latifannurdiansyah/Laser-tag-project/docs/final-report.docx

LAPORAN PROYEK AKHIR

Bidang

IMPLEMENTASI RANGKAIAN ELEKTRONIK DAN SISTEM KOMUNIKASI MULTI-PEMAIN UNTUK PERMAINAN LASER TAG MENGGUNAKAN ESP-NOW DAN LORA

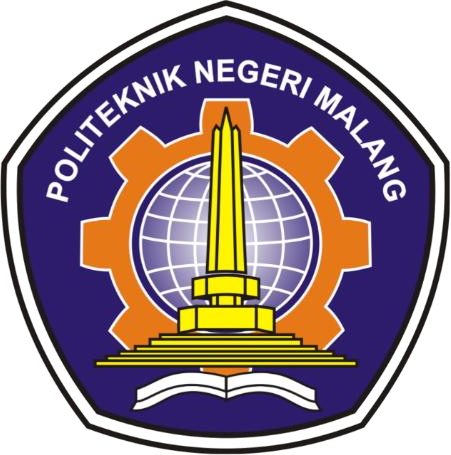
[picture p1: figure]
Logo Polinema (Politeknik Negeri Malang) Format PNG - laluahmad.com

OLEH:

LATIFAN NURDIANSYAH

NIM: 244101077012

PROGRAM STUDI SARJANA TERAPAN

TEKNIK ELEKTRONIKA

JURUSAN TEKNIK ELEKTRO

POLITEKNIK NEGERI MALANG

2026

LAPORAN PROYEK AKHIR

IMPLEMENTASI RANGKAIAN ELEKTRONIK DAN SISTEM KOMUNIKASI MULTI-PEMAIN UNTUK PERMAINAN LASER TAG MENGGUNAKAN ESP-NOW DAN LORA

Oleh:

Latifan Nurdiansyah NIM: 244101077012

PROGRAM STUDI SARJANA TERAPAN

TEKNIK ELEKTRONIKA

JURUSAN TEKNIK ELEKTRO

POLITEKNIK NEGERI MALANG

2026

# HALAMAN PENGESAHAN

IMPLEMENTASI RANGKAIAN ELEKTRONIK DAN SISTEM KOMUNIKASI MULTI-PEMAIN UNTUK PERMAINAN LASER TAG MENGGUNAKAN ESP-NOW DAN LoRa

Oleh:

Latifan Nurdiansyah

244101077012

Proyek Akhir ini telah dipertahankan di depan dewan penguji pada tanggal April 2026 dan disahkan oleh :

Pembimbing I
Nama Pembimbing I | : | Indrazno Siradjuddin, S.T., M.T., Ph.D.
NIP. | : | 197406242000121001 | ……………….
Pembimbing II
Nama Pembimbing II | : | Gillang Al Azhar, S.S.T., M.Tr.T.
NIP. | : | 199506222020121003 | ……………….
Penguji I
Nama Penguji I | : | Denda Dewatama, S.T., M.T.
NIP. | : | 197812272005011001 | ……………….
Penguji II
Nama Penguji II | : | Odhitya Desta Triswidrananta, S.Pd., M.Pd.
NIP. | : | 198912152023211020 | ……………….

Malang, 27 April 2026

Mengetahui, | Menyetujui,
Ketua Jurusan Teknik Elektro | Koordinator Program Studi Sarjana Terapan Teknik Elektronika
Prof. Ir. Mohammad Noor Hidayat, S.T., M.Sc., Ph.D. | Hari Kurnia Safitri, S.T., M.T.
NIP. 197409252001121003 | NIP. 197307132002122002

# PERNYATAAN KEASLIAN PROYEK AKHIR

Saya yang bertanda tangan di bawah ini:

Nama : | Latifan Nurdiansyah
NIM : | 244101077012
Jurusan/Program Studi : | Teknik Elektro/D4 Teknik Elektronika
Judul : | Implementasi rangkaian elektronik dan sistem komuikasi multi-pemain untuk permainan laser tag menggunakan ESP-NOW dan LORA

Menyatakan dengan sebenarnya bahwa:

1. Karya tulis ini benar – benar merupakan hasil karya saya sendiri, bukan merupakan alihan penelitian, tulisan atau pikiran orang lain yang saya akui sebagai hasil proyek akhir, tulisan atau pikiran saya sendiri.
2. Apabila di kemudian hari terbukti atau dapat dibuktikan bahwa karya tulis ini hasil jiplakan (plagiasi), dan saya tidak dapat memenuhi pernyataan saya ini maka saya bersedia menerima sanksi atas perbuatan saya tersebut.

Malang. 27 April 2026

Latifan Nurdiansyah

# ABSTRAK

Latifan Nurdiansyah, 2026. Implementasi Rangkaian Elektronik dan Sistem Komunikasi Multi-Pemain untuk Permainan Laser Tag Menggunakan ESP-NOW dan LoRa.

Proyek Akhir Program Studi Sarjana Terapan Teknik Elektronika, Jurusan Teknik Elektro, Politeknik Negeri Malang, 2026.

Sistem laser tag komersial berbasis Multiple Integrated Laser Engagement System (MILES) yang tersedia saat ini umumnya bersifat tertutup, minim informasi posisi real-time, serta rentan terhadap manipulasi fisik pada sensor inframerah. Kondisi ini membatasi penerapan sistem yang adaptif dan terukur untuk skenario rekreasi maupun kompetisi. Penelitian ini bertujuan untuk mengimplementasikan rangkaian elektronik pada unit senjata, helm, dan rompi dengan mengintegrasikan protokol ESP-NOW dan LoRa pada mikrokontroler ESP32-S3 guna menciptakan komunikasi dua arah dan pencatatan skor real-time melalui antarmuka web. Metodologi yang digunakan menerapkan arsitektur komunikasi dua lapis: ESP-NOW untuk interaksi cepat antar perangkat pada jarak dekat, dan LoRaWAN melalui The Things Network (TTN) untuk pengiriman data jarak jauh ke server berbasis Vercel. Selain itu, mekanisme Anti-Cheating inovatif diterapkan menggunakan photodiode dan gerbang logika NOR 8-input (IC 74HC4078) yang terintegrasi dalam dome sensor TSOP4838. Meskipun dibatasi pada dua unit pemain dengan modulasi inframerah 38 kHz (protokol NEC), pengujian menunjukkan performa yang sangat baik. Sistem mampu menerima sinyal inframerah hingga 200 meter dengan cakupan sudut 180°. Transmisi ESP-NOW mencatat tingkat keberhasilan 100% pada jarak 4 meter meskipun terdapat penghalang, sementara transmisi LoRaWAN berhasil sepenuhnya dengan latensi 3–5 detik. Secara keseluruhan, sistem mencapai hit rate 80% pada jarak 20 meter dalam skenario dua pemain, membuktikan efektivitasnya sebagai solusi laser tag yang transparan dan terukur.

Kata Kunci: Laser Tag, MILES, ESP-NOW, LoRa, Anti-Cheating, ESP32-S3, IoT.

# ABSTRACT

Latifan Nurdiansyah, 2026. Implementation of Electronic Circuits and Multi-Player Communication Systems for Laser Tag Games Using ESP-NOW and LoRa.

Proyek Akhir Program Studi Sarjana Terapan Teknik Elektronika, Jurusan Teknik Elektro, Politeknik Negeri Malang, 2026

Current commercial laser tag systems based on the Multiple Integrated Laser Engagement System (MILES) are generally closed-source, lack real-time positioning information, and are susceptible to physical tampering with Inframerah sensors. Such constraints hinder the implementation of adaptive and scalable systems for both recreational and competitive scenarios. This final project aims to implement electronic circuits in weapon units, helmets, and vests by integrating ESP-NOW and LoRa protocols onto the ESP32-S3 microcontroller to establish two-way communication and real-time score tracking via a web interface. The methodology employs a dual-layer communication architecture: ESP-NOW for rapid near-field device interaction and LoRaWAN via The Things Network (TTN) for long-range data transmission to a Vercel-base server. Additionally, an innovative Anti-Cheating mechanism is implemented using photodiodes and an 8- input NOR logic gate (IC 74HC4078) integrated within a TSOP4838 sensor dome. While limited to two player units utilizing 38 kHz Inframerah modulation (NEC protocol), test results demonstrate robust performance. The system successfully receives Inframerah signals up to 200 meters with a 180° coverage angle. ESP-NOW communication achieved a 100% success rate at 4 meters with obstacles, while LoRaWAN transmission was 100% successful with a latency of 3–5 seconds. Overall, the system reached an 80% hit rate at a 20-meter range in a two-player scenario, proving its effectiveness as a transparent and scalable laser tag solution.

Keywords: Laser Tag, MILES, ESP-NOW, LoRa, Anti-Cheating, ESP32-S3, IoT.

# KATA PENGANTAR

Puji syukur kehadirat Allah SWT yang telah melimpahkan rahmat serta hidayah-Nya, serta memberikan petunjuk serta kesehatan sehingga penulis dapat menyelesaikan Laporan Akhir yang berjudul “Implementasi Rangkaian Elektronik dan Sistem Komunikasi Multi-Pemain untuk Permainan Laser Tag Menggunakan ESP-NOW dan LoRa”. Pada kesempatan ini penulis mengucapkan terimakasih kepada pihak-pihak yang telah membantu dan membimbing dalam penyusunan Laporan Akhir, yaitu kepada :

1. Bapak Ir. Supriatna Adhisuwignjo, S.T., M.T. selaku Direktur Politeknik Negeri Malang beserta jajarannya.
2. Bapak Prof. Ir. Mohammad Noor Hidayat, S.T., M.Sc., Ph.D. selaku Ketua Jurusan Teknik Elektro beserta jajarannya.
3. Ibu Hari Kurnia Safitri, ST., MT. selaku Ketua Program Studi Sarjana Terapan Teknik Elektronika beserta jajarannya.
4. Bapak Indrazno Siradjuddin, S.T., M.T., Ph.D. selaku Dosen Pembimbing 1, yang telah membimbing dan mendampingi sepenuh hati dari awal hingga akhir penelitian proyek akhir ini.
5. Bapak Gillang Al Azhar, S.S.T., M.Tr.T. selaku Dosen Pembimbing 2, yang telah membimbing dari awal hingga akhir penelitian proyek akhir ini.
6. Seluruh Dosen dan Staff Politeknik Negeri Malang, khususnya pada Program Studi Sarjana Terapan Teknik Elektronika.
7. Orang tua dan Keluarga Besar Ma’ Saropah yang telah memberi dukungan do’a dan materi dan juga memberikan apapun yang aku butuhkan.
8. Teman Teman Lab Robotics Polinema yang dengan senang hati bertukar ilmu dan pikiran
9. Ahmad Firdan Al Hadi, Akbar Dimas Herdiansyah, Jati Wahyu Kusuma, Maharani Inggrid J. dan Syahrul Zanuar, mereka saya anggap seperti keluarga seperjuangan yang selalu memberikan motivasi untuk terus melangkah sampai dengan menyelesaikan laporan proyek akhir akhir saya.
10. Mahasiswa dengan NIM 2142520038 Jurusan Akutansi yang selalu memeberikan dukungan penulis dalam mengerjakan laporan ini dalam suka maupun duka, memberikan segenap rasa sakit, senang, semangat, motivasi, cinta dan kasih dalam membimbing dan membantu laporan proyek akhir saya sampai dengan selesai.
11. Teman-teman mahasiswa dan pihak yang telah membantu dalam penyusunan Laporan Akhir ini.

Penulis menyadari masih banyak kekurangan dan pembuatan proyek akhir ini. Oleh karena itu, penulis mengharapkan saran dan kritik yang bersifat membangun dan semoga proyek akhir ini dapat bermanfaat.

Malang, 27 April 2026

Penulis

# DAFTAR ISI

# DAFTAR GAMBAR

# DAFTAR TABEL

# BAB I PENDAHULUAN

## 1.1 Latar Belakang

Perkembangan teknologi digital telah membawa perubahan signifikan dalam dunia hiburan interaktif dan simulasi pelatihan militer modern. Salah satu manifestasinya adalah sistem Laser Tag berbasis Multiple Integrated Laser Engagement System (MILES), yaitu simulasi tempur yang menggunakan pancaran cahaya Inframerah sebagai pengganti peluru nyata. Pada sistem MILES, setiap senjata dilengkapi Small Arm Transmitter (SAT) yang memancarkan sinyal Inframerah berprotokol NEC berfrekuensi 38 kHz saat pelatuk ditarik, kemudian dideteksi oleh sensor penerima TSOP4838 pada rompi atau helm lawan (Siradjuddin et al., 2024). Meski efektif sebagai platform pelatihan maupun hiburan kompetitif, sistem MILES konvensional membutuhkan perangkat keras yang mahal, infrastruktur kompleks, dan konsumsi daya tinggi, sehingga sulit diterapkan secara luas pada komunitas dengan anggaran terbatas. Perkembangan teknologi Internet Of Things (IoT) kini membuka peluang baru untuk merancang sistem Laser Tag yang lebih terjangkau, modular, dan terhubung secara digital melalui kombinasi protokol ESP-NOW untuk komunikasi jarak dekat antar pemain, dan LoRaWAN untuk pengiriman data ke server pusat jarak jauh secara real-time (Hailan et al., 2024; Konate et al., 2025).

Beberapa penelitian sebelumnya telah mengembangkan sistem berbasis sinar inframerah (IR) untuk simulasi pertempuran, seperti Multiple Integrated Laser Engagement System (MILES), yang mampu mengidentifikasi pemain melalui kode digital dan memberikan umpan balik saat terkena tembakan (Siradjuddin et al., 2024). Meski efektif, sistem semacam ini biasanya membutuhkan perangkat keras mahal, konsumsi daya tinggi, dan infrastruktur yang kompleks—sehingga kurang layak untuk diterapkan dalam skenario rekreasi atau komunitas dengan anggaran terbatas.Perkembangan teknologi Internet Of Things (IoT) membuka peluang baru untuk merancang sistem Laser Tag yang lebih terjangkau, modular, dan terhubung. Dua protokol komunikasi nirkabel yang menarik untuk diintegrasikan adalah ESP-NOW dan LoRa. ESP-NOW, yang berjalan pada mikrokontroler ESP32, memungkinkan komunikasi peer-to-peer berkecepatan tinggi dengan latensi sangat rendah tanpa memerlukan jaringan Wi-Fi (Hailan et al., 2024). Protokol ini ideal untuk mengirimkan data tembakan antar pemain dalam jarak dekat (hingga ±30 meter), seperti dari helm ke rompi atau antar rompi pemain yang saling berinteraksi. Namun, jangkauannya terbatas, sehingga tidak memadai untuk arena permainan skala luas.

Di sisi lain, teknologi LoRa (Long Range) menawarkan kemampuan transmisi data hingga beberapa kilometer dengan konsumsi daya sangat rendah (Konate et al., 2025; Yahya et al., 2024). Dengan LoRa, data permainan—seperti skor, posisi berdasarkan modul GPS, atau status nyawa—dapat dikirim ke Gateway pusat dan ditampilkan melalui antarmuka web, memungkinkan pemantauan real-time oleh wasit, pelatih, atau penonton. Kombinasi kedua protokol ini menciptakan arsitektur komunikasi dua lapis: ESP-NOW untuk interaksi cepat antar pemain, dan LoRa untuk integrasi ke sistem eksternal jarak jauhBerdasarkan latar belakang maka, pada proyek akhir ini akan dikembangkan sistem Permainan Laser Tag Menggunakan ESP-NOW dan LoRa. Sistem yang dirancang terdiri dari helm dan rompi yang dilengkapi sensor Inframerah, modul GPS, serta modul komunikasi berbasis ESP32. Data dari hasil deteksi maupun posisi pemain akan dikirim melalui ESP-NOW dan LoRa ke server, lalu ditampilkan dalam bentuk web interface secara real-time.

## 1.2 Rumusan Masalah

Berdasarkan latar belakang di atas, dapat dirumuskan beberapa masalah sebagai berikut:

a. Bagaimana mengimplementasikan rangkaian elektronik pada sistem tembak (senjata) serta rangkaian penerima (helm dan rompi), dan membangun sistem komunikasi dua arah antara server dan banyak unit pemain?
b. Bagaimana mengintegrasikan protokol ESP-NOW dan LoRa pada mikrokontroler untuk mendukung komunikasi real-time dalam permainan Laser Tag?
c. Bagaimana mengimplementasikan sistem komunikasi dua arah untuk mendukung pencatatan skor secara real-time?

## 1.3 Batasan Masalah

Untuk memfokuskan proyek akhir, diberikan pembatasan masalah sebagai berikut:

a. Komunikasi nirkabel hanya menggunakan ESP-NOW (jarak dekat antar helm dan rompi) dan LoRa (jarak jauh ke server), dengan sistem terbatas pada maksimal 2 klien dan 1 server, serta hanya mengirim data status tanpa audio, video, atau enkripsi tingkat lanjut
b. Sistem hanya menggunakan sensor inframerah dengan modulasi 38 kHz sesuai protokol NEC, termasuk rangkaian IR receiver Anti-Cheating yang dirancang untuk beroperasi di siang hari, dan khusus diterapkan dalam permainan laser tag.
c. Sumber daya dibatasi pada baterai lithium-ion untuk senjata, rompi, dan helm, tanpa membahas alternatif sumber daya, pengisian daya, lokasi minim sinyal seluler, maupun aspek keamanan siber atau enkripsi data.
d. Anti-Cheating tidak difungsikan dalm kondisi merayap, terhalang pohon/bangunan

## 1.4 Tujuan

Berdasarkan rumusan masalah yang telah ditetapkan terdapat beberapa tujuan dari proyek akhir ini. Berikut merupakan tujuan dari proyek akhir ini:

a. Mengimplementasikan rangkaian elektronik pada sistem tembak (senjata) serta rangkaian penerima (helm dan rompi) dan sistem komunikasi dua arah antara server dan banyak unit pemain
b. Mengintegrasikan protokol ESP-NOW dan LoRa pada mikrokontroler untuk mendukung komunikasi real-time dalam permainan Laser Tag.
c. Mengembangkan sistem komunikasi dua arah untuk mendukung pencatatan skor secara real-time.

## 1.5 Sistematika Penulisan

Pembahasan dalam proyek akhir ini disusun secara terstruktur dalam lima bab utama, yang masing-masing memiliki fokus tersendiri sesuai dengan alur proyek akhir dan pengembangan sistem. Sistematika penulisan pada laporan proyek akhir ini :

Bab I Pendahuluan

Bab ini berisi latar belakang pemilihan topik proyek akhir, rumusan masalah beserta batasan masalah yang diteliti. Selain itu, juga dijelaskan tujuan proyek akhir serta manfaat yang ingin dicapai. Bab ini juga memberikan gambaran umum mengenai struktur penulisan laporan proyek akhir.

Bab II Tinjauan Pustaka

Bab ini membahas materi teoretis yang relevan dengan proyek akhir, termasuk konsep-konsep dasar, teknik, peralatan, atau teknologi yang digunakan dalam proses proyek akhir. Selain itu, juga disertakan referensi pustaka dan hasil proyek akhir sebelumnya yang menjadi dasar pengembangan sistem.

Bab III Metodologi

Bab ini menjelaskan secara rinci pendekatan atau metode yang digunakan dalam melaksanakan proyek akhir. Meliputi desain sistem, tahapan pengembangan, alur kerja, serta langkah-langkah yang dilakukan untuk mencapai tujuan proyek akhir.

Bab IV Hasil Dan Pembahasan

Pada bab ini disajikan hasil implementasi sistem, data pengujian perblok dan keseluruhan, serta analisis yang dilakukan berdasarkan metode proyek akhir yang telah ditetapkan. Pembahasan bertujuan untuk mengevaluasi kinerja sistem dan membandingkannya dengan tujuan serta hipotesis awal.

Bab V Penutup

Bab terakhir ini memuat kesimpulan utama dari seluruh rangkaian proyek akhir, berdasarkan hasil dan pembahasan yang telah diuraikan. Selain itu, juga disertakan saran-saran untuk pengembangan sistem pada proyek akhir lanjutan.

## 1.6 Luaran Laporan Proyek Akhir

Proyek akhir ini memiliki 4 luaran yaitu

a. Naskah Laporan proyek akhir
b. Alat Sistem berupa senjata, helm dan rompi
c. Manual Book
d. Artikel yang disubmit di jurnal yang ber-ISSN.

# BAB II TINJAUAN PUSTAKA

## 2.1 Kajian Pustaka

Berikut adalah beberapa hasil penelitian terdahulu yang relevan dengan topik proyek akhir ini dan dapat digunakan sebagai landasan dan tinjauan pustaka untuk mendukung acuan proyek akhir ini sebagai berikut.

Dalam dunia pelatihan militer modern, simulasi tempur yang realistis dan aman menjadi kebutuhan utama untuk meningkatkan kesiapan tempur tanpa harus mengorbankan nyawa atau menggunakan amunisi aktif. Salah satu teknologi yang telah lama dikembangkan dan digunakan secara luas untuk tujuan ini adalah Multiple Integrated Laser Engagement System (MILES). Sistem ini memungkinkan simulasi pertukaran tembakan antar personel atau kendaraan tempur dengan menggunakan pancaran cahaya Inframerah (IR) sebagai pengganti peluru. Pada sistem MILES, setiap senjata dilengkapi dengan perangkat yang disebut Small Arm Transmitter (SAT), yang memancarkan sinyal Inframerah saat pelatih menembakkan senjata. Sinyal ini kemudian dideteksi oleh sensor IR pada lawan, yang mencatat "kena tembak" berdasarkan data identitas pemain (Player ID/PID) yang turut dikodekan dalam sinyal tersebut. Oleh karena itu, performa SAT sangat menentukan keberhasilan simulasi, termasuk jangkauan deteksi, akurasi respon waktu, dan reliabilitas transmisi data.(Siradjuddin et al., 2024).

Salah satu komponen krusial dalam SAT adalah Inframerah (IR) emitter Driver circuit, yang mengendalikan arus listrik ke LED Inframerah berdaya tinggi, memastikan pancaran cahaya IR dengan intensitas optimal dan waktu respons yang cepat. Desain rangkaian ini menjadi fokus utama dalam proyek akhir (Siradjuddin et al., 2024), yang memperkenalkan rancangan baru sirkuit penggerak emitter Inframerah khusus untuk aplikasi SAT dalam sistem MILES. Tujuan dari desain ini adalah untuk memaksimalkan daya optik dan memastikan frekuensi pensaklaran 38 kHz yang sesuai dengan standar protokol komunikasi IR NEC, yang menjadi kunci dalam efektivitas komunikasi Inframerah.(Siradjuddin et al., 2024)

Menurut jurnal Wireless Inframerah Communications: A Survey, komunikasi Inframerah memanfaatkan propagasi cahaya pada pita near-Inframerah dengan pemancar berupa LED atau laser diode dan penerima berupa silicon p-i-n photodiode karena efisiensinya yang baik dan biaya rendah. Sistem ini menggunakan teknik Intensity Modulation with Direct Detection (IM/DD), di mana arus fotodetektor sebanding dengan intensitas optik yang diterima. Namun, penerimaan sinyal dapat terganggu oleh sumber cahaya sekitar seperti sinar matahari atau lampu, sehingga diperlukan filter optik dan pemilihan modulasi yang tepat untuk menjaga kualitas sinyal. Sementara itu, menurut jurnal Wireless Inframerah Communications, komunikasi Inframerah menawarkan keunggulan dibanding radio, seperti bandwidth yang sangat besar, biaya rendah, serta keamanan tinggi karena sinyal tidak menembus dinding. Selain itu, penggunaan IM/DD dengan detektor berukuran besar mencegah terjadinya multipath fading, sehingga desain sistem lebih sederhana. Meski begitu, keterbatasan komunikasi Inframerah adalah jangkauannya yang terbatas, kebutuhan daya pancar relatif tinggi, serta sensitivitas terhadap noise cahaya sekitar.(Kahn & Barry, 1997; Zade et al., 2012)

Menurut jurnal Penerapan Protokol Komunikasi ESP-NOW pada Portable Traffic Light, implementasi komunikasi berbasis ESP-NOW dengan skema master–slave mampu bekerja stabil dengan tingkat error rata-rata hanya 3% dan jangkauan optimal hingga 25 meter meskipun terdapat halangan berupa casing modul. Sementara itu, pada jurnal ESPNOW Protocol-Based IIoT System for Remotely Monitoring and Controlling Industrial Systems, ESP-NOW dimanfaatkan untuk menghubungkan beberapa node sensor dalam sistem Industrial Internet Of Things (IIoT), yang terbukti mendukung pemantauan industri secara real-time dengan latensi rendah, konsumsi daya hemat, serta keamanan data yang terjamin melalui enkripsi. Di sisi lain, proyek akhir berjudul Indoor Performance Evaluation of ESP-NOW mengevaluasi performa ESP-NOW dalam kondisi indoor dan menemukan bahwa meskipun faktor lingkungan seperti pantulan dan penghalang dapat memengaruhi kinerja, protokol ini tetap menunjukkan efisiensi daya lebih dari 30% dibanding Wi-Fi serta jangkauan yang lebih baik hingga 15%. Berdasarkan temuan-temuan tersebut, ESP-NOW sangat relevan untuk digunakan pada sistem permainan Laser Tag, di mana komunikasi antar perangkat harus berlangsung cepat, stabil, dan hemat daya dalam area permainan.(Fajar Arofah et al., 2023; Hailan et al., 2024; Urazayev et al., 2023)

Menurut proyek akhir Design and Implementation of a Backscatter Communication System Based on LoRa Technology, LoRa backscatter mampu meningkatkan efisiensi energi dan memperluas jangkauan komunikasi dengan memanfaatkan sinyal pantulan dari perangkat pasif, sehingga sangat potensial untuk aplikasi IoT berskala besar. Sementara itu, dalam jurnal Analisa Performansi Komunikasi LoRa (Long Range) pada Sistem Monitoring Buoy di Laut, komunikasi LoRa 915 MHz terbukti dapat menjaga kualitas dengan nilai RSSI rata-rata lebih baik dari -120 dB dan SNR lebih besar dari -20 dB meskipun terdapat interferensi, sehingga layak digunakan untuk sistem monitoring di lingkungan laut. Selanjutnya, hasil proyek akhir Analisis Jarak Jangkauan LoRa (Long Range) di Lingkungan Urban, menunjukkan bahwa jangkauan LoRa di area perkotaan dapat mencapai hingga 2 km dengan nilai RSSI relatif stabil, meskipun packet loss meningkat pada jarak yang lebih jauh. Dari ketiga kajian tersebut dapat disimpulkan bahwa LoRa tidak hanya handal untuk komunikasi jarak jauh dengan konsumsi energi rendah, tetapi juga fleksibel untuk diterapkan dalam berbagai skenario, baik di laut, lingkungan urban, maupun melalui dukungan teknologi backscatter.(Konate et al., 2025; Nihayatus Sa’adah et al., 2024; Yanziah et al., 2020)

Global Positioning System (GPS) merupakan sistem navigasi berbasis satelit yang terdiri dari 24 satelit operasional yang mengorbit Bumi dan menyediakan informasi posisi secara kontinu melalui tiga segmen utama, yaitu segmen pengguna, ruang angkasa, dan kontrol, dimana menurut jurnal "Implementation of GPS for Location Tracking", data yang diterima berupa format NMEA-0183 yang berisi koordinat latitude dan longitude yang perlu diekstrak untuk memperoleh data posisi. Menurut jurnal "Missing Pilgrims Tracking System Using GPS, GSM and Arduino Microcontroller", GPS merupakan sistem navigasi universal yang dapat bekerja dalam segala kondisi cuaca dan dapat dikombinasikan dengan teknologi GSM untuk menghasilkan sistem pelacakan berbasis peta digital, sementara jurnal "A GPS Receiver for High-Altitude Satellite Navigation" mengatakan bahwa GPS telah digunakan untuk navigasi satelit presisi di orbit rendah Bumi (LEO), meskipun penerapannya di orbit geosinkron (GEO) masih terbatas akibat lemahnya sinyal. Lebih lanjut, GPS merupakan bagian dari GNSS (Global Navigation Satellite System) bersama dengan GLONASS, BeiDou, dan Galileo, dengan akurasi 3–10 meter di lingkungan outdoor, namun menurun menjadi 30–100 meter di indoor sehingga mendorong pengembangan Indoor Positioning System (IPS) berbasis RTK dengan akurasi hingga 2 cm atau teknologi UWB dengan akurasi 20 cm, serta aspek waktu yang penting dimana distribusi UTC melalui sinyal GPS memiliki akurasi ≤30 nanodetik.(Ariffin et al., 2011; Itera, 2021; Parveen & Aldhlan, 2016; Winternitz et al., 2009)

Menurut proyek akhir Web Server Based Smart Agriculture System for Real-Time Monitoring and Control, pemanfaatan web server dalam integrasi IoT memungkinkan penyajian data sensor secara real-time melalui dashboard interaktif yang mendukung sistem pertanian cerdas. Hal ini sejalan dengan studi A Web Server-Based IoT System for Monitoring and Control of Agricultural Environment, yang menekankan pentingnya akses global dan pengelolaan data terdistribusi secara aman melalui jaringan berbasis web. Lebih lanjut, proyek akhir Real-Time Monitoring of Cable Sag and Overhead Line Parameters Based on a Distributed Sensor Network and Implementation in a Web Server and IoT, menunjukkan bagaimana web server dipadukan dengan database MySQL dan IoT server untuk memantau kondisi kabel transmisi listrik secara aman, baik melalui intranet maupun internet. Sementara itu, jurnal Web-Based Integration of IoT and Artificial Intelligence for Monitoring Aquariums, menegaskan bahwa dashboard web mampu membangun visualisasi interaktif yang membantu pengawasan kondisi lingkungan, seperti suhu, pH, dan kecerahan air pada sistem akuarium pintar. Dari keempat kajian tersebut, dapat disimpulkan bahwa web server berperan penting dalam integrasi IoT, tidak hanya untuk pemantauan data sensor secara real-time, tetapi juga dalam mendukung keamanan akses, keterhubungan global, serta pengembangan dashboard interaktif yang relevan untuk berbagai bidang, mulai dari pertanian, energi, hingga sistem hiburan seperti permainan Laser Tag.(Deepika & Renuka Prasad, 2023; Guerbaoui et al., 2025; Nicola et al., 2024; Nugraha & Rosita, 2024).

## 2.2 Teori Penunjang

### 2.2.1 Baterai Lithium Ion

Baterai Lithium-Ion (Li-ion) merupakan salah satu jenis sel baterai sekunder (rechargeable) yang paling banyak digunakan dalam sistem elektronika portabel dan perangkat berbasis mikrokontroler. Keunggulannya terletak pada rapat energi yang tinggi, konsumsi daya rendah, dan ukuran yang kompak (Lesmana et al., 2023). Dalam aplikasi sistem embedded seperti yang dirancang pada proyek akhir ini, baterai Lithium-Ion sering dikonfigurasi dalam bentuk pack seri untuk menghasilkan tegangan yang sesuai dengan kebutuhan sistem. Misalnya, konfigurasi 2S (2 seri) menghasilkan tegangan nominal sekitar 7,4 V, yang dapat digunakan untuk menyuplai daya ke mikrokontroler, motor, modul komunikasi, dan sensor melalui regulator tegangan (step-down converter). Dengan rumus pemakaian sebagai berikut:

Kapasitas Baterai (mAh) = Arus (mA) × Waktu (jam)

Dalam proyek permainan laser tag ini baterai Lithium Ion digunakan sebagai catu daya pada senjata, helm dan juga rompi. Pemilihan baterai ini didasarkan pada kemampuannya menyediakan energi secara efisien dengan bobot yang ringan, sehingga memungkinkan perangkat beroperasi secara mandiri di lapangan tanpa ketergantungan pada sumber daya eksternal. Hal ini sangat penting dalam mendukung mobilitas tinggi dan fleksibilitas gerak selama permainan berlangsung.

Penggunaan baterai Lithium-Ion memerlukan perlakuan khusus pada proses pengisian daya agar performa dan umur pakai baterai tetap terjaga. Proses pengisian baterai Li-ion umumnya menggunakan metode Constant Current–Constant Voltage (CC-CV), yaitu pengisian dengan arus konstan pada tahap awal dan dilanjutkan dengan tegangan konstan hingga baterai mencapai kondisi penuh. Pada penelitian ini digunakan charger Black Cell tipe XH1000/XH2000 yang mendukung baterai Li-ion 2S 7,4 V dengan fitur intelligent smart charging dan balance charging. Fitur tersebut memungkinkan setiap sel baterai diisi secara seimbang sehingga dapat meningkatkan keamanan dan memperpanjang usia pemakaian baterai.

Selain metode pengisian yang tepat, baterai Li-ion juga harus dilengkapi dengan sistem proteksi seperti Battery Management System (BMS) atau modul protection untuk mencegah terjadinya overcharge, overdischarge, arus berlebih, serta hubungan singkat. Tegangan baterai tidak disarankan turun terlalu rendah karena dapat menyebabkan penurunan kapasitas dan kerusakan sel. Penggunaan arus pengisian yang sesuai dengan kapasitas baterai juga perlu diperhatikan agar suhu baterai tetap stabil selama proses charging berlangsung. Pada baterai tipe 14500, arus pengisian sebesar 1 A dinilai lebih aman dan sesuai dibandingkan arus yang terlalu besar.

Berdasarkan karakteristik tersebut, baterai Lithium-Ion sangat sesuai digunakan pada sistem permainan laser tag karena mampu menyediakan suplai daya yang stabil, ringan, dan mudah diisi ulang. Namun demikian, perlakuan terhadap baterai harus dilakukan dengan benar, terutama pada proses charging dan penggunaan sehari-hari, agar sistem dapat bekerja secara optimal serta menjaga keamanan pengguna dan perangkat elektronika yang digunakan.

### 2.2.2 Regulator Tegangan

Regulator tegangan adalah perangkat yang digunakan untuk menjaga kestabilan tegangan pada suatu sistem kelistrikan, meskipun terjadi fluktuasi pada tegangan masukan. Fungsi utama regulator tegangan adalah untuk memastikan tegangan output tetap pada nilai yang diinginkan, melindungi perangkat elektronik atau sistem yang sensitif terhadap perubahan tegangan yang ekstrem. Regulator tegangan dapat dibedakan menjadi dua jenis utama, yaitu regulator linear dan regulator switching. Regulator linear menurunkan tegangan dengan cara mengalirkan arus melalui komponen pengatur, namun sering menghasilkan banyak panas dan kurang efisien. Sementara regulator switching menggunakan metode pemutusan dan penyambungan untuk mengatur tegangan dengan lebih efisien, menghasilkan sedikit energi terbuang.

Prinsip kerja regulator tegangan didasarkan pada kemampuan untuk mengontrol aliran listrik sesuai dengan perbedaan antara tegangan masukan dan tegangan output yang diinginkan. Regulator linear mengurangi tegangan melalui komponen elektronik seperti transistor, Rangkaian dasar regulator tegangan yang digunakan dalam sistem ini ditunjukkan pada Gambar 1 regulator ini mampu menghasilkan tegangan keluaran stabil pada 5 V dengan toleransi antara 4,75 V hingga 5,25 V, meskipun terdapat variasi pada tegangan masukan (7–25 V) maupun perubahan arus beban (5 mA hingga 1,5 A). Regulator ini memiliki tingkat penolakan ripple yang tinggi (62–78 dB), resistansi output sangat rendah (sekitar 0,017 Ω), serta noise output kecil (sekitar 40 µV), sehingga mampu memberikan suplai daya yang bersih untuk rangkaian sensitif. Selain itu, dropout voltage sekitar 2 V menunjukkan bahwa tegangan masukan minimal harus lebih besar dari 7 V untuk menghasilkan 5 V stabil pada keluaran. Dengan adanya proteksi arus pendek hingga 750 mA serta kemampuan arus puncak hingga 2,2 A, LM7805 menjadi regulator tegangan yang handal untuk berbagai aplikasi elektronika..

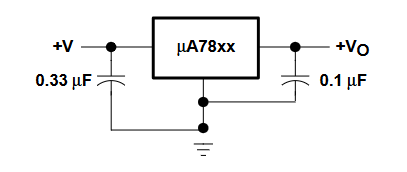
[picture p2: figure]

Gambar 1 Regulator LM7805

Sumber: Datasheet LM7805(Texas, 1976)

### 2.2.3 Rangkaian Push Pull

Rangkaian Push-Pull merupakan konfigurasi elektronika daya yang menggunakan dua transistor aktif (biasanya satu NPN dan satu PNP, atau satu NMOS dan PMOS) untuk mengendalikan arus beban ke atas dan ke bawah secara bergantian. Konfigurasi ini memungkinkan sirkuit menghasilkan output dengan impedansi rendah, kemampuan sinkronisasi tinggi, serta respon frekuensi yang baik. Rangkaian Push-Pull banyak digunakan dalam penguat daya (power amplifier), penggerak motor, dan aplikasi digital seperti Driver MOSFET atau buffer logika.

Dalam konteks sistem simulasi tembakan berbasis sensor, rangkaian Push-Pull dapat diterapkan sebagai unit penguat (amplifier) untuk pulsa inframerah atau sebagai Driver untuk aktuator seperti buzzer, LED, atau motor miniatur pada alat pelatihan tempur. Rangkaian Push-Pull bekerja dengan prinsip bahwa salah satu transistor berfungsi "mendorong" arus (push) ke beban, sedangkan transistor lainnya berfungsi "menarik" arus (pull) dari beban, bergantung pada polaritas sinyal input. Dengan demikian, rangkaian mampu menghasilkan gelombang keluaran yang simetris dan hampir tidak terdistorsi.

Konfigurasi Dasar:

- Transistor atas (push): Biasanya tipe PNP atau PMOS, aktif saat sinyal input bernilai negatif atau rendah, menyalurkan arus dari VCC ke beban.
- Transistor bawah (pull): Tipe NPN atau NMOS, aktif saat sinyal input bernilai positif atau tinggi, menyalurkan arus dari beban ke ground.
- Beban (load): Terhubung di titik tengah (midpoint) antara kedua transistor.

Ketika sinyal input bernilai tinggi (positif), transistor NPN (bawah) aktif sehingga beban terhubung ke ground. Sebaliknya, ketika sinyal input bernilai rendah (negatif), transistor PNP (atas) aktif sehingga beban mendapatkan arus dari VCC. Hasilnya adalah beban selalu dalam kondisi tereksitasi oleh salah satu transistor, tanpa kondisi high-impedance (floating). Berikut merupakan gambar Rangkaian Dasar Push-Pull dapat dilihat pada Gambar berikut.

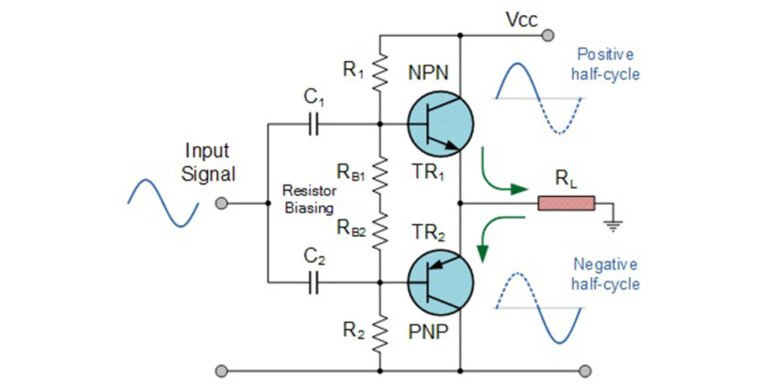
[picture p3: figure]
Push-pull output high and low level voltage diagram

Gambar 2 Rangkaian Dasar Push-Pull

Sumber: (Instrument, 2021)

Analisis matematis rangkaian Push-Pull mengacu pada karakteristik transistor bipolar (BJT) maupun MOSFET. Berikut adalah persamaan-persamaan dasar yang digunakan dalam perancangan:

a. Arus Kolektor Transistor (BJT)

Arus kolektor (IC) transistor BJT dinyatakan sebagai fungsi dari arus basis (IB) dan penguatan arus (hFE atau β):

IC = β × IB

Keterangan:

IC = Arus kolektor (A)

β (hFE) = Penguatan arus DC transistor (dari datasheet)

IB = Arus basis (A)

b. Tegangan Saturasi dan Cutoff

Transistor bekerja dalam dua mode utama pada rangkaian Push-Pull:

- Saturasi (ON): VCE ≈ VCE(sat), umumnya 0,2–0,4 V untuk BJT.
- Cutoff (OFF): IC ≈ 0, transistor tidak mengalirkan arus.

VOUT = VCC - VCE(sat)

Keterangan:

VOUT = Tegangan output pada kondisi saturasi (V)

VCC = Tegangan catu daya (V)

VCE(sat) = Tegangan saturasi kolektor-emitter (V), dari datasheet

c) Arus Beban (Load Current)

Arus yang mengalir melalui beban dihitung berdasarkan tegangan output dan nilai resistansi beban:

ILOAD = VOUT / RLOAD

Keterangan:

ILOAD = Arus yang mengalir ke beban (A)

VOUT = Tegangan output rangkaian (V)

RLOAD = Resistansi beban (Ohm, Ω)

d) Daya Disipasi Transistor

Daya yang didisipasikan oleh masing-masing transistor saat kondisi aktif adalah:

PD = VCE × IC

Nilai PD harus lebih kecil dari PD(max) yang tertera pada datasheet transistor untuk mencegah kerusakan termal. Apabila diperlukan heatsink, maka resistansi termal total dihitung sebagai:

θJA = (TJ(max) - TA) / PD

Keterangan:

PD = Daya disipasi transistor (Watt)

VCE = Tegangan kolektor-emitter saat aktif (V)

IC = Arus kolektor (A)

θJA = Resistansi termal junction-ke-ambient (°C/W)

TJ(max) = Suhu junction maksimum (°C), dari datasheet

TA = Suhu ambient (°C)

e) Efisiensi Rangkaian Push-Pull Kelas B

Efisiensi teoritis maksimum untuk Push-Pull Kelas B adalah:

ηmax = (π/4) × (VOUT(peak)/VCC) × 100%

Pada kondisi sinyal penuh (VOUT(peak) ≈ VCC), efisiensi teoritis maksimum Push-Pull Kelas B mencapai π/4 × 100% ≈ 78,5%, jauh lebih tinggi dibandingkan penguat Kelas A (≤25%).

### 2.2.4 Transmitter Inframerah

Transmiter Inframerah adalah perangkat elektronik yang menggunakan sinyal Inframerah untuk mengirimkan data atau perintah kepada perangkat penerima. Sinyal Inframerah dihasilkan oleh Light Emitting Diode (LED) Inframerah yang mengubah data digital menjadi pulsa cahaya. Pulsa ini diterima oleh sensor penerima seperti Phototransistor, yang kemudian mendekodekannya menjadi data digital kembali. Panjang gelombang Inframerah yang umum digunakan berkisar antara 700 nm hingga 1 mm, tergantung pada aplikasinya.

Transmitter Inframerah menawarkan kecepatan transfer data yang tinggi, keamanan yang baik karena sinyalnya tidak menembus dinding, serta biaya produksi yang relatif rendah. Namun, teknologinya memiliki keterbatasan, seperti kebutuhan akan jalur pandang langsung antara Transmitter dan receiver serta kerentanan terhadap interferensi dari cahaya matahari (Yunardi, 2017).

Inframerah LED (IR LED) adalah jenis dioda emisi cahaya (LED) yang memancarkan radiasi elektromagnetik pada panjang gelombang Inframerah (~700 nm hingga 1 mm), yang tidak terlihat oleh mata manusia namun dapat dideteksi oleh photodiode atau fototransistor IR. Cahaya Inframerah yang dipancarkan oleh LED ini sering digunakan dalam sistem remote control, proximity sensing, pendeteksi gerakan, dan komunikasi nirkabel jarak dekat. Berikut merupakan gambar Inframerah LED dapat dilihat pada Gambar 9.

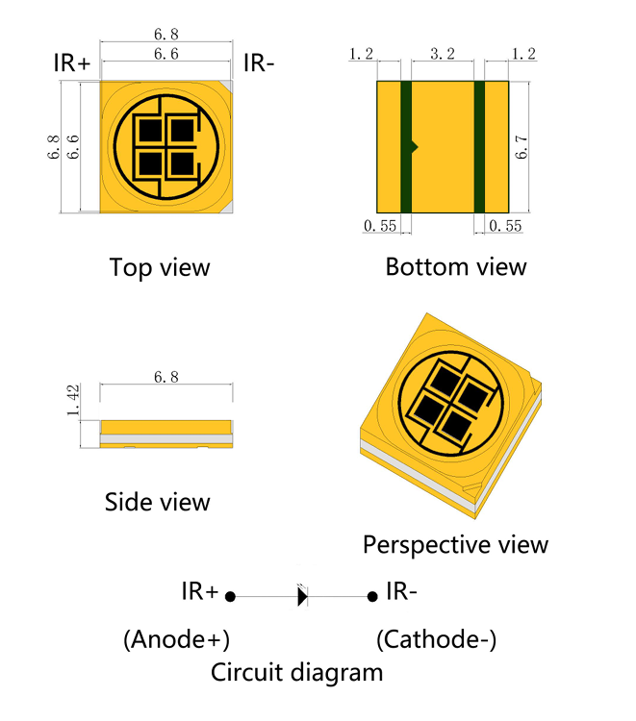
[picture p4: figure]

Gambar 3 Inframerah LED

Sumber: M. Ali et al. (2021)

Prinsip kerja IR LED pada gambar 2.15 mirip dengan LED biasa, yaitu mengubah arus listrik menjadi foton cahaya. Namun, material semikonduktor yang digunakan dirancang agar memancarkan cahaya di rentang Inframerah. Pada sistem permainan laser tag, IR LED digunakan sebagai bagian dari Small Arms Transmitter (SAT) untuk memancarkan pulsa Inframerah setiap kali pelatuk senjata ditarik. Pulsa tersebut membawa informasi identifikasi senjata dan waktu penembakan yang akan diterima oleh sensor IR pada target.

IR LED dalam SAT harus dirancang untuk bekerja dalam kondisi lapangan yang keras, termasuk paparan debu, guncangan fisik, dan variasi suhu. Oleh karena itu, banyak modul IR LED dilengkapi dengan lensa Fresnel untuk meningkatkan jarak pancar dan akurasi deteksi. Selain itu, pulsa yang dikirimkan bersifat encoded agar dapat dibedakan antara tembakan dari satu senjata dengan senjata lain, memastikan evaluasi hasil tembakan akurat dan real-time.

### 2.2.5 Modulasi dan Demodulasi Inframerah

Modulasi dan demodulasi Inframerah merupakan dua proses yang saling terkait dalam komunikasi berbasis cahaya Inframerah. Modulasi adalah proses menumpangkan sinyal informasi (misalnya data digital) pada gelombang pembawa Inframerah, sedangkan demodulasi adalah proses memisahkan kembali sinyal informasi dari gelombang pembawa yang telah dimodulasi.

1. Modulasi Inframerah

Modulasi Inframerah adalah proses memodifikasi sinyal Inframerah untuk membawa informasi spesifik seperti perintah kontrol maupun data digital. Teknologi ini sangat penting pada aplikasi seperti sistem komunikasi nirkabel yang menggunakan diode pemancar Inframerah (IR) dan penerima IR, misalnya pada perangkat kontrol jarak jauh, sensor kedekatan, serta sistem pengenalan dan keamanan serupa lainnya.

Dalam modulasi Inframerah, impuls cahaya yang dipancarkan oleh IR-LED dimodulasi sesuai dengan pola biner yang mewakili data. Proses ini dilakukan dengan mengatur arus penggerak pada IR-LED, sehingga intensitas cahaya Inframerah berubah sesuai dengan data yang ingin ditransmisikan.

Metode modulasi yang paling umum digunakan adalah Carrier Frequency Modulation (CFM), yaitu modulasi pada frekuensi pembawa. Pada sistem ini, sinyal data digunakan untuk mendukung atau mengubah fase dan amplitudo gelombang pembawa Inframerah pada frekuensi tertentu (biasanya 36-38kHz). Teknik ini memungkinkan penerima Inframerah dapat membedakan sinyal yang sengaja dikirim dan noise dari cahaya lingkungan sekitar.

2. Demodulasi Inframerah

Demodulasi Inframerah adalah proses pemulihan sinyal informasi dari gelombang Inframerah yang telah dimodulasi di sisi pemancar. Proses ini dilakukan oleh penerima Inframerah (IR receiver) untuk mengubah impuls optik menjadi data biner atau perintah digital, yang selanjutnya dapat diproses oleh sistem kontrol atau mikrokontroler.

Pada sistem komunikasi Inframerah seperti kontrol jarak jauh dan sensor nirkabel, sinyal data umumnya tidak ditransmisikan sebagai cahaya kontinu, melainkan dimodulasi pada frekuensi pembawa (36-38kHz). Proses demodulasi di penerima digunakan untuk memisahkan frekuensi pembawa dan mengekstrak data asli yang dibawa oleh sinyal Inframerah.

### 2.2.6 Gelombang Inframerah

Gelombang Inframerah merupakan bagian dari spektrum elektromagnetik yang terletak di antara cahaya tampak dan gelombang mikro, dengan panjang gelombang berkisar antara 700nm hingga 1mm. Meskipun tidak dapat dilihat oleh mata manusia, radiasi Inframerah dapat dirasakan sebagai panas dan telah dimanfaatkan dalam berbagai aplikasi teknologi, seperti pemantauan suhu, deteksi gerakan, serta sistem komunikasi nirkabel. Berikut merupakan gambar dari Panjang Gelombang dapat dilihat pada Gambar 5.

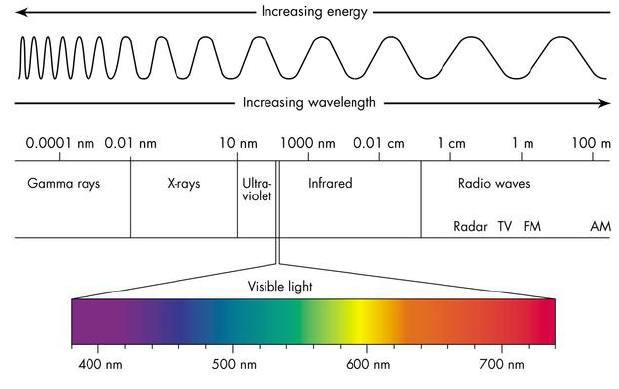
[picture p5: figure]

Gambar 4 Panjang Gelombang

Sumber: National Radio Astronomy Observatory (2012)

Dalam system permainan laser tag, gelombang Inframerah digunakan untuk mentransmisikan data tembakan dari senjata ke sensor penerima pada target. Pulsa Inframerah ini membawa informasi penting seperti ID senjata, waktu penembakan, dan lokasi tembakan. Sensor penerima kemudian menganalisis data tersebut untuk menentukan apakah tembakan tersebut mengenai area vital atau tidak. Proses ini memastikan bahwa sistem dapat memberikan umpan balik instan kepada para pemain terkait status “terkena tembakan” secara akurat.

Pulsa Inframerah yang digunakan pada senjata umumnya berada pada rentang Near Inframerah (NIR), yaitu antara 700–1.400nm. Rentang ini dipilih karena banyak material optik memiliki transmisi tinggi di wilayah tersebut, sehingga pulsa dapat diterima dengan baik oleh sensor Inframerah. Selain itu, sinar Inframerah dalam rentang ini relatif aman untuk penggunaan luar ruang (outdoor) dan tidak terganggu oleh cahaya tampak, menjadikannya pilihan ideal dalam sistem pelatihan tempur modern.

### 2.2.7 Nippon Electric Company Protocol

Nippon Electric Company (NEC) adalah salah satu standar komunikasi Inframerah yang sering digunakan pada perangkat kontrol jarak jauh, televisi, pendingin ruangan, pemutar DVD, serta berbagai alat elektronik lainnya, terutama yang dibuat di Jepang. Protokol ini dikembangkan oleh perusahaan Jepang bernama NEC dan telah menjadi salah satu protokol komunikasi Inframerah yang paling banyak digunakan karena sifatnya yang mudah dipahami, efisien, serta mudah diimplementasikan dalam berbagai aplikasi teknologi terhubung (IoT).

Pada protokol NEC, komunikasi terjadi melalui pengiriman sinyal cahaya Inframerah dari remote control ke penerima di perangkat yang dituju. Sinyal tersebut berupa pola waktu yang mewakili data berbentuk biner. Protokol NEC memiliki beberapa ciri khas seperti frekuensi 38 kHz, panjang data sebanyak 32 bit atau 4 byte, alamat perangkat sepanjang 8 bit, serta mampu mengulang sinyal setiap 110 ms.

### 2.2.8 Jarak Transmisi Bahan Optik

Jarak transmisi bahan optik merujuk pada kemampuan suatu material untuk meneruskan gelombang elektromagnetik seperti cahaya tampak atau inframerah tanpa banyak menyerap atau memantulkannya (Smith, W. J., 2020). Setiap bahan memiliki karakteristik transmisi berbeda tergantung pada panjang gelombang cahaya yang digunakan. Misalnya, kaca borosilikat memiliki transmisi tinggi pada cahaya tampak, sementara polikarbonat atau akrilik lebih cocok untuk transmisi inframerah dekat (NIR).

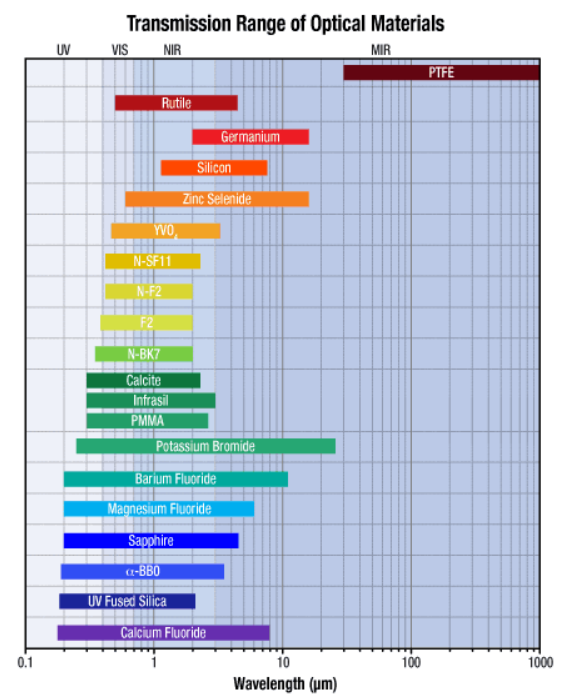
[picture p6: figure]

Gambar 5 Transmisi Bahan Optik

Sumber: Applied Optics (2008)

Panjang gelombang cahaya sangat mempengaruhi seberapa besar cahaya dapat ditransmisikan melalui bahan. Beberapa bahan seperti silikon (Si) dan selenium seng (ZnSe) memiliki transmisi tinggi di rentang inframerah dekat (NIR), sehingga sangat cocok untuk aplikasi seperti LED IR dan sensor IR. Di sisi lain, bahan seperti fluorit kalsium (CaF₂) dan fluorit barium (BaF₂) memiliki transmisi tinggi di rentang UV hingga NIR, menjadikannya pilihan populer dalam sistem optik tingkat tinggi.

Ketebalan dan kejernihan bahan juga memainkan peran penting dalam transmisi cahaya. Bahan yang lebih tipis dan bebas cacat atau gelembung udara akan memiliki transmisi yang lebih baik. Sudut datang cahaya juga memengaruhi efisiensi transmisi, di mana cahaya yang datang tegak lurus memberikan hasil transmisi maksimum. Oleh karena itu, dalam sistem simulasi tembakan berbasis laser, pemilihan bahan optik harus mempertimbangkan faktor-faktor ini agar sistem tetap akurat dan efisien.

### 2.2.9 Lensa Fresnel

Lensa Fresnel adalah jenis lensa optik yang dirancang untuk memiliki sifat konvergen seperti lensa cembung biasa, tetapi dengan struktur bertingkat yang memungkinkan pengurangan ketebalan dan berat secara signifikan (Hecht, E., 2017). Lensa ini ditemukan oleh Augustin-Jean Fresnel dan awalnya digunakan dalam mercusuar untuk memfokuskan cahaya sejauh mungkin. Struktur uniknya terdiri dari lingkaran konsentris yang berfungsi sebagai permukaan refraksi individual, sehingga cahaya dapat difokuskan tanpa memerlukan bahan yang tebal.

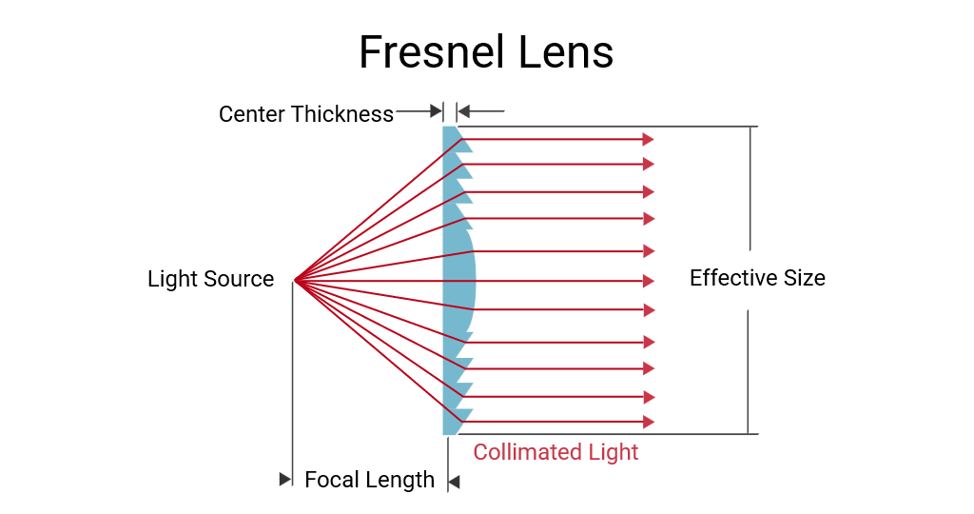
[picture p7: figure]

Gambar 6 Lensa Fresnel

Sumber: Meetoptics (2002)

Secara prinsip, lensa Fresnel bekerja dengan cara membelokkan (refraksi) sinar cahaya yang melewatinya menuju satu titik fokus tertentu. Dibandingkan dengan lensa cembung konvensional, lensa ini lebih efisien dalam hal transmisi cahaya karena mengurangi pembelokan internal dan distorsi. Meskipun demikian, lensa Fresnel cenderung memiliki sedikit distorsi optik di tepi, namun tetap sangat berguna dalam aplikasi yang tidak memerlukan resolusi tinggi seperti proyektor, lampu sorot, atau sensor jarak jauh.

Lensa Fresnel banyak digunakan dalam aplikasi optik yang membutuhkan fokus cahaya kuat namun dengan ukuran yang ringkas. Contoh penggunaannya meliputi lampu mobil, proyektor LCD, dan sistem pendeteksi inframerah. Dalam sistem MILES dan permainan laser tag, lensa Fresnel digunakan dalam SAT untuk memfokuskan pulsa inframerah agar mencapai jarak yang lebih jauh dengan intensitas tetap stabil, meningkatkan akurasi deteksi saat target terkena tembakan.

Untuk menentukan focal length (jarak fokus) lensa Fresnel, kita menggunakan prinsip dasar optik geometri. Lensa Fresnel dirancang untuk memfokuskan atau menyebarkan cahaya dengan cara yang mirip dengan lensa konvensional, tetapi dengan profil yang lebih tipis dan ringan. Berikut adalah rumus dasar yang digunakan untuk menghitung focal length lensa Fresnel:

| f=R/(n-1) | (1.9)

Dimana:

f = Focal Length

R = Radius Kelengkungan Permukaan Lensa

n = Indeks Bias Material Lensa

### 2.2.10 Push Button

Push Button switch, atau saklar tombol tekan, merupakan perangkat dasar namun penting dalam sistem kontrol elektronik. Push Button berfungsi sebagai penghubung atau pemutus aliran arus listrik, dengan sistem kerja "unlock", yang berarti saklar hanya akan mengalirkan arus saat tombol ditekan, dan kembali ke posisi semula (off) saat tombol dilepas. Sistem operasi "on-off" ini mengatur kondisi 1 (on) dan 0 (off), yang menjadi dasar pengoperasian banyak perangkat listrik yang memerlukan pengendalian aliran listrik dengan dua kondisi utama. Hal ini sangat relevan dalam dunia industri dan teknologi, di mana kehadiran Push Button switch sangat krusial untuk mengatur pengoperasian mesin dan peralatan lainnya.

Dalam aplikasi industri dan otomasi, Push Button switch sering digunakan sebagai alat untuk memulai dan menghentikan proses kerja mesin. Meskipun mesin atau sistem kontrol yang lebih canggih mungkin digunakan, sistem Push Button tetap menjadi elemen kunci dalam kontrol manual dan otomatis. Keandalan, kesederhanaan, dan daya tahannya menjadikan Push Button sebagai komponen yang sangat digunakan dalam berbagai aplikasi industri, dari pengoperasian mesin hingga perangkat rumah tangga otomatis. (Munandar et al., 2023)

Dengan peranannya yang begitu fundamental dalam pengoperasian sistem-sistem elektronik dan otomatisasi, Push Button switch menjadi komponen yang tak terhindarkan dalam dunia teknik dan rekayasa sistem kontrol. Sifatnya yang sederhana namun efektif membuatnya sangat sesuai untuk aplikasi yang membutuhkan interaksi langsung antara operator dan perangkat.

### 2.2.11 Global Positioning System (GPS)

Global Positioning System (GPS) adalah teknologi navigasi berbasis satelit yang memungkinkan penentuan lokasi dan waktu secara akurat di seluruh permukaan bumi. GPS bekerja dengan menerima sinyal dari minimal empat satelit dan menghitung posisi melalui proses trilaterasi berdasarkan perbedaan waktu sinyal diterima. Teknologi ini awalnya dikembangkan untuk keperluan militer, namun kini telah digunakan secara luas di berbagai sektor seperti transportasi, pertanian, navigasi darat dan laut, hingga sistem otonom dan Internet Of Things (IoT). Perangkat GPS modern menggunakan teknik pemrosesan sinyal canggih seperti RTK (Real-Time Kinematic) dan DGPS (Differential GPS) untuk meningkatkan akurasi hingga tingkat sentimeter. Meskipun menghadapi tantangan seperti gangguan sinyal dan kondisi atmosfer, integrasi GPS dengan sistem GNSS lain seperti Galileo, GLONASS, dan BeiDou, serta dukungan teknologi seperti 5G, semakin meningkatkan keandalan dan presisi GPS untuk berbagai aplikasi masa kini dan masa depan (Sunil Fulzele & Athawale, 2024).

Prinsip kerja GPS didasarkan pada metode trilaterasi, yaitu teknik penentuan posisi dengan menghitung jarak antara penerima GPS dan setidaknya tiga satelit GPS. Setiap satelit mengorbit bumi dan secara periodik memancarkan sinyal yang berisi informasi mengenai waktu dan posisi satelit tersebut. Perangkat penerima GPS mengukur waktu tempuh sinyal dari masing-masing satelit untuk menghitung jarak secara presisi. Dengan memanfaatkan data dari minimal empat satelit, sistem GPS mampu menentukan posisi tiga dimensi suatu objek, yakni lintang, bujur, dan ketinggian, dengan tingkat akurasi yang tinggi(Prettz et al., 2017). Berikut merupakan gambar dari GPS dapat dilihat pada Gambar 12.

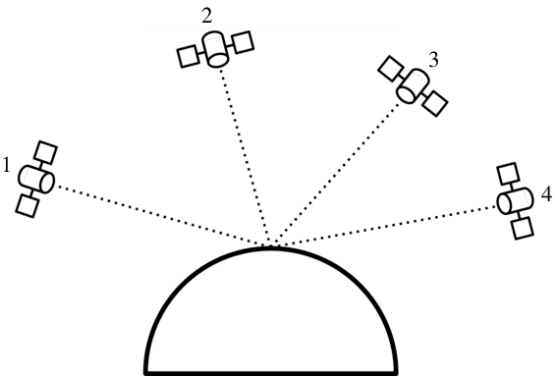
[picture p8: figure]
Satellite constellations | Download Scientific Diagram

Gambar 7 Global Positioning System (GPS)

Sumber : (Prettz et al., 2017)

### 2.2.12 Mikrokontroler

Mikrokontroler adalah Integrated Circuit (IC) yang dirancang untuk mengendalikan fungsi elektronik tertentu dalam suatu sistem. Mikrokontroler memiliki elemen-elemen utama seperti prosesor (CPU), memori (RAM dan ROM/Flash), serta modul Input/Output (I/O) yang terintegrasi dalam satu chip. Salah satu fungsi utama mikrokontroler adalah mengelola komunikasi data antar perangkat yang berbeda. Mikrokontroler umumnya dilengkapi dengan modul komunikasi seperti UART, SPI, I2C, atau protokol nirkabel, yang memungkinkan transfer data dengan perangkat eksternal seperti sensor, aktuator, atau mikrokontroler lain. Mikrokontroler menawarkan efisiensi biaya, keandalan tinggi, dan fleksibilitas untuk aplikasi-aplikasi khusus. Namun, keterbatasannya meliputi kemampuan komputasi yang relatif rendah dan kapasitas memori yang terbatas dibandingkan mikroprosesor.

Pada penelitian ini digunakan dua board mikrokontroler yang masing-masing berdiri sendiri dengan fungsi berbeda, yaitu ESP32 S3 Supermini sebagai node pengirim data melalui protokol ESP-NOW, dan Heltec Wireless Tracker V1.2 sebagai penerima data ESP-NOW sekaligus pengirim data melalui LoRa.

  a. ESP32 S3 Supermini

ESP32 S3 Supermini merupakan board pengembangan IoT yang kompak dan bertenaga, berbasis chip Espressif ESP32-S3 dengan prosesor dual-core Xtensa LX7 yang beroperasi hingga 240 MHz. Board ini mendukung komunikasi nirkabel Wi-Fi 802.11 b/g/n dan Bluetooth 5 (BLE), serta memiliki desain yang sangat ringkas berukuran 22,52 × 18 mm, sehingga mudah ditanamkan ke dalam proyek berdimensi kecil.(Board.dev, 2025)

Dalam sistem ini, ESP32 S3 Supermini difungsikan sebagai node pengirim yang mengumpulkan data dari sensor dan mengirimkannya ke Heltec Wireless Tracker menggunakan protokol ESP-NOW. Fitur yang dimanfaatkan secara spesifik meliputi konektivitas Wi-Fi untuk ESP-NOW, antarmuka I2C/UART untuk komunikasi sensor, serta pin GPIO untuk akuisisi data. Board ini dilengkapi pin komunikasi seperti RX/TX untuk UART, SDA/SCL untuk I2C, serta MISO, MOSI, SCK, dan SS untuk SPI, sehingga memudahkan integrasi dengan berbagai perangkat sensor. Berikut merupakan spesifikasi ESP32 S3 Supermini yang digunakan dapat dilihat pada Gambar 13.

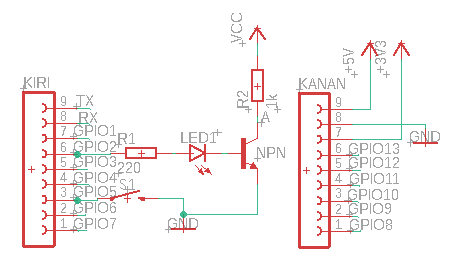
[picture p9: figure]
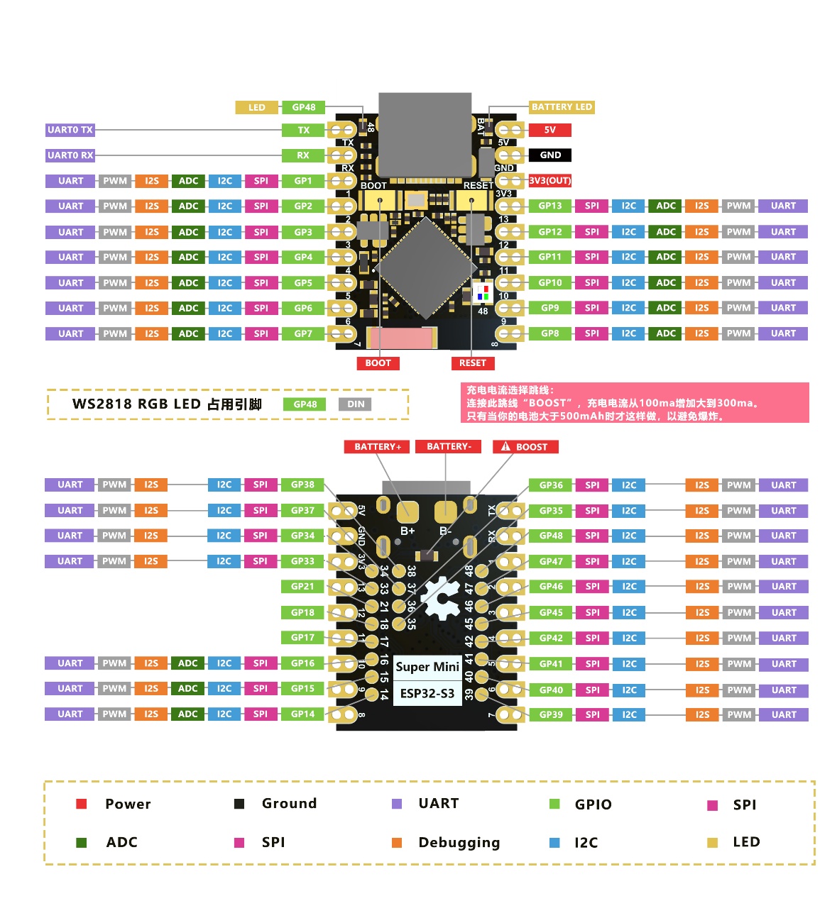
[picture p10: figure]

Gambar 8 ESP32

(Sumber: (Pratama & Kiswantono, 2023)

Berikut merupakan tabel spesifikasi dari ESP32 dapat dilihat pada Tabel 1.

Tabel 1 Spesifikasi ESP32S3 Supermini

Fitur | Spesifikasi
Chip | ESP32 S3 Supermini
Core | Dual-core Xtensa LX7 CPU
Clock Speed | hingga 240 MHz (600 DMIPS)
Wi-Fi | 802.11 b/g/n (2.4 GHz)
Bluetooth | Bluetooth 5 (BLE)
Flash | 4 MB
SRAM | 512 KB internal SRAM + 8 MB PSRAM eksternal (umumnya)
GPIO | ~20+ pin GPIO
ADC | 2x 12-bit SAR ADC (8 channel)
Touch Sensor | hingga 14 channel capacitive touch sensing
PWM | 11 channel
Interface | UART, I²C, SPI, I²S, RMT, TWAI, USB OTG
Power Supply | 5V via USB, regulated to 3.3V

  b. Heltec Wireless Tracker V1.2

Heltec Wireless Tracker V1.1 (dan V1.2) merupakan kit pengembangan berbasis ESP32-S3FN8 yang mengintegrasikan chip LoRa SX1262 dan chip GNSS UC6580 untuk menyediakan solusi pelacakan IoT secara nirkabel. Board ini mendukung komunikasi Wi-Fi, Bluetooth, LoRa, dan GNSS, serta kompatibel dengan platform Arduino, LoRaWAN, maupun Meshtastic. (Automation, 2021; Project Zephyr, 2025)

Dalam sistem ini, Heltec Wireless Tracker V1.2 difungsikan sebagai node penerima data dari ESP32 S3 Supermini melalui protokol ESP-NOW, kemudian meneruskan data tersebut ke gateway atau node berikutnya menggunakan komunikasi LoRa berbasis chip SX1262. Fitur yang dimanfaatkan secara spesifik meliputi ESP-NOW via Wi-Fi 2,4 GHz untuk penerimaan data, modul LoRa SX1262 untuk pengiriman jarak jauh, serta layar LCD 0,96 inci untuk pemantauan status sistem.

Board ini dilengkapi antarmuka USB Type-C dengan proteksi tegangan, ESD, dan hubung singkat yang lengkap, serta antarmuka baterai SH1.25-2 dengan sistem manajemen baterai litium terintegrasi(Project Zephyr, 2025)

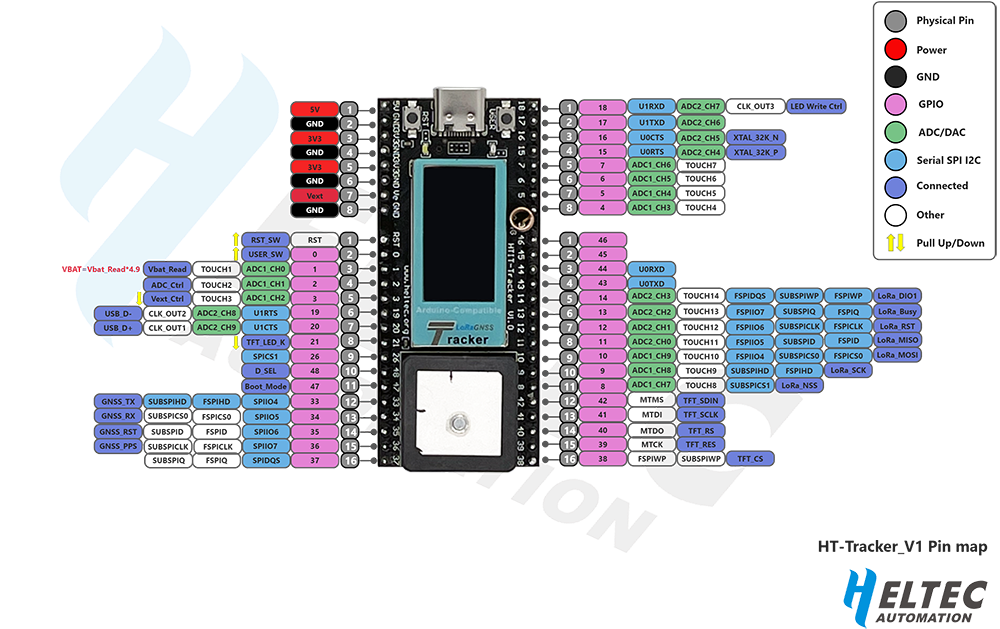
[picture p11: figure]

Gambar 9 Heltec Wireless Tracker V1.2

Sumber: (Automation, 2021)

Tabel 2 Spesifikasi Heltec Wireless Tracker V1.2

Fitur | Spesifikasi
Chip Utama | ESP32-S3FN8
Core | Dual-core Xtensa® 32-bit LX7
Clock Speed | Hingga 240 MHz
Wi-Fi | 802.11 b/g/n (2.4 GHz) / ESP-NOW
Bluetooth | Bluetooth 5 (BLE)
LoRa | Semtech SX1262
GNSS | UC6580 (GPS, GLONASS, BDS, Galileo, NAVIC, QZSS)
Flash | 8 MB
Display | LCD 0,96 inci 160×80 (ST7735)
Interface | UART, I²C, SPI, USB-C
Power Supply | USB-C / Baterai Li-Po (SH1.25-2)

### 2.2.13 Protokol ESP-NOW

ESP-NOW merupakan protokol komunikasi nirkabel berbasis link layer yang dikembangkan oleh Espressif Systems untuk memungkinkan pertukaran data secara langsung antar perangkat yang menggunakan chip ESP seperti ESP32 dan ESP8266. Protokol ini dirancang untuk mendukung komunikasi cepat dengan latensi rendah serta konsumsi daya yang efisien, sehingga sangat cocok digunakan dalam aplikasi Internet Of Things (IoT) dan sistem embedded. ESP-NOW tidak memerlukan koneksi infrastruktur Wi-Fi seperti router atau jaringan internet, melainkan bekerja secara peer-to-peer (P2P) menggunakan frekuensi 2.4 GHz. Dalam pengoperasiannya, ESP-NOW memanfaatkan teknologi Wi-Fi Direct melalui action frames untuk mentransmisikan data tanpa perlu koneksi TCP/IP, sehingga proses pengiriman data dapat dilakukan secara cepat dan sederhana. Komunikasi dapat dilakukan dalam mode unicast maupun broadcast dengan batasan payload maksimal sebesar 250 byte per paket. Selain itu, ESP-NOW juga mendukung enkripsi AES 128-bit untuk menjaga keamanan data selama proses pengiriman. Kelebihan utamanya termasuk kemampuan komunikasi langsung tanpa infrastruktur tambahan, hemat daya, latensi rendah, serta mudah diimplementasikan dalam berbagai proyek IoT seperti smart home automation, sensor jaringan nirkabel, kontrol robot, dan sistem alarm. Meskipun memiliki keterbatasan dalam jumlah node maksimum dan ukuran payload, ESP-NOW tetap menjadi solusi komunikasi nirkabel yang efektif dan efisien bagi pengembangan sistem berbasis mikrokontroler ESP.(Adolfo & Setia Budi, 2023)

ESP-NOW menggunakan frame data Wi-Fi jenis Action Frames, yang memungkinkan pengiriman data dalam bentuk payload berukuran maksimal 250 byte. Komunikasi ini dapat berlangsung antara :

- Perangkat ESP sebagai satu lawan satu (Peer-To-Peer)
- Satu pengirim ke banyak penerima (One-To-Many)
- Beberapa pengirim ke satu penerima (Many-To-One)

### 2.2.14 Receiver Inframerah Anti Cheating

Penelitian ini bertujuan untuk mendokumentasikan eksperimen implementasi fitur Anti-Cheating pada sistem MILES (Multiple Integrated Laser Engagement System), yang dirancang guna mencegah kecurangan berupa penutupan sengaja terhadap sensor inframerah pada rompi peserta latihan. Dalam konfigurasi standar, rompi dilengkapi penerima TSOP4838 untuk mendeteksi sinyal inframerah termodulasi 38 kHz yang dipancarkan oleh SAT (Simulated Ammunition Transmitter) lawan. Namun, praktik umum menunjukkan bahwa peserta sering menutupi sensor tersebut dengan bahan buram (misalnya lakban), sehingga membuat mereka kebal terhadap deteksi tembakan.

Sebagai solusi, dirancang unit sensor tambahan yang terintegrasi dalam satu dome bersama TSOP4838, terdiri atas LED inframerah sebagai sumber cahaya aktif dan photodiode sebagai detektor refleksi lokal. Prinsip kerjanya didasarkan pada hilangnya sinyal pantulan inframerah ketika dome ditutupi kondisi ini menyebabkan output photodiode turun ke logika rendah. Delapan unit sensor (empat di bagian depan dan empat di belakang rompi) dihubungkan ke gerbang logika NOR 8-input IC 74HC4078, sehingga keberadaan setidaknya satu dome yang ditutupi menghasilkan logika tinggi pada keluaran gerbang tersebut. Sinyal ini kemudian dibaca oleh mikrokontroler ESP32 melalui salah satu pin GPIO-nya sebagai indikator kecurangan.

Eksperimen utama difokuskan pada verifikasi bahwa pancaran LED inframerah yang bersifat kontinu dan tidak termodulasi tidak mengganggu kemampuan TSOP4838 dalam mendeteksi dan mendekode sinyal modulasi 38 kHz dari SAT lawan. Desain rangkaian memastikan isolasi spektral dan temporal antara kedua fungsi optoelektronik tersebut, sehingga integritas sistem MILES tetap terjaga sambil menambahkan lapisan keamanan tambahan terhadap manipulasi fisik sensor. Dokumentasi ini mencakup prinsip kerja, arsitektur rangkaian, prosedur pengujian, serta analisis hasil eksperimen secara sistematis untuk keperluan akademik dan implementasi praktis dalam sistem pelatihan militer berbasis MILES.

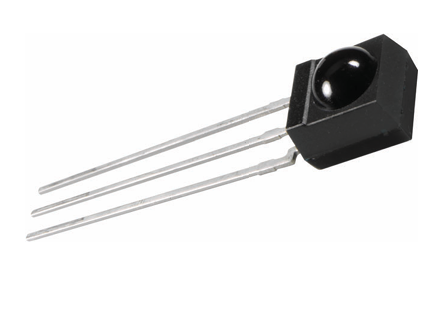
[picture p12: figure]
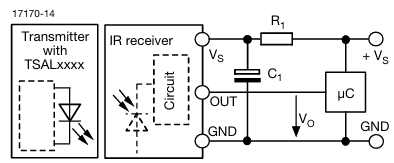
[picture p13: figure]

Gambar 10 TSOP43..

Sumber: (Vishay Semiconductors, 2025)

Berikut merupakan tabel spesifikasi TSOP43.. dapat dilihat pada Tabel 2.

Tabel 3 Spesifikasi TSOP43..

Product Attribute | Attribute Value
Manufacturer | Vishay
Product Category | Inframerah Receivers
RoHS | Details
Mounting Style | Through Hole
Carrier Frequency | 38 kHz
Transmission Distance | 45 m
Beam Angle | 90 deg
Output Current | 5 mA
Operating Supply Voltage | 2.5 V to 5.5 V
Operating Supply Current | 700 uA
Minimum Operating Temperature | -25 °C
Maximum Operating Temperature | +85 °C
Package/Case | Side Looker
Packaging | Tube
Brand | Vishay Semiconductors
Product Type | IR Receivers
Factory Pack Quantity | 2160
Subcategory | Inframerah Data Communications
Unit Weight | 2.338 g

Sensor TSOP4838 memiliki sudut penerimaan efektif ±45° dari sumbu utama (axis). Dengan kata lain, jika remote control diarahkan langsung ke sensor (0°), maka sinyal diterima dengan kuat dan optimal. Jika remote digerakkan hingga membentuk sudut 45° ke kiri atau ke kanan , sensor masih bisa menerima sinyal , meskipun kekuatannya mulai berkurang. Di luar sudut tersebut (>45°), kemungkinan besar sensor tidak akan mendeteksi sinyal .(Toyib et al., 2019).

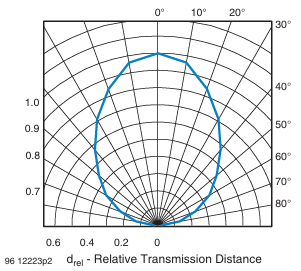
[picture p14: figure]

Gambar 11 Sudut penerimaan sensor TSOP4838

Gambar 34 menunjukkan grafik yang berkaitan dengan sudut penerimaan (directivity) sensor. Sumbu radial (sumbu horizontal) menyatakan relative transmission distance (d_rel), yaitu jarak transmisi relatif . Nilai d_rel = 1.0 pada sumbu ini menunjukkan jarak transmisi maksimum saat sinyal datang langsung ke arah tengah sensor (0°). Semakin kecil nilai d_rel , semakin rendah sensitivitas sensor terhadap sinyal IR dari sudut tertentu. Sumbu sudut (sumbu lingkaran) menyatakan sudut datang sinyal IR terhadap sumbu utama sensor (arah 0°). Sudut dinyatakan dalam derajat (0° hingga ±90°) di sekitar sumbu utama sensor. Garis kurva hitam pada polar plot menunjukkan hubungan antara sudut datang sinyal dan sensitivitas sensor. Pada 0°, garis mencapai nilai maksimum (d_rel = 1.0), yang menunjukkan bahwa sensitivitas sensor paling tinggi ketika sinyal datang langsung ke arah tengah. Semakin menjauh dari 0°, nilai d_rel menurun, menunjukkan bahwa sensitivitas sensor berkurang. Saat sinyal datang tepat di depan sensor (0°), sensitivitasnya mencapai nilai maksimum (d_rel = 1.0). Ini berarti sensor dapat menerima sinyal dengan jarak transmisi maksimal. Dari datasheet, diketahui bahwa sudut penerimaan efektif adalah ±45°. Pada ±45°, nilai d_rel turun menjadi sekitar 0.4–0.5, yang menunjukkan bahwa sensitivitas masih cukup baik tetapi sudah menurun dibandingkan dengan posisi 0°. Di luar sudut ±45°, sensitivitas menurun drastis, sehingga sensor cenderung tidak dapat menerima sinyal dengan akurat, garis kurva menunjukkan bahwa d_rel mendekati nol. Ini berarti sensitivitas sensor sangat rendah atau hampir tidak ada.

TSOP4838 memiliki kemampuan untuk merespons panjang gelombang cahaya tertentu, yang disebut Relative Spectral Sensitivity (RSS). Dalam konteks TSOP4838, ini mengacu pada seberapa sensitif sensor terhadap berbagai panjang gelombang cahaya inframerah (IR), relatif terhadap panjang gelombang optimalnya LED inframerah memancarkan Cahaya dengan Panjang gelombang 930-950 nm. Agar komunikasi berjalan dengan efisien. LED pemancar harus bekerja pada panjang gelombang yang sesuai dengan puncak RSS dari TSOP4838.

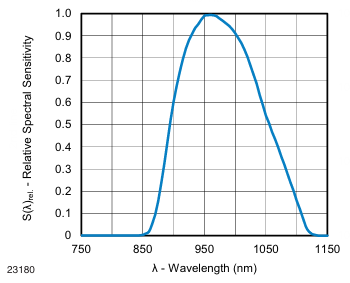
[picture p15: figure]

Gambar 12 Grafik Panjang Gelombang

Grafik ini menunjukkan bagaimana respons sensitivitas sensor TSOP4838 berubah terhadap berbagai Panjang gelombang yang diterima. Jika Panjang gelombang mencapai 950nm maka sensitivitas akan mencapai nilai puncak yang berarti pada titik maksimal kemampuan sensitivitas sensor TSOP4838. Jika Panjang gelombang yang diterima tidak sesuai dengan puncak sensitivitas sensor, maka akan mengurangi sensitivitas sensor penerima bahkan dapat menyebabkan error atau sinyal tidak terbaca

### 2.2.15 LoRaWAN

LoRaWAN (Long Range Wide Area Network) merupakan protokol jaringan komunikasi nirkabel berdaya rendah yang dirancang untuk mendukung aplikasi Internet Of Things (IoT) skala luas. Protokol ini dibangun di atas teknologi modulasi LoRa (Long Range), yang merupakan implementasi fisik dari Chirp Spread Spectrum (CSS) yang memungkinkan transmisi data jarak jauh dengan konsumsi daya yang sangat rendah (Adelantado et al., 2017).

Arsitektur LoRaWAN mengadopsi topologi star-of-stars, di mana end-devices (perangkat akhir) berkomunikasi secara langsung dengan satu atau lebih Gateways. Gateway kemudian meneruskan data ke network server melalui jaringan backhaul (misalnya internet), yang selanjutnya mengarahkan data ke application server yang sesuai. Komunikasi dalam LoRaWAN bersifat asinkron dan menggunakan mekanisme ALOHA untuk akses media, sehingga mengurangi kompleksitas sinkronisasi antar perangkat (Alliance, 2023)

LoRaWAN mendefinisikan tiga kelas perangkat berdasarkan pola komunikasi:

- Kelas A: Komunikasi dua arah dengan jendela penerimaan (receive windows) setelah transmisi dari perangkat. Paling hemat energi.
- Kelas B: Menambahkan beacon-based scheduling untuk penerimaan periodik, menyeimbangkan antara latensi dan efisiensi energi.
- Kelas C: Perangkat selalu dalam keadaan siap menerima, kecuali saat mengirim data—cocok untuk aplikasi berdaya tinggi.

Keamanan dalam LoRaWAN dijamin melalui dua lapis enkripsi: Network Session Key (NwkSKey) dan Application Session Key (AppSKey), serta mekanisme autentikasi berbasis Join Accept selama proses over-the-air activation (OTAA).

Di Indonesia, penggunaan spektrum frekuensi radio untuk perangkat telekomunikasi diatur oleh Kementerian Komunikasi dan Informatika (Kominfo) melalui Peraturan Menteri Kominfo Nomor 21 Tahun 2019 tentang Penggunaan Spektrum Frekuensi Radio untuk Perangkat Telekomunikasi Short Range Device (SRD). Meskipun LoRaWAN secara global menggunakan beberapa pita frekuensi (misalnya EU868, US915, AS923), di Indonesia pita frekuensi yang umum digunakan dan diizinkan untuk SRD termasuk 920–923 MHz, yang secara teknis mengacu pada rencana regional AS923 (Asia 923 MHz).

Pita 920–923 MHz di Indonesia memiliki karakteristik sebagai berikut (Kominfo, 2019):

- Lebar pita: 3 MHz (920–923 MHz)
- Daya pancar maksimum: +14 dBm (25 mW) ERP (Effective Radiated Power)
- Duty cycle: Tidak secara eksplisit dibatasi seperti di Eropa, namun penggunaan harus mematuhi prinsip non-interference dan non-exclusive.
- Modulasi: Diizinkan untuk teknologi spread spectrum, termasuk LoRa.

Perlu dicatat bahwa meskipun pita ini mengacu pada profil AS923, implementasi LoRaWAN di Indonesia sering kali menyesuaikan sub-band yang diizinkan. Misalnya, hanya channel 0–7 (923.2–923.8 MHz) yang umum digunakan karena ketersediaan spektrum dan kebijakan lokal. Beberapa network server (seperti The Things Network/TTN) menyediakan profil khusus “AS923-1” atau “AS923-ID” untuk menyesuaikan dengan regulasi nasional.

Penggunaan frekuensi di luar ketentuan Kominfo dapat dikenai sanksi administratif atau pencabutan izin, sehingga penting bagi pengembang IoT untuk memastikan perangkat LoRaWAN mereka mematuhi batasan daya, frekuensi, dan protokol yang ditetapkan.

### 2.2.16 RadioLib

RadioLib merupakan sebuah open-source library yang dikembangkan untuk memfasilitasi komunikasi nirkabel pada berbagai modul radio, terutama yang digunakan dalam platform mikrokontroler seperti Arduino dan ESP32. Library ini dirancang untuk menyederhanakan proses pengembangan sistem komunikasi jarak jauh dengan menyediakan antarmuka pemrograman yang konsisten dan komprehensif untuk berbagai jenis modul radio, termasuk LoRa, FSK, OOK, dan lainnya (Gromes, 2025). Dengan dukungan terhadap berbagai chip transceiver seperti SX127x, SX126x, RF69, dan CC1101, RadioLib memungkinkan pengembang untuk mengimplementasikan protokol komunikasi nirkabel secara efisien tanpa harus menulis kode tingkat rendah secara manual.

Salah satu keunggulan utama RadioLib adalah abstraksi perangkat keras yang memungkinkan portabilitas kode antar platform. Hal ini sangat penting dalam pengembangan sistem Internet Of Things (IoT), di mana fleksibilitas dan skalabilitas menjadi pertimbangan utama. Menurut dokumentasi resminya, RadioLib menyediakan fungsi-fungsi tingkat tinggi untuk konfigurasi modul, pengiriman dan penerimaan data, serta pengelolaan status perangkat, sehingga mempercepat siklus pengembangan dan pengujian (Gromes, 2025)

Dalam konteks pendidikan dan penelitian, penggunaan library seperti RadioLib memungkinkan mahasiswa dan peneliti untuk fokus pada aspek desain sistem dan protokol komunikasi, bukan pada kompleksitas implementasi perangkat keras. Sebagai contoh, dalam eksperimen berbasis LoRa, RadioLib memungkinkan pengaturan parameter seperti spreading factor, bandwidth, dan coding rate melalui fungsi-fungsi sederhana, sehingga memudahkan ekspLoRasi karakteristik jaringan LoRaWAN (Gromes, 2025).

Perbandingan dengan library lain seperti LoRa.h (yang hanya mendukung modul berbasis SX127x) menunjukkan bahwa RadioLib menawarkan cakupan perangkat yang lebih luas dan konsistensi antarmuka lintas chip. Hal ini menjadikannya pilihan yang lebih fleksibel untuk proyek-proyek yang memerlukan interoperabilitas atau migrasi antar platform perangkat keras (Gromes, 2025).

### 2.2.17 Gateway

Gateway merupakan komponen kritis dalam arsitektur jaringan modern, berfungsi sebagai titik perantara yang menghubungkan dua atau lebih jaringan yang berbeda, baik dalam hal protokol, arsitektur, maupun teknologi fisik. Secara umum, Gateway bertindak sebagai perangkat jaringan yang mampu menerjemahkan komunikasi antar sistem heterogen, sehingga memungkinkan interoperabilitas antara perangkat yang menggunakan standar berbeda (Tanenbaum & Wetherall, 2021).

Dalam konteks jaringan berbasis Internet Of Things (IoT), Gateway sering kali menjadi penghubung antara perangkat edge (seperti sensor atau aktuator) dengan infrastruktur cloud atau jaringan inti. Perangkat ini tidak hanya meneruskan data, tetapi juga dapat melakukan pra-pemrosesan, agregasi, enkripsi, dan manajemen protokol. Misalnya, dalam arsitektur LoRaWAN salah satu teknologi LPWAN (Low Power Wide Area Network) Gateway berfungsi menerima sinyal radio dari node end-device menggunakan modulasi LoRa, lalu meneruskannya ke server jaringan melalui koneksi backhaul berbasis IP seperti Ethernet, Wi-Fi, atau seluler. (Adelantado et al., 2017)

Fungsi utama Gateway mencakup konversi protokol (protocol conversion), routing, dan keamanan jaringan. Berbeda dengan router atau switch yang beroperasi pada lapisan jaringan atau lapisan data link dalam model OSI, Gateway umumnya beroperasi pada lapisan aplikasi (lapisan 7), sehingga mampu memahami dan memproses konten pesan secara semantik (Forouzan, 2013). Hal ini menjadikan Gateway lebih kompleks dibanding perangkat jaringan lainnya, namun juga lebih fleksibel dalam mengintegrasikan sistem yang beraga.

Dalam implementasi dasar (basic Gateway), fungsionalitas biasanya dibatasi pada penerusan data tanpa pemrosesan lanjutan. Contohnya adalah Gateway LoRaWAN sederhana yang hanya menerima frame LoRa dan meneruskannya ke The Things Network (TTN) atau server LoRaWAN lain melalui protokol UDP. Meskipun demikian, bahkan Gateway dasar tetap memerlukan konfigurasi jaringan yang tepat, sinkronisasi waktu, serta manajemen keamanan minimal untuk mencegah serangan seperti spoofing atau denial-of-service (Augustin et al., 2016).

### 2.2.18 The Things Network (TTN) Integration

Sistem komunikasi berbasis LoRaWAN (Long Range Wide Area Network) telah menjadi pilihan utama dalam pengembangan solusi Internet Of Things (IoT) berdaya rendah dan jangkauan jauh. Dalam implementasi ini, perangkat end-node berbasis Heltec Tracker V1.2 yang menggunakan modul radio SX1262 dikonfigurasi untuk berkomunikasi dengan infrastruktur jaringan LoRaWAN melalui The Things Network (TTN), sebuah platform jaringan LoRaWAN berbasis cloud yang bersifat terbuka dan komunitas-driven (The Things Industries, 2025).

Komunikasi antara perangkat dan jaringan diimplementasikan menggunakan pustaka RadioLib, yaitu pustaka universal untuk komunikasi nirkabel pada perangkat embedded seperti Arduino. RadioLib menyediakan dukungan penuh terhadap protokol LoRaWAN, termasuk mekanisme aktivasi Over-The-Air Activation (OTAA), manajemen sesi, enkripsi end-to-end, serta penanganan uplink dan downlink sesuai spesifikasi LoRaWAN 1.0.3 (Gromes, 2025a). OTAA dipilih karena menawarkan keamanan yang lebih tinggi dibandingkan metode ABP (Activation by Personalization), dengan proses autentikasi dinamis yang melibatkan pertukaran kunci jaringan (NwkKey) dan kunci aplikasi (AppKey) selama fase join.

Konfigurasi perangkat mencakup definisi pin SPI dan kontrol khusus untuk modul SX1262, seperti chip select (CS), reset (RST), busy (BUSY), dan digital input/output (DIO1). Parameter wilayah frekuensi disetel ke AS923, yang merupakan alokasi spektrum LoRaWAN yang berlaku di wilayah Asia Tenggara, termasuk Indonesia.Hal ini penting untuk memastikan kepatuhan terhadap regulasi spektrum nasional dan kompatibilitas dengan Gateway yang tersedia di wilayah tersebut. Pada sisi keamanan, perangkat dikonfigurasi dengan tiga parameter kriptografi utama:

- DevEUI (Device Extended Unique Identifier): identitas unik 64-bit perangkat,
- AppKey: kunci 128-bit untuk enkripsi lapisan aplikasi,
- NwkKey: kunci 128-bit untuk enkripsi lapisan jaringan.

Pada The Things Stack versi 3 (TTN v3), nilai NwkKey secara fungsional identik dengan AppKey, sehingga kedua parameter tersebut menggunakan nilai yang sama yang dihasilkan dari antarmuka TTN Console (The Things Industries, 2025). Setelah proses join berhasil—ditandai dengan kode status RADIOLIB_LORAWAN_NEW_SESSION (nilai -1118) perangkat memasuki sesi aktif dan siap mengirim data.

Dalam siklus operasi, perangkat mengirim payload berukuran 3 byte setiap 10 detik. Payload terdiri dari:

- 1 byte untuk nilai sensor simulasi pertama (value1),
- 2 byte (MSB dan LSB) untuk nilai sensor simulasi kedua (value2).

Data dikirim melalui metode sendReceive(), yang secara otomatis membuka jendela penerimaan (RX1 dan RX2) untuk memungkinkan penerimaan downlink dari server jaringan. Setiap transmisi diverifikasi melalui kode status RadioLib; misalnya, RADIOLIB_ERR_NO_JOIN_ACCEPT (-1116) menunjukkan kegagalan menerima respons JoinAccept dari jaringan, yang umumnya disebabkan oleh ketidaksesuaian kunci atau jangkauan sinyal yang tidak memadai (Gromes et al., 2025)

Verifikasi keberhasilan transmisi dilakukan melalui antarmuka TTN Console. Data yang diterima ditampilkan dalam format JSON dengan frame payload berupa string Base64. Sebagai contoh, payload "BgcV" didekode menjadi urutan heksadesimal 06 07 15, yang merepresentasikan nilai numerik 6 dan 1813—sesuai dengan logika pengkodean di sisi perangkat. Hal ini menunjukkan bahwa enkapsulasi data, enkripsi, transmisi, dan dekripsi di sisi server berjalan sesuai spesifikasi LoRaWAN.

Pustaka RadioLib juga menyediakan mekanisme diagnosis kesalahan yang komprehensif melalui serangkaian kode status terstandarisasi. Misalnya, RADIOLIB_ERR_CHIP_NOT_FOUND (-2) mengindikasikan kesalahan pada koneksi perangkat keras, sedangkan RADIOLIB_ERR_MIC_MISMATCH (-1112) menandakan ketidaksesuaian Message Integrity Code (MIC), yang dapat disebabkan oleh ketidaksesuaian kunci atau frame counter yang tidak sinkron(Gromes et al., 2025). Fungsi bantu seperti stateDecode() digunakan untuk memetakan kode numerik menjadi pesan deskriptif, mempermudah proses debugging selama pengembangan.

Secara keseluruhan, implementasi ini menunjukkan integrasi yang robust antara perangkat end-node berbasis SX1262, pustaka RadioLib, dan infrastruktur The Things Network. Arsitektur ini tidak hanya memenuhi prinsip keamanan dan efisiensi daya LoRaWAN, tetapi juga memberikan fondasi yang dapat dikembangkan lebih lanjut untuk aplikasi IoT riil, seperti pemantauan lingkungan, pelacakan aset, atau sistem pertanian presisi.

### 2.2.19 Photodioda

Photodioda merupakan salah satu komponen semikonduktor yang berfungsi sebagai sensor cahaya dengan prinsip kerja mengubah energi cahaya menjadi arus listrik. Komponen ini bekerja berdasarkan efek fotolistrik pada sambungan p-n junction, di mana cahaya yang mengenai permukaan semikonduktor akan menghasilkan pasangan elektron dan hole sehingga menimbulkan arus listrik pada rangkaian. Besarnya arus yang dihasilkan sebanding dengan intensitas cahaya yang diterima oleh photodioda. Oleh karena itu, photodioda banyak digunakan pada sistem deteksi cahaya, komunikasi optik, sensor inframerah, serta sistem otomatisasi berbasis mikrokontroler.

Pada kondisi umum, photodioda dioperasikan dalam mode reverse bias untuk meningkatkan sensitivitas dan mempercepat respon terhadap cahaya. Ketika tidak ada cahaya yang diterima, arus balik (dark current) yang mengalir sangat kecil. Namun saat cahaya mengenai permukaan photodioda, energi foton akan membangkitkan pembawa muatan sehingga arus balik meningkat sesuai intensitas cahaya. Hubungan antara arus photodioda dan intensitas cahaya dapat dinyatakan dengan persamaan:

I_(ph) =R×P

dengan:

- I_(ph) = arus photodioda (A)
- R = responsivitas photodioda (A/W)
- P = daya cahaya yang diterima (W)

### 2.2.20 Modul Kartu SD

Modul kartu SD memungkinkan mikrokontroler untuk menyimpan dan membaca data dalam format file sistem (biasanya FAT16/FAT32). Modul ini berkomunikasi melalui protokol SPI (Serial Peripheral Interface), yang ringan dan didukung luas oleh platform mikrokontroler modern.(Satheesh et al., 2016)

Karakteristik Teknis (berdasarkan spesifikasi SD Card & Modul Adapter)

- Tegangan Operasi: 3.3 V (kartu SD asli); modul adapter biasanya memiliki regulator onboard untuk input 5V
- Protokol Komunikasi: SPI mode (default untuk mikrokontroler)
- Kecepatan Transfer: Tergantung kelas kartu (Class 4, 6, 10, UHS-I)
- Kapasitas: Mendukung hingga 32 GB (SDHC) secara native; SDXC (>32 GB) memerlukan Driver tambahan

Modul ini terdiri dari:

- Slot fisik untuk kartu microSD
- Regulator tegangan (misal: AMS1117-3.3)
- Level shifter (opsional, untuk kompatibilitas 5V logic)

Pertimbangan Desain

- Gunakan pull-up resistor pada CS (Chip Select) untuk stabilitas
- Pastikan clock SPI ≤ 20 MHz (direkomendasikan ≤ 10 MHz untuk keandalan)
- Format kartu menggunakan FAT32 agar kompatibel dengan pustaka seperti SD.h (Arduino) atau sdmmc (ESP-IDF)

# BAB III METODOLOGI

## 3.1 Kerangka Konsep Proyek Akhir

Proyek akhir ini dilakukan melalui beberapa tahap. Tahap pertama adalah studi literatur, dimana peneliti mengumpulkan dan menganalisis teori-teori yang berkaitan dengan topik proyek akhir dari buku, jurnal, artikel, dan proyek akhir sebelumnya. Selanjutnya, konsep alat dirancang dan spesifikasinya ditentukan. Tahap ketiga adalah perancangan rangkaian elektronik. Kemudian, desain mekanik sebagai casing alat dibuat. Setelah itu, rangkaian elektronik dirakit ke dalam mekanik dan dilakukan pengujian fungsionalitas. Tahap keenam, program untuk keseluruhan sistem dikembangkan dan diuji coba. Selanjutnya, pengambilan data dilakukan dan dilakukan analisa untuk menghasilkan kesimpulan dari alat yang telah dibuat. Terakhir, laporan akhir disusun berdasarkan hasil dari proyek akhir ini.

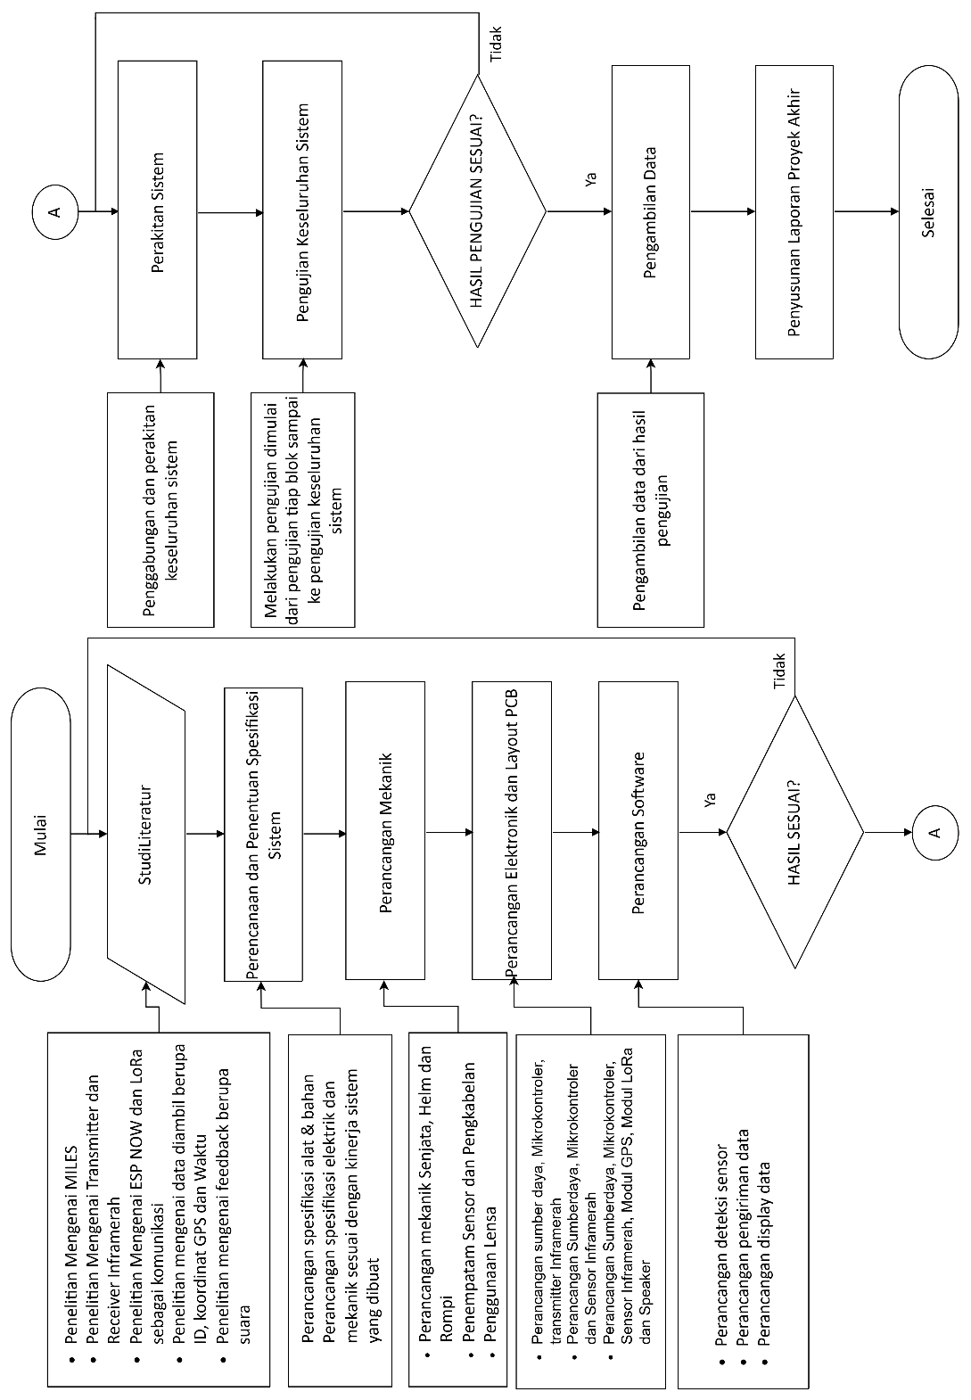
[picture p16: figure]

Gambar 13 Kerangka Konsep penyusunan proyek akhir

Berikut merupakan flowchart dari kerangka konsep perancangan alat dapat dilihat pada Gambar 12.

Adapun Deskripsi Alur Perancangan Alat sebagai berikut

a. Mulai, mempersiapkan segala kebutuhan proyek akhir
b. Studi Literatur, Studi proyek akhir mengenai MILES sebagai sistem permainan berbasis sinyal Inframerah, studi proyek akhir mengenai Transmitter dan receiver Inframerah, Studi Proyek akhir mengenai komunikasi nirkabel menggunakan ESP-NOW dan LoRa, studi proyek akhir mengenai jenis data yang dikirim, seperti ID, koordinat GPS, dan waktu serta studi proyek akhir mengenai feedback suara yang diberikan kepada pengguna.
c. Perencanaan dan Penentuan Spesifikasi Sistem, merumuskan spesifikasi alat secara rinci meliputi aspek elektrik dan mekanik, disesuaikan dengan kinerja sistem yang diinginkan.
d. Perancangan Mekanik, mendesain fisik senjata, helm, dan rompi. Termasuk menentukan penempatan sensor, jalur pengkabelan, dan penggunaan lensa untuk optimasi penerimaan sinyal.
e. Perancangan Elektronik dan Layout PCB, membuat desain skema rangkaian dan tata letak PCB yang mencakup sumber daya, mikrokontroler, dan Transmitter Inframerah pada bagian senjata, Sumber daya, mikrokontroler, dan sensor Inframerah pada bagian helm, sumber daya, mikrokontroler, sensor Inframerah, modul GPS dan modul LoRa pada bagian rompi
f. Perancangan Software, mengembangkan logika sistem meliputi perancangan implementasi logika sistem pada mikrokontroler untuk deteksi sensor dan mengendalikan output, pengiriman data serta menampilkan data pada web interface.
g. Pengujian Awal Komponen, Setelah perancangan selesai, dilakukan pengujian awal pada setiap komponen utama secara terpisah. Hal ini bertujuan untuk memastikan setiap subsistem, seperti sensor, aktuator, dan Driver, berfungsi dengan baik sebelum diintegrasikan.
h. Perakitan Sistem, jika pengujian awal berhasil, semua komponen yang telah dirancang dan diuji dirakit menjadi sebuah prototipe fisik..
i. Pengujian Sistem Keseluruhan, apakah alat berjalan baik tanpa kendala? jika ada kendala dilakukan perbaikan, kalibrasi dan pengecekan hingga bekerja normal. Setelah pengujian alat, akan mendapatkan hasil yaitu alat berjalan baik atau tidak..
j. Pengambilan Data, dari hasil pengujian yang dilakukan diambil data mengenai performa system secara keseluruhan.
k. Penyusunan laporan akhir, melakukan pengujian dan mencatat hasil serta analisa alat yang sudah selesai dalam bentuk laporan.
l. Selesai.

Secara konsep, kerangka yang ditampilkan pada Gambar 12 menggambarkan tahapan pengembangan sistem secara terstruktur dari awal hingga akhir. Jika semua tahapan berhasil, maka Implementasi Rangkaian Elektronik Dan Sistem Komunikasi Multi-Pemain Untuk Permainan Laser Tag Menggunakan ESP-NOW dan LoRa dinyatakan siap digunakan. Konsep ini bersifat iteratif, artinya setiap hasil pengujian yang tidak sesuai akan dikembalikan ke tahap sebelumnya untuk diperbaiki.

## 3.2 Spesifikasi Sistem

Penentuan spesifikasi sistem dilakukan sebagai dasar dalam proses pengimplementasian permainan laser tag. Spesifikasi ini disusun berdasarkan kebutuhan fungsional sistem, komponen yang digunakan, serta tujuan utama dari proyek akhir, yaitu mendeteksi tembakan Inframerah dan mencatat skor secara real-time melalui sensor IR yang kemudian datanya dikirim ke server menggunakan komunikasi ESP-NOW dan LoRa untuk ditampilkan pada Web Interface atau GUI monitoring.

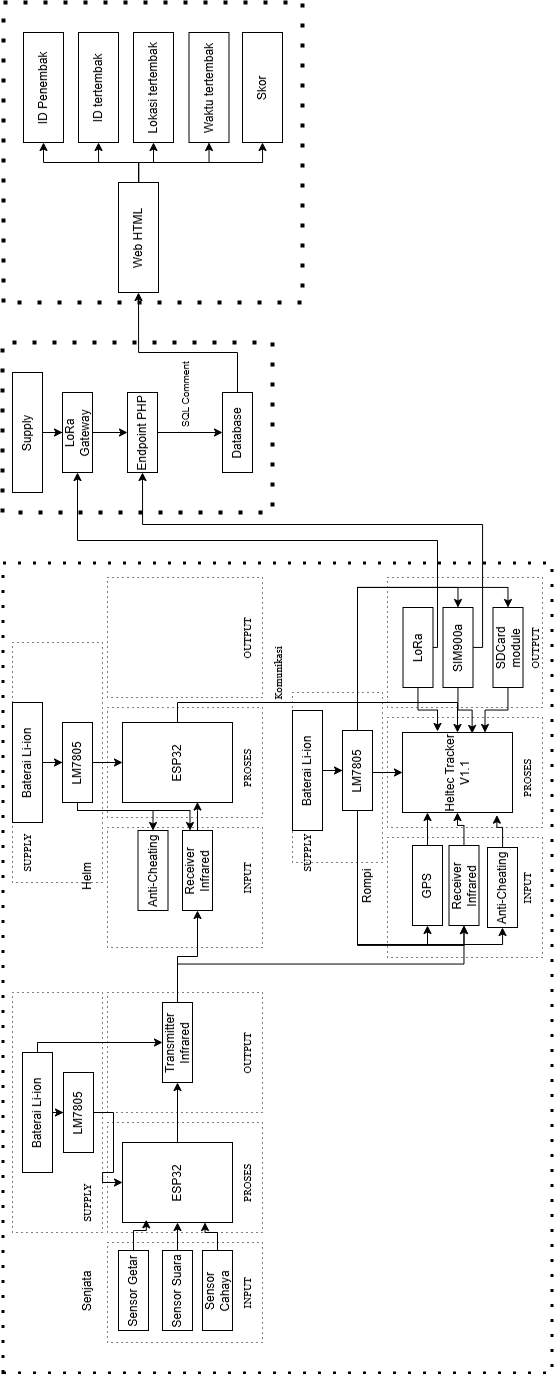
[picture p17: figure]

Gambar 14 Perancangan Sistem

Prinsip kerja sistem laser tag berdasarkan gambar diatas Sistem laser tag IoT diawali ketika seluruh unit perangkat keras yaitu SAT, Helm, dan Rompi dinyalakan dan siap beroperasi. Ketika pemain menekan Push Button utama pada unit SAT, mikrokontroler ESP32-S3 SuperMini akan memeriksa apakah ketiga sensor aktivasi yaitu sensor suara, sensor getar, dan sensor api terpenuhi secara bersamaan sebagai syarat wajib sebelum tembakan dilepaskan. Apabila seluruh sensor aktif, SAT memancarkan sinyal Inframerah berprotokol NEC yang membawa data ID penembak melalui LED yang difokuskan lensa Fresnel ke arah lawan. Sinyal tersebut dapat diterima oleh Helm maupun Rompi. Jika Helm yang terkena, ESP32-S3 SuperMini pada Helm melakukan validasi protokol NEC sekaligus pemeriksaan Anti-Cheating melalui photodiode, dan apabila valid, data HIT diteruskan ke Rompi menggunakan komunikasi nirkabel ESP-NOW. Jika Rompi yang menerima sinyal secara langsung, data langsung diolah oleh mikrokontroler Heltec Wireless Tracker V1.2 yang menggabungkan informasi ID penembak, lokasi sensor, waktu tembakan, dan koordinat GPS dari modul GPS internal.

Setelah Heltec selesai memproses data, sistem secara paralel langsung menyimpan seluruh data ke kartu SD sebagai backup lokal permanen, kemudian mencoba mengirimkan data melalui jalur komunikasi berdasarkan prioritas. Jalur utama adalah GSM menggunakan modul SIM900A yang mengirimkan data ke platform ThingSpeak, kemudian ThingSpeak meneruskannya ke The Things Network (TTN). Apabila jaringan GSM tidak tersedia, sistem beralih ke jalur cadangan menggunakan LoRaWAN yang mengirimkan data langsung ke TTN. Setelah data berhasil diterima TTN dari jalur manapun, TTN meneruskan payload melalui webhook ke platform Vercel yang berperan sebagai backend sekaligus frontend hosting. Vercel memproses data tersebut dan menyimpannya ke database PostgreSQL melalui layanan NeonDB, lalu mendorong pembaruan secara real-time ke antarmuka dashboard menggunakan teknologi Server-Sent Events (SSE) sehingga status pemain, skor, riwayat tembakan, dan posisi pemain dapat dipantau langsung tanpa perlu refresh halaman hingga pertandingan dinyatakan selesai

## 3.3 Perancangan Mekanik

### 3.3.1 Perancangan pada SAT

Spesifikasi SAT

Parameter | Spesifikasi
Model | AR-15 / M4 Style Platform
Panjang Total | 54 cm (Konfigurasi Compact / CQB)
Lebar Body | 9 cm
Tinggi | 16.5 cm (Tanpa aksesoris optik atas)

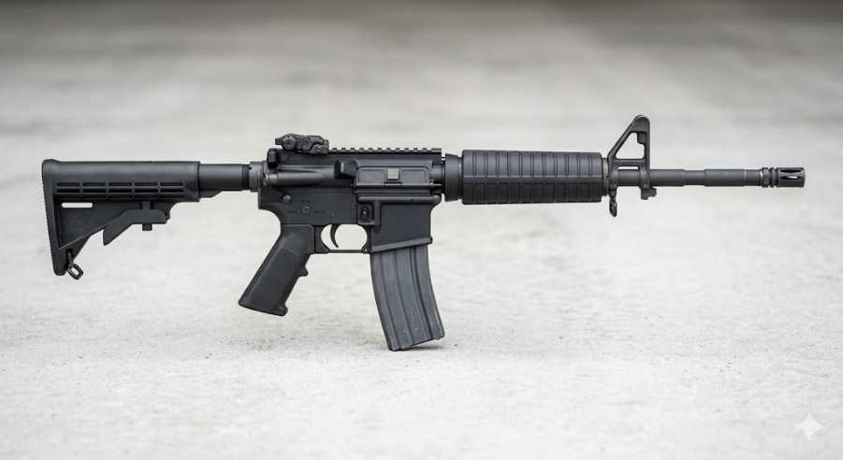
[picture p18: figure]
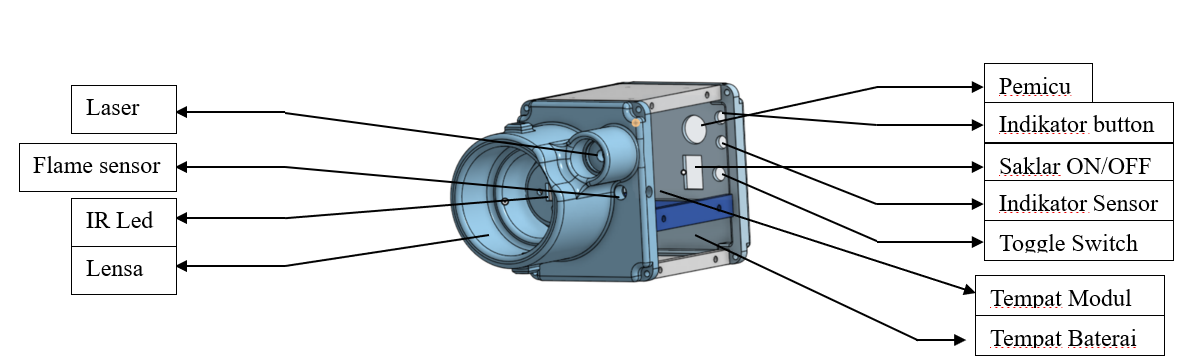
[picture p19: figure]

Gambar 15 Perancangan SAT

### 3.3.2 Perancangan pada helm

3.3.3 Spesifikasi helm

Parameter | Spesifikasi
Panjang | 105 mm
Lebar | 85,5 mm
Tinggi | 31,45 mm
Berat | 150 gr

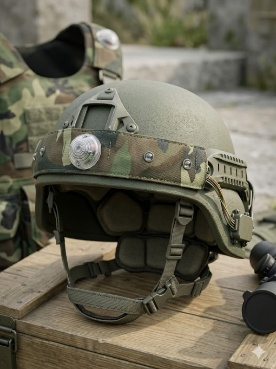
[picture p20: figure]
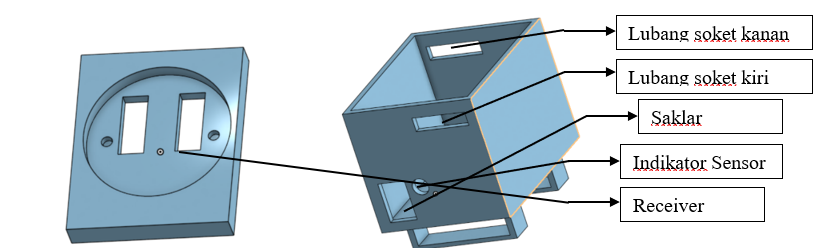
[picture p21: figure]

Gambar 16 Perancangan Helm

### 3.3.4 Perancangan pada rompi

Spesifikasi Rompi

Parameter | Spesifikasi
Panjang | 140 mm
Lebar | 120 mm
Tinggi | 30mm
Berat | 300gr

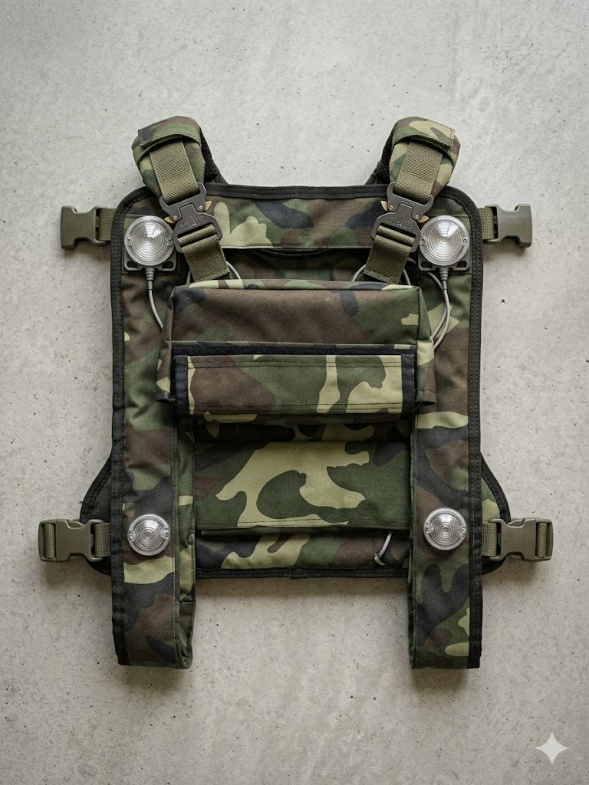
[picture p22: figure]

Box

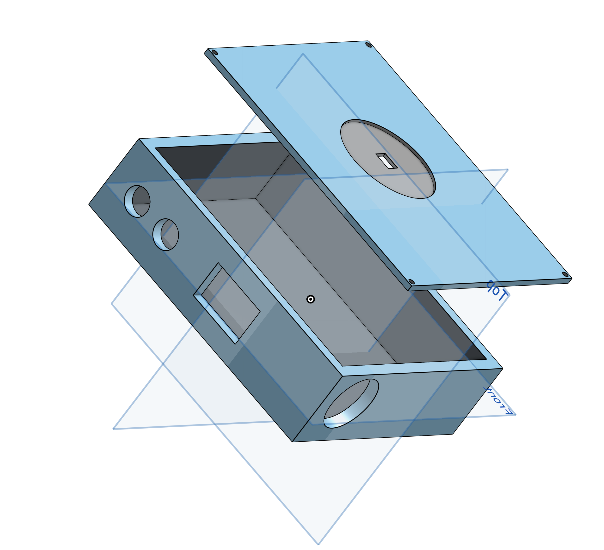
[picture p23: figure]

Gambar 17 Perancangan Box pada Rompi

Desain alat mencakup pengembangan desain fisik dari alat ini, mulai dari konsep struktur hingga detail implementasi. Sistem ini didesain agar semua komponen dalam masuk dan sesuai dengan seluruh kebutuhan sistem yang dibuat untuk rompi dan helm. Dimensi dibuat secompact mungkin agar memaksimalkan dimensi dan ruangan yang dibutuhkan dan tidak mengganggu pergerakan pada saat permainan.

Design Rompi

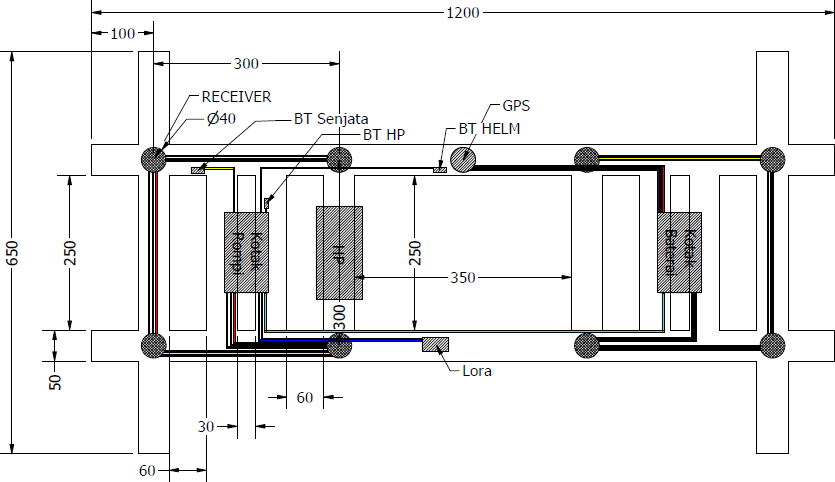
[picture p24: figure]

Gambar 18 Design Rompi

Pada merupakan desain mekanik pada sistem rompi dimana menggunakan bahan kain yang dijahit dengan model dan ukuran kurang lebih seperti pada gambar. Terdapat 8 buah jumlah lubang yang terdapat pada rompi tersebut digunakan sebagai tempat atau wadah dari sensor penerima inframerah TSOP4838. Pada lubang tersebut sensor ditutup menggunakan lensa cembung yang berfungsi untuk memfokuskan Cahaya atau sinyal yang diterima. Keberadaan lensa tersebut cukup penting mengingat kemampuan sensor menerima hanya berkisar kurang lebih 45⁰.

## 3.4 Perancangan Elektronik

### 3.4.1 Perancangan Rangkaian Power Source Regulator Circuit

Perancangan rangkaian regulator sumber daya yang menggunakan baterai lithium-ion Black Cell tipe 14500 dalam konfigurasi dua sel seri (2S). Susunan seri ini menghasilkan tegangan nominal 7,4 V (2 × 3,7V per sel), dengan rentang operasional antara 6 V hingga 8,2 V. Baterai berkapasitas 5.000 mAh ini mampu menyediakan arus hingga 15 A, memadai untuk kebutuhan sistem. Tegangan keluaran baterai diatur menjadi 5 V stabil menggunakan IC regulator 7805, yang dikombinasikan dengan transistor MJD2122G sebagai penguat arus untuk meningkatkan kemampuan arus keluaran regulator. Rangkaian ini juga dilengkapi dioda D10–D11 dan kapasitor C1–C4 untuk menyaring noise serta memperkuat stabilitas respons transient terhadap perubahan beban.

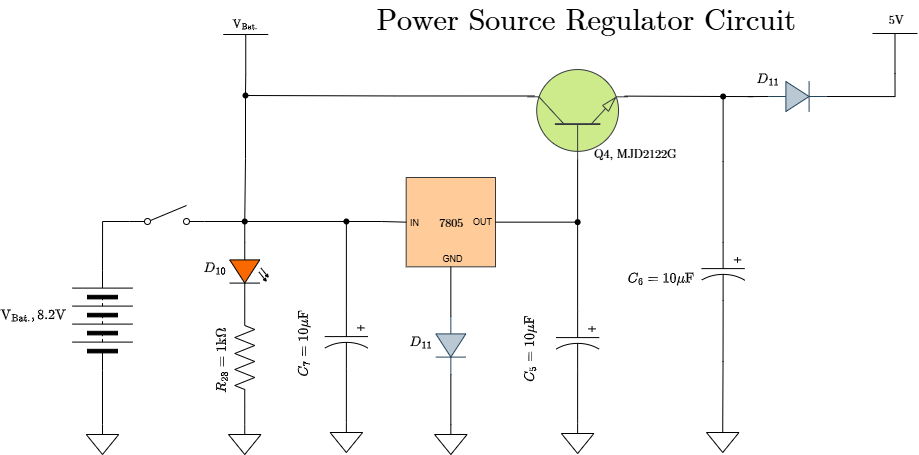
[picture p25: figure]

Gambar 19 Power Source Regulator

Sistem power regulator ini menyuplai tegangan 5V untuk seluruh komponen elektronik SAT dan HARNESS, termasuk ESP32 S3 Supermini, berbagai sensor, IC, LED Inframerah, serta transistor/MOSFET.

Berdasarkan perhitungan asumsi arus pada SAT(Senjata) Sebagai berikut::

Tabel 4 Asumsi pemakain arus pada SAT

Komponen | Referensi/Datasheet | Mode Diam | Mode Active
ESP32S3 Supermini | ESP-NOW RX listen | 80mA | 170mA (TX Burst)
4 xTSOP4838 IR receiver | IS = 0.35mA/unit (datasheet) | 1.4mA | 1.4mA
4x Photodiode | Reverse biased, pasif | 0.04mA | 0.04mA
LM393 Comparator | ICC = 0.4mA (datasheet) | 0.4mA | 0.4mA
Total | | 87mA. ~24 jam | 177mA ~7–8 jam

Berdasarkan perhitungan asumsi arus pada HARNESS(Helm) Sebagai berikut::

Tabel 5 Asumsi arus pada Helm

Komponen | Referensi/Datasheet | Mode Diam | Mode Active
ESP32S3 Supermini | ESP-NOW RX listen | 80mA | 170mA (TX Burst)
4 xTSOP4838 IR receiver | IS = 0.35mA/unit (datasheet) | 1.4mA | 1.4mA
4x Photodiode | Reverse biased, pasif | 0.04mA | 0.04mA
LM393 Comparator | ICC = 0.4mA (datasheet) | 0.4mA | 0.4mA
Total | | 87mA 18 jam | 177mA 9 jam

Berdasarkan perhitungan asusmsi arus pada rompi sebagai berikut:

Tabel 6 Asumsui arus pada rompi

Komponen | Referensi/Datasheet | Mode Diam | Mode Active
Heltec Wireless Tracker V1.2 (MCU Utama) | ESP32-S3 Datasheet §4.6 Espressif Systems, Rev 1.4 | 7 µA (Deep sleep, RTC off) | 240 mA (WiFi TX burst peak)
ESP-NOW (Protokol WiFi) | ESP32-S3 Datasheet §4.6 WiFi 802.11b/g/n | 80 mA (Modem-sleep, RX listen) | 170 mA (TX burst)
LoRa SX1262 (onboard) | SX1262 Datasheet §4.1 Semtech, Rev 2.1 | 0.9 µA (Sleep mode) | 118 mA (TX +22 dBm, maks)
GPS UC6580 (onboard) | UC6580 Datasheet §5.2 Unicore Communications | 10 µA (Backup / standby) | 25 mA (Acquisition mode)
OLED SSD1306 (onboard 0.96") | SSD1306 Datasheet §8.5 Solomon Systech, 128×64 | 10 µA (Display off / sleep) | 15 mA (Normal display on)
IR Receiver TSOP4838 ×4 | TSOP483x Datasheet §4 Vishay Semiconductors | 20 mA (Idle, selalu aktif: 4×5 mA) | 20 mA (Sinyal IR masuk: 4×5 mA)
Photodiode ×4 (Anti-cheat) | BPW34 Generic Datasheet Transistor comparator circuit | 0.5 mA (Bias rendah, 4 unit) | 2 mA (4× comparator aktif)
SD Card Module (SPI, 3.3V) | SD Specification Part 1 §6.6 SD Association, v7.10 | 0.5 mA (Idle / standby) | 150 mA (Write aktif)
Total | | ~108 mA @ 3.3V (~75 mA dari baterai 7.4V). Runtime: idle ≈ 5.6 jam | ~550 mA @ 3.3V (~375 mA dari baterai 7.4V). Runtime: aktif ≈ 2.1 jam

Berdasarkan pengukuran tegangan keluaran V_(out) ≈5,2V , nilai tersebut masih dalam toleransi regulator 7805, yaitu:

V_(out) =5V×(1±0,05)=4,75V hingga 5,25V | (2.0)

Jika transistor Q4 tidak aktif (beban ringan), keluaran berasal langsung dari pin output 7805, sehingga:

V_(out) ≈V_7805

Dalam konfigurasi emitter follower (jika aktif):

V_(out) =V_7805 -VBE≈5V-0,7V=4,3V | (2.1)

Namun karena V_(out) =5,2V , maka Q4 kemungkinan tidak beroperasi sebagai emitter follower pada kondisi pengukuran. Arus keluaran dihitung berdasarkan hukum Ohm:

I_(out) =(V_(out))/(R_(beban)) | (2.2)

Arus basis yang diperlukan untuk mengaktifkan Q4 (jika digunakan sebagai penguat arus):

I_B =(I_(out))/(h_(FE))= | (2.3)

Dengan h_(FE) sebagai penguatan arus DC transistor. Daya disipasi pada Q4:

P_Q =(V_(in) -V_(out) )⋅I_(out) | (2.4)

Selama arus beban kecil dan Q4 tidak jenuh, keluaran tetap mengikuti tegangan regulator 7805 tanpa penurunan V_(BE) .

### 3.4.2 Perancangan Rangkaian Pemancar Inframerah

#### a. Rangkaian Driver SAT

Pada Gambar 30 merupakan rangkaian Driver untuk sistem SAT, dimana rangkaian tersebut bertujuan untuk memaksimalkan keluaran daya namun tetap menjaga kompabilitas dengan sistem embedded berdaya rendah seperti ESP32. Selain itu rangkaian pada Gambar 28 bertujuan untuk mempercepat switching, mempercepat waktu naik dan turun sehingga membantu pembentukan gelombwang pulsa agar sempurna. Terdapat beberapa rangkaian penyusun pada Driver Inframerah, diantaranya:

Kebuthuan sisntem untuk mengaliri arus IR LED current3.5 – 4A (pulsed), Protokol modulasiNEC 38kHz, Duty cycle carrier33% (8.77µs ON / 17.5µs OFF), Durasi 1 frame NEC67.5ms, Jangkauan IR targetTSOP4838 receiver. Sumber daya yang digunakan V_bat (IR LED path)7.4V direct, V_CC (control path)5V regulated, V_GPIO3.3V, Baterai2S Li-ion 7.4V, I_max bateraihingga 15A.

1. JH-7070IR18S40-T8A-LS940

IR LED JH-7070 merupakan high power LED inframerah dengan 18 emitter die dalam satu package 7×7mm yang dirancang untuk aplikasi jarak jauh. Berdasarkan spesifikasi pabrikan, LED ini membutuhkan arus forward sebesar 3,5–4A, sehingga digunakan nilai tengah I_F =3,75 A sebagai acuan perhitungan. Karena sistem menggunakan protokol NEC pada frekuensi carrier 38kHz arus rata-rata yang mengalir ke LED adalah:

I_((avg)) =I_F ×D=3,75×0,33=1,25 A

Tegangan forward LED ( V_F ) tidak dapat diukur langsung dari datasheet karena bergantung pada konfigurasi internal die, sehingga dihitung menggunakan Hukum Kirchhoff Tegangan (KVL) setelah seluruh komponen seri diketahui:

V_F =V_((bat)) -V_R =7,4-0,469-0,083=6,848V

Nilai ini konsisten dengan konfigurasi multi-die seri (6 die seri × 3 paralel, V_f ≈6×1,14 V ). Daya yang diterima LED saat kondisi puncak dan rata-rata adalah:

P_((peak)) =V_F ×I_F =6,848×3,75=25,68W

P_((avg)) =P_((peak)) ×D=25,68×0,33=8,47W

2. Resistor Pembatas Arus 6 × 0,75Ω Paralel

Karena IR LED membutuhkan arus hingga 3,75A, diperlukan resistor pembatas arus yang mampu menangani daya besar. Menggunakan satu resistor tunggal tidak direkomendasikan karena disipasi dayanya terlalu besar dan berisiko overheat. Oleh karena itu, digunakan 6 buah resistor 0,75Ω yang dirangkai secara paralel, sehingga resistansi efektifnya adalah:

R_((eff)) =R/n=(0,75)/6=0,125Ω

Dengan konfigurasi paralel, arus terbagi merata sehingga setiap resistor hanya menanggung:

R_((each)) =(I_(total))/n=(3,75)/6=0,625Ω

Tegangan jatuh total pada jaringan resistor adalah:

V_R =I_((total)) ×R_((eff)) =3,75×0,125=0,469V

Daya yang didisipasikan oleh masing-masing resistor pada kondisi puncak adalah:

P_((each)) =I_(each)^2 ×R=0,625^2 ×0,75=0,293W

P_((total)) =6×0,293=1,758 W(peak)

3. MOSFET IRLZ44N Saklar Utama Arus Tinggi

Untuk mensaklar arus 3,75A dari sumber baterai 7,4V ke beban IR LED, digunakan MOSFET IRLZ44N. Pemilihan IRLZ44N didasarkan pada beberapa pertimbangan teknis. Pertama, IRLZ44N merupakan logic-level MOSFET dengan tegangan threshold V_(GS(th)) maksimum hanya 2V, sehingga dapat dikendalikan langsung oleh tegangan gate 5V dari MCP1406 tanpa memerlukan tegangan gate 10–12V seperti pada MOSFET konvensional (misalnya IRFZ44N). Kedua, IRLZ44N memiliki kemampuan arus drain I_D =47 A pada suhu 25°C , memberikan margin keamanan sebesar 47/3,75=12,5× terhadap arus aktual. Ketiga, tegangan drain-source maksimum V_(DS) =55 V jauh di atas tegangan operasional V_(bat) =7,4 V , memberikan margin 7,4 kali

Saat MOSFET dalam kondisi ON dengan V_(GS) =4,9 V dari MCP1406, resistansi konduksinya adalah R_(DS(on)) =22 mΩ (dari datasheet pada V_(GS) =5 V ). Tegangan jatuh pada MOSFET saat mengalirkan arus penuh adalah:

V_((DS)) =I_D ×R_(DS(ON)) =3,75×0,022=0,083 V

Daya yang didisipasikan MOSFET pada kondisi puncak dan rata-rata (duty cycle 33%) adalah:

P_((peak)) =I_D^2 ×R_(DS(ON)) =3,75^2 ×0,022=0,31 W

P_((avg)) =P_((peak)) ×D=0,31×0,33=0,10 W

Disipasi rata-rata sebesar 0,10W sangat rendah sehingga IRLZ44N tidak memerlukan heatsink tambahan dalam kondisi operasional normal.

4. MCP1406 Gate Driver

Meskipun pin GPIO ESP32-S3 secara teori dapat mengalirkan arus hingga 40mA, menggunakannya langsung untuk men-drive gate IRLZ44N pada frekuensi 38kHz menimbulkan risiko terhadap integritas sinyal dan keamanan GPIO. Gate MOSFET bersifat kapasitif dengan C_(iss) =1600 pF dan muatan gate total Q_g ≈30 nC pada V_(GS) =5 V . Oleh karena itu, digunakan IC gate driver MCP1406 yang mampu memberikan arus puncak ±6A untuk memastikan transisi switching yang cepat dan bersih.

Arus rata-rata yang dibutuhkan untuk men-charge dan men-discharge gate IRLZ44N pada frekuensi 38kHz adalah:

I_((gate,avg)) =Q_g ×f=30 nC×38.000=1,14 mA

Dengan resistor seri gate R_19 =100 Ω dan resistansi output internal MCP1406 R_(out) =1,6 Ω , arus puncak saat transisi gate adalah:

I_((gate,peak)) =(V_(OH) - V_(plateu))/(R_(out) +R_19)=(4,9-2,5)/(1,6+100)=(2,4)/(101,6)23,6mA

Rise time gate dihitung berdasarkan konstanta waktu RC :

t_((rise)) =(R_((out)) +R_((19)) ×C_((iss)) )=101,6×1600 pF=162 ns

Nilai ini jauh lebih cepat dari satu periode sinyal 38kHz ( 26,3 µs ), sehingga switching berlangsung bersih tanpa distorsi. Total arus yang dikonsumsi MCP1406 dari rail 5V adalah:

I_((DD,total)) =I_((quiescent)) +I_((switch)) =1+1,14=2,14mA

5. BC847B , Antarmuka GPIO ke MCP1406

Input MCP1406 membutuhkan tegangan logika 5V ( V_(IH) =2,4 V ), sementara GPIO ESP32-S3 hanya menghasilkan tegangan tinggi V_(OH) =3,3 V . Untuk menjembatani perbedaan level logika ini sekaligus melindungi GPIO dari beban langsung ke jalur 5V, digunakan transistor NPN BC847B dalam konfigurasi common-emitter. Saat GPIO bernilai HIGH, arus basis mengalir melalui resistor R_17 =330 Ω :

I_B =(V_(GPIO) -V_(BE))/(R_17)=(3,3-0,7)/330=(2,6)/330=7,88mA

Arus kolektor yang mengalir saat transistor saturasi, dibatasi oleh resistor pull-up 1kΩ ke 5V:

I_B =(V_(CC) -V_(CE(SAT)))/(R_(pullup))=(5-0,1)/1000=4,9mA

Penguatan arus DC yang dibutuhkan agar transistor mencapai saturasi adalah:

h_((fe,required)) =(I_C)/(I_B)=(4,9)/(7,88)=0,62

Nilai ini jauh di bawah h_(FE) minimum BC847B yaitu 110 (grup B: 200–450), artinya transistor berada dalam kondisi deep saturation dengan V_(CE(sat)) =0,1 V . Tegangan rendah ini diteruskan ke input MCP1406 sebagai sinyal LOW yang valid ( V_(IL) <0,8 V terpenuhi). Daya yang didisipasikan BC847B sangat kecil:

P_((BC847B)) =V_((CE(sat))) ×I_C =0,1×4,9 mA=0,49 mW≈0 W

6. GPIO ESP32-S3 Supermini sebagai Sumber Sinyal Kontrol

Seluruh rantai kendali bermula dari pin GPIO ESP32-S3 Supermini yang menghasilkan sinyal PWM 38kHz sesuai protokol NEC. Pin GPIO menghasilkan tegangan tinggi V_(OH) =3,3 V dan hanya dibebani oleh arus basis BC847B melalui R_17 =330 Ω :

I_(GPIO) =(V_(OH) -V_(BE))/(R_17)=(3,3-0,7)/330=7,88mA

Arus ini berada di bawah batas aman rekomendasi GPIO ESP32-S3 sebesar 12mA (batas absolut 40mA), sehingga pin terlindungi dari kerusakan. Daya total yang dikonsumsi dari pin GPIO adalah:

P_((avg)) =P_((peak)) ×I_((GPIO)) =3,3×0,00788=26 mW

7. Verifikasi KVL Loop Utama

Sebagai validasi akhir, seluruh tegangan pada loop arus tinggi dijumlahkan menggunakan Hukum Kirchhoff Tegangan:

V bat= V DS+ VR+ VF
7,4 V=0,083 V+0,469 V+6,848 V =

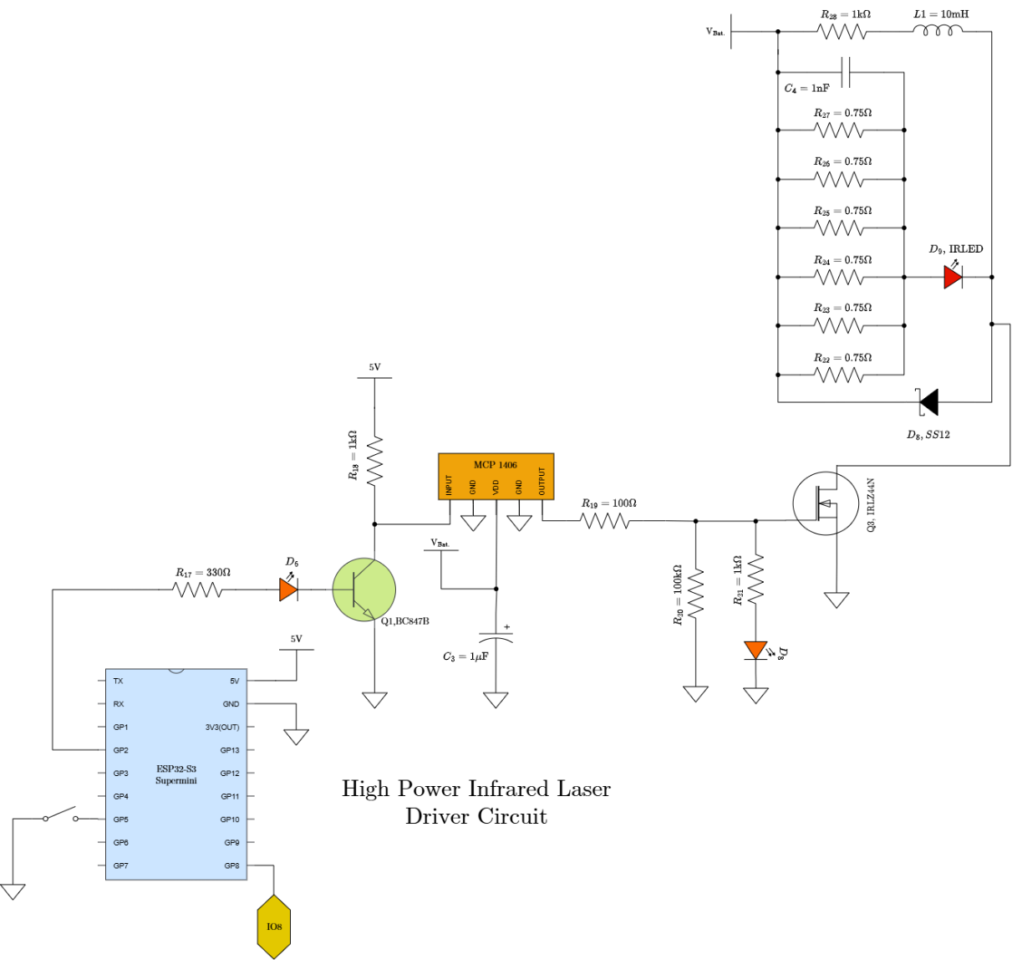
[picture p26: figure]

Gambar 23 Gambar Rangkaian keseluruhan Inframerah Driver

### 3.4.3 Perancangan Rangkaian Helm dengan Sensor Penerima Inframerah dan Mekanisme Anti-Cheating

Rangkaian ini dirancang sebagai sistem deteksi cheating berbasis inframerah (IR), di mana keberadaan objek yang menutupi sinyal IR akan menghasilkan perubahan logika yang dapat diproses oleh mikrokontroler (ESP32-S3 Supermini) melalui rangkaian logika (74HC4078) dan komparator (LM393).

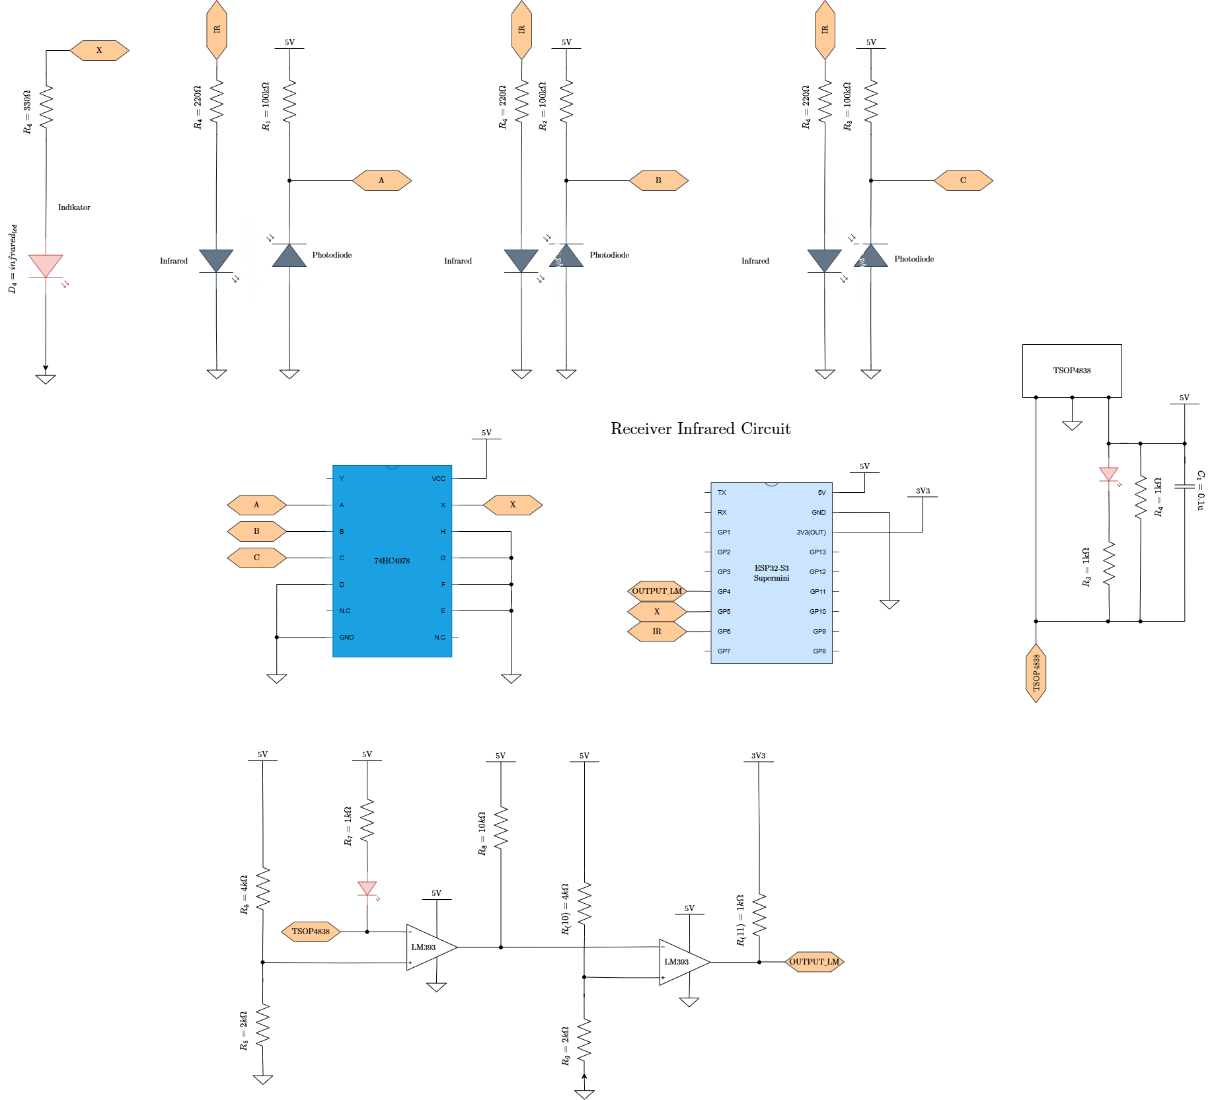
[picture p27: figure]

Gambar 24 Rangkaian Penerima Inframerah Anti-Cheating

#### a. TSOP4838 dan LM393

Rangkaian penerima inframerah Anti-Cheating yang diimplementasikan menggunakan modul TSOP4838 dan komparator ganda LM393 dirancang untuk mendeteksi sinyal inframerah 38 kHz dengan akurasi tinggi dan respons logika yang terstruktur. Analisis berikut bertujuan untuk mengkarakterisasi perilaku tegangan dan arus pada setiap tahap rangkaian, serta mengevaluasi integritas logika output dalam konteks aplikasi deteksi kecurangan.

Saat TSOP4838 aktif (output LOW) LED menyala. V_(CC) =5V, V_(LED) =2V maka arus LED dihitung dengan hukum Ohm seperti persamaan 1.7:

I_((LED)) =(VCC-VLED)/(R_3 +R_4)=(5V-2V)/(1kΩ+1kΩ)=1.5mA

Komparator Pertama (U1 - LM393A). Input Non-Inverting (+): Terhubung ke pembagi tegangan dari R₆ = 4kΩ dan R₅ = 2kΩ menghasilkan referensi. Input Inverting (-): Terhubung ke output TSOP4838 melalui R₇ = 1kΩ dan LED (dengan R₈ = 4kΩ sebagai pull-up) Output U1: Terhubung ke input inverting (-) dari komparator kedua (U2) melalui R₁₀ = 10kΩ. Maka tehgangan referensi dapat dihitung seperti persamaan 1.6:

V_(ref1) =VCC×(R_6)/(R_5 +R_6)=5V×(2kΩ)/(4kΩ+2kΩ)=1.67V

Komparator Kedua (U2 - LM393A) Input Non-Inverting (+): Terhubung ke pembagi tegangan dari R₁₀ = 4kΩ dan R₉ = 2kΩ → referensi 3.3V. Input Inverting (-): Terhubung ke output U1 melalui R₁₀ = 10kΩ. Output U2: Terhubung ke OUTPUT LM melalui R₁₁ = 1kΩ (pull-up ke sumber 3.3V). Maka tehgangan referensi dapat dihitung seperti persamaan 1.6:

V_(ref2) =VCC×(R_6)/(R_5 +R_6)=5V×(2kΩ)/(4kΩ+2kΩ)=1.67V

#### b. Rangkaian Anti-Cheating

Cara kerjanya konfigurasi photodiode: mode reverse bias. Photodiode disambungkan antara ground dan output, dengan resistor pull-up ke 5V. Saat terkena cahaya IR arus photocurrent mengalir tegangan di node output turun sehingga logika LOW. Saat tidak terkena cahaya (IR ditutup) arus bocor sangat kecil tegangan di node output ≈ 5V sehingga logika HIGH.

Kondisi 1: IR MENYALA (Photodiode TERKENA CAHAYA) Arus photocurrent I_(ph) atau I_((ra)) =60μA (berdasarkan datasheet) dan resistor pull-up R₁ = 100kΩ. Maka dapat dihitung sebagai berikut:

V_(ABC) =VCC-I_((photodiode)) ×R1 =5V-(60μA×10^(-6) A)×(100×10^3 Ω)=5V-6V=-1V | (4.1)

Namun, untuk VR = 5 V, nilai Ira = 60 µA adalah nilai maksimum artinya, jika sumber cahaya cukup kuat (Ee = 1 mW/cm²), photodiode akan menghasilkan arus ~60 µA. Jadi, tegangan output tidak akan turun di bawah 0 V maka akan jatuh ke ~0 V (saturasi). VABC = 0 V dengan logika LOW

Kondisi 2: IR DITUTUP (Photodiode TIDAK TERKENA CAHAYA). Arus dark current: I_(dark) =1 nA (typical) dan resistor pull-up R₁ = 100kΩ. Maka dapat dihitung sebagai berikut.

V_((ABC)) =VCC-I_((dark)) ×R1 =5V-(1×10^((-9)) ×1×10^((5)) )=4.999V | (4.2)

Maka VABC = 4.999V dengan l logika HIGH

Sistem Anti-Cheating menggunakan gerbang logika NOR 8 masukan dengan persamaan Y=A+B+C+D+E+F+G+H . Pada implementasinya di helm, hanya empat masukan yang digunakan untuk photodiode (A, B, C, dan D), sedangkan empat masukan lainnya dihubungkan ke ground (logika LOW). Dengan demikian, persamaan logika efektif menjadi Y=A+B+C+D . Output bernilai HIGH hanya ketika seluruh photodiode menerima cahaya (A=B=C=D=LOW). Apabila salah satu photodiode tidak menerima cahaya sehingga menghasilkan logika HIGH, maka output NOR berubah menjadi LOW yang menandakan terdeteksinya tindakan cheating.

### 3.4.4 Perancangan Rangkaian Vest (Penerima Inframerah, Anti-Cheating, dan Transmisi Data)

Rangkaian vest (rompi) pada sistem permainan laser tag ini dirancang sebagai modul penerima inframerah sekaligus pusat kendali pemrosesan dan pengiriman data. Sistem ini mendeteksi status tembakan (HIT) dan potensi kecurangan (CHEAT), serta mengakuisisi data GPS berupa longitude, latitude, altitude, dan jumlah satelit. Seluruh data diproses oleh mikrokontroler Heltec Wireless Tracker V1.2, kemudian dikirimkan ke server melalui komunikasi LoRa maupun GPRS menggunakan modul SIM900A, atau disimpan pada modul SD Card sebagai cadangan data. Sumber daya yang digunakan sama seperti ala lainnya . Pada rangkaian vest ini menggunakan sumber daya yang sama seperti helm dan juga senjata.

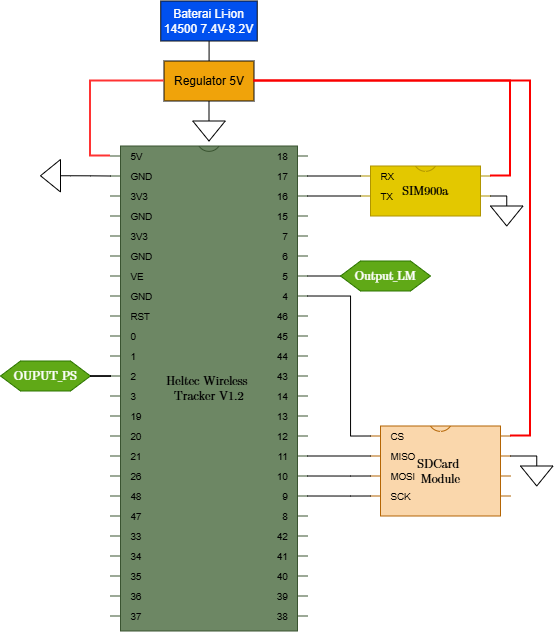
[picture p28: figure]
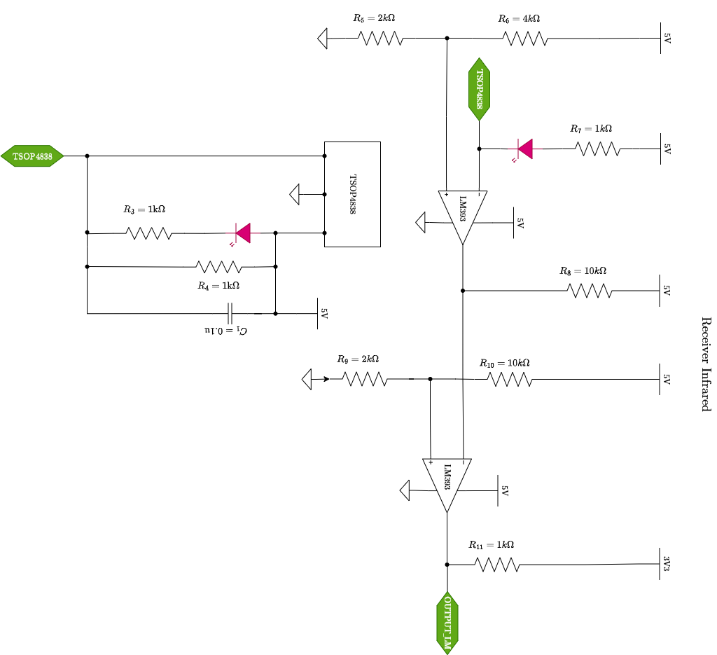
[picture p29: figure]
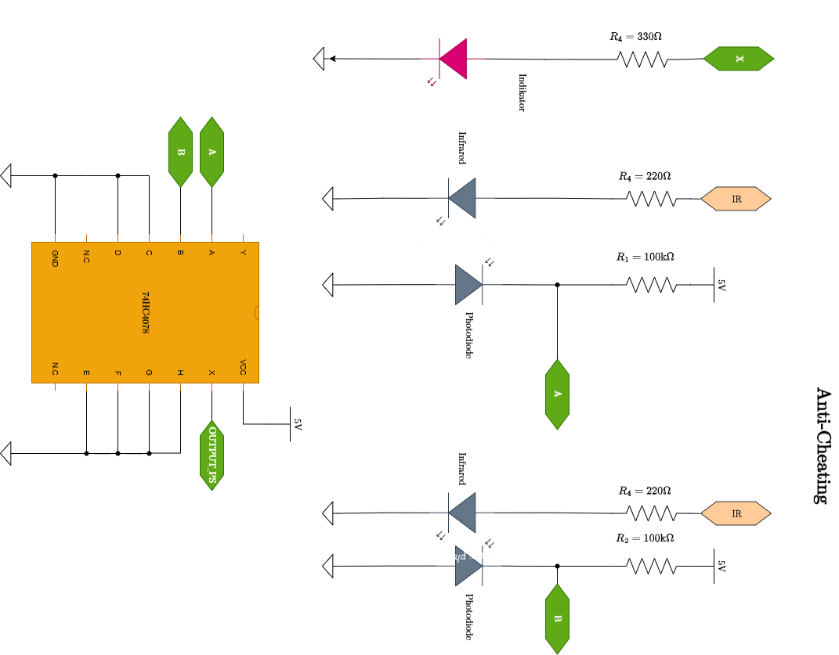
[picture p30: figure]

Gambar 25 Rangkaian pada Rompi

#### 1. Rangkaian SDCard Module

Modul SD Card pada sistem ini berfungsi sebagai media penyimpanan data lokal (local storage) untuk mencatat riwayat tembakan, posisi GPS, dan status permainan ketika komunikasi LoRaWAN atau GPRS tidak tersedia. Modul ini terintegrasi dengan Heltec Wireless Tracker V1.2 yang berbasis mikrokontroler ESP32-S3 melalui antarmuka SPI (Serial Peripheral Interface). Modul SD Card menggunakan regulator tegangan onboard AMS1117-3.3 untuk menurunkan tegangan input 5 V menjadi 3,3 V yang dibutuhkan oleh kartu microSD, sehingga kompatibel dengan level logika ESP32-S3

Perhitungan Daya Input Modul SD Card, dengan V_(CC) =3,3V dan I_(CC) =100mA

P_(in) =V_(CC) ×I_(CC) P_(in) =3,3V×0,1A=0,33W | 4.5

Perhitungan Kapasitas Penyimpanan Data: Kartu microSD dengan kapasitas 16 GB dapat menyimpan data dalam format teks dengan estimasi sebagai berikut:

Data_(per_event) =100 byte/event Total_(events) =(16×10^9 byte)/(100 byte/event)=160.000.000 event | 4.6

## 3.5 Perancangan Software

Berikut merupakan flowchart sistem dari alat yang akan dirancang dapat dilihat pada Gambar 34 Flowchart.

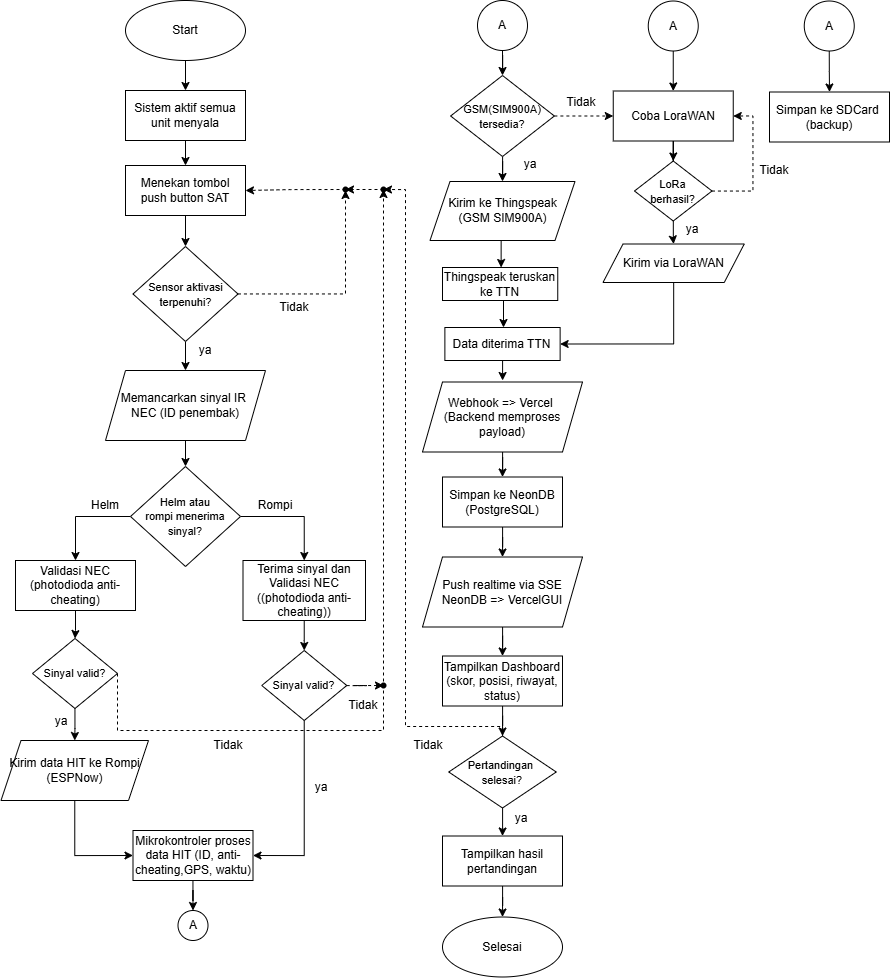
[picture p31: figure]

Gambar 26 Flowchart

Deskripsi Flowchart:

Sistem laser tag IoT diawali ketika seluruh unit perangkat keras yaitu SAT, Helm, dan Rompi dinyalakan dan siap beroperasi. Ketika pemain menekan Push Button utama pada unit SAT, mikrokontroler ESP32-S3 SuperMini akan memeriksa apakah ketiga sensor aktivasi yaitu sensor suara, sensor getar, dan sensor api terpenuhi secara bersamaan sebagai syarat wajib sebelum tembakan dilepaskan. Apabila seluruh sensor aktif, SAT memancarkan sinyal Inframerah berprotokol NEC yang membawa data ID penembak melalui LED yang difokuskan lensa Fresnel ke arah lawan. Sinyal tersebut dapat diterima oleh Helm maupun Rompi. Jika Helm yang terkena, ESP32-S3 SuperMini pada Helm melakukan validasi protokol NEC sekaligus pemeriksaan Anti-Cheating melalui photodiode, dan apabila valid, data HIT diteruskan ke Rompi menggunakan komunikasi nirkabel ESP-NOW. Jika Rompi yang menerima sinyal secara langsung, data langsung diolah oleh mikrokontroler Heltec Wireless Tracker V1.2 yang menggabungkan informasi ID penembak, lokasi sensor, waktu tembakan, dan koordinat GPS dari modul GPS internal.

Setelah Heltec selesai memproses data, sistem secara paralel langsung menyimpan seluruh data ke kartu SD sebagai backup lokal permanen, kemudian mencoba mengirimkan data melalui jalur komunikasi berdasarkan prioritas. Jalur utama adalah GSM menggunakan modul SIM900A yang mengirimkan data ke platform ThingSpeak, kemudian ThingSpeak meneruskannya ke The Things Network (TTN). Apabila jaringan GSM tidak tersedia, sistem beralih ke jalur cadangan menggunakan LoRaWAN yang mengirimkan data langsung ke TTN. Setelah data berhasil diterima TTN dari jalur manapun, TTN meneruskan payload melalui webhook ke platform Vercel yang berperan sebagai backend sekaligus frontend hosting. Vercel memproses data tersebut dan menyimpannya ke database PostgreSQL melalui layanan NeonDB, lalu mendorong pembaruan secara real-time ke antarmuka dashboard menggunakan teknologi Server-Sent Events (SSE) sehingga status pemain, skor, riwayat tembakan, dan posisi pemain dapat dipantau langsung tanpa perlu refresh halaman hingga pertandingan dinyatakan selesai.

# BAB IV PENGUJIAN DAN ANALISA

Pada bab ini disajikan hasil pengujian sistem yang telah dilakukan baik secara per blok komponen maupun secara keseluruhan, beserta analisis terhadap data yang diperoleh dari hasil pengujian. Proses pengujian dimulai dari masing-masing blok rangkaian elektronik dan modul komunikasi, kemudian dilanjutkan dengan pengujian integrasi sistem secara menyeluruh. Hasil pengujian tersebut selanjutnya akan dianalisis untuk mengetahui apakah sistem telah bekerja sesuai dengan rancangan yang direncanakan, termasuk kemampuan deteksi serangan, akurasi pengiriman data, serta keandalan komunikasi dalam berbagai kondisi medan latihan yang beragam.

## 4.1 Pengujian perblok

Pengujian sistem perblok bertujuan untuk memverifikasi fungsi masing-masing komponen dalam Sistem Senjata sebelum melakukan pengujian keseluruhan. Dengan menguji setiap blok secara terpisah, kita dapat memastikan bahwa tidak ada masalah pada komponen individu yang dapat menyebabkan gangguan pada sistem keseluruhan.

### 4.1.1 Pengujian Rangkaian Power Regulator (pengujian daya helm, senjata dan rompi)

1. LM7805

Pengujian dilakukan dengan memberikan input tegangan yang bervariasi (dari 7.0V hingga 8.2V). Setiap level tegangan masukan diukur menggunakan multimeter digital, dan tegangan keluaran regulator dicatat. Pengujian dilakukan masing masing sebanyak lima kali percobaan dengan kondisi tanpa beban. Error (%) dihitung menggunakan rumus sebagai berikut:

Error(%)=((Output-TargetOutput)/(TargetOutput))×100 | (5.0)

Hasil pengujian ditunjukkan pada Tabel .7 dengan hasil pengujian sebagai berikut

Tabel 7 Pengujian LM7805

REGULATOR LM7805
| INPUT | OUTPUT | TARGET OUTPUT | ERROR
1 | 7.98V | 5.08V | 5V | 0.16%
2 | 8.02V | 5.08V | 5V | 0.16%
3 | 8.10V | 5.08V | 5V | 0.16%
4 | 8.11V | 5.08V | 5V | 0.16%
5 | 8.12V | 5.08V | 5V | 0.16%
6 | 8.14V | 5.08V | 5V | 0.16%

### 4.1.2 Pengujian Rangkaian Penerima Inframerah

Tujuan dari pengujian rangkaian penerima inframerah adalah untuk memastikan data yang diterima oleh rangkaian penerima inframerah sama dengan data yang dikirim oleh rangkaian pemancar inframerah.

#### 1. Parameter Jarak

Tabel 8 Pengujian Jarak Penerimaan

No | Jarak | Indikator LED | Output Sensor | Status Data
1 | 50 meter | Aktif | 2.55 V | Diterima
2 | 150 meter | Aktif | 2.63 V | Diterima
| 170 meter | Aktif | 2.44 V` | Diterima
3 | 200 meter | Aktif | 2.25 V | Diterima
4 | 250 meter | Aktif | 3.39 V | Tak Diterima
5 | 300 meter | Aktif | 3.36V | Tak Diterima

Berdasarkan data pada tabel dapat dianalisa bahwa sensor TSOP4838 dapat menerima sinyal inframerah dari jarak 50 meter sampai 500 meter. Hal ini juga di pengaruhi oleh kemampuan pemancar yang sangat kuat yang membuat pemancar bisa memancar dalam jarak yang cukup jauh. Pengujian dilakukan pada malam hari agar tidak ada gangguan dari cahaya lain seperti cahaya matahari bertujuan untuk memaksimalkan kinerja pemancar maupun penerima sinyal atau cahaya inframerah

#### 2. Parameter Sudut

Tabel 9 Pengujian Sudut Penerimaan

No | Parameter Sudut | Tanpa Lensa | Menggunakan Lensa
1 | 0⁰ | Respon | Respon
2 | 15⁰ | Respon | Respon
3 | 30⁰ | Respon | Respon
4 | 45⁰ | Respon | Respon
5 | 60⁰ | Tidak Respon | Respon
6 | 75⁰ | Tidak Respon | Respon
7 | 90⁰ | Tidak Respon | Respon
8 | 105⁰ | Tidak Respon | Respon
9 | 135⁰ | Tidak Respon | Respon
10 | 180⁰ | Tidak Respon | Respon

Berdasarkan hasil pengujian sudut inframerah, sistem hanya mampu mendeteksi sinyal secara konsisten hingga sudut 45° tanpa lensa dan hingga 180° saat menggunakan lensa; namun, pada sudut 180°, meskipun respons tercatat, jangkauan deteksi maksimalnya terbatas hanya sekitar 50-60 meter, menunjukkan bahwa meskipun lensa memperluas cakupan sudut deteksi, efektivitas jaraknya tetap terbatas dan tidak optimal dibandingkan pada sudut lebih kecil.

#### 3. Receiver Anti-Cheating

Tabel 10 Pengujian Anti-Cheating

No | Kondisi Anti-Cheating | | | | Output NOR
| A | B | C | D | X
1 | 0 | 0 | 0 | 0 | 1
2 | 0 | 0 | 0 | 1 | 0
3 | 0 | 0 | 1 | 0 | 0
4 | 0 | 0 | 1 | 1 | 0
5 | 0 | 1 | 0 | 0 | 0
6 | 0 | 1 | 0 | 1 | 0
7 | 0 | 1 | 1 | 0 | 0
8 | 0 | 1 | 1 | 1 | 0
9 | 1 | 0 | 0 | 0 | 0
10 | 1 | 0 | 0 | 1 | 0
11 | 1 | 0 | 1 | 0 | 0
12 | 1 | 0 | 1 | 1 | 0
13 | 1 | 1 | 0 | 0 | 0
14 | 1 | 1 | 0 | 1 | 0
15 | 1 | 1 | 1 | 0 | 0
16 | 1 | 1 | 1 | 1 | 0

Berdasarkan tabel diatas tersebut ketika salah satu sensor itu ditutup makan sistem akan mendeteksi cheat sebaliknya Ketika tidak ada yang ditutupi sisitem tidak akan mendeteksi cheat.

      4. Pengujian ESP-NOW via Helm

Tabel 11 Pengujian ESP-NOW

No | Halo Status | Data Send | Harness Status | Data Receive | RSSI
1 | Sent | Hello, World! #4 | Receive | Hello, World! #4 | -95Bm
2 | Sent | Hello, World! #5 | Receive | Hello, World! #5 | -94dBm
3 | Sent | Hello, World! #6 | Receive | Hello, World! #6 | -91dBm
4 | Sent | Hello, World! #7 | Receive | Hello, World! #7 | -91dBm
5 | Sent | Hello, World! #8 | Receive | Hello, World! #8 | -91dBm
6 | Sent | Hello, World! #9 | Receive | Hello, World! #9 | -92dBm
7 | Sent | Hello, World! #10 | Receive | Hello, World! #10 | -92dBm
8 | Sent | Hello, World! #11 | Receive | Hello, World! #11 | -92dBm
9 | Sent | Hello, World! #12 | Receive | Hello, World! #12 | -93dBm
10 | Sent | Hello, World! #13 | Receive | Hello, World! #13 | -93dBm

Berdasarkan hasil pengujian komunikasi dua arah menggunakan protokol ESP-NOW menunjukkan bahwa semua pesan "Hello, World! #n" berhasil diterima oleh rompi tanpa error, meskipun perangkat ditempatkan di dalam kardus dan terhalang dinding. Nilai RSSI berkisar antara –91 dBm hingga –95 dBm, menandakan sinyal lemah namun masih cukup andal untuk komunikasi jarak dekat

### 4.1.3 Pengujian Heltec Tracker V1.2

#### 1. Pengujian protocol komunikasi ESP-NOW

Pengujian protokol ESP-NOW dilakukan untuk mengevaluasi komunikasi nirkabel satu arah antara unit Helm dan Rompi berbasis ESP32, tanpa bergantung pada infrastruktur Wi-Fi atau perangkat perantara. Pada pengujian ini, ESP32-S3 Supermini yang berperan sebagai Helm berfungsi sebagai pengirim (sender), sedangkan Heltec Tracker V1.2 sebagai Rompi berfungsi sebagai penerima (receiver). Kedua perangkat ditempatkan pada jarak sekitar 4 meter, masing-masing dimasukkan ke dalam kardus dan dipisahkan oleh dinding sebagai penghalang. Helm mengirimkan data secara broadcast berupa pesan teks real-time “Hello, World! #n” (dengan n sebagai nomor urut pesan). Tujuan pengujian adalah memverifikasi keandalan pengiriman data dalam kondisi lingkungan yang menantang. Hasil pengujian ini disajikan pada Tabel 10 berikut.

Tabel 12 Pengujian ESPNOW via Heltec Wireless Tracker V1.2

No | Halo Status | Data Send | Harness Status | Data Receive | RSSI
1 | Sent | Hello, World! #4 | Receive | Hello, World! #4 | -95Bm
2 | Sent | Hello, World! #5 | Receive | Hello, World! #5 | -94dBm
3 | Sent | Hello, World! #6 | Receive | Hello, World! #6 | -91dBm
4 | Sent | Hello, World! #7 | Receive | Hello, World! #7 | -91dBm
5 | Sent | Hello, World! #8 | Receive | Hello, World! #8 | -91dBm
6 | Sent | Hello, World! #9 | Receive | Hello, World! #9 | -92dBm
7 | Sent | Hello, World! #10 | Receive | Hello, World! #10 | -92dBm
8 | Sent | Hello, World! #11 | Receive | Hello, World! #11 | -92dBm
9 | Sent | Hello, World! #12 | Receive | Hello, World! #12 | -93dBm
10 | Sent | Hello, World! #13 | Receive | Hello, World! #13 | -93dBm

Berdasarkan hasil pengujian komunikasi dua arah menggunakan protokol ESP-NOW menunjukkan bahwa semua pesan "Hello, World! #n" berhasil diterima oleh rompi tanpa error, meskipun perangkat ditempatkan di dalam kardus dan terhalang dinding. Nilai RSSI berkisar antara –91 dBm hingga –95 dBm, menandakan sinyal lemah namun masih cukup andal untuk komunikasi jarak dekat.

#### 2. Pengujian GPS

Tujuan dari pengujian modul GPS adalah untuk memastikan tingkat keakuratan modul serta memastikan bahwa data yang diterima dari satelit dapat diproses dengan benar oleh mikrokontroler Heltec Wireless Tracker. Selanjutnya, modul GPS dipindahkan sejauh 5 meter setiap 1 menit sambil diamati nilai koordinat geografis berupa Latitude, Longitude, dan Satellite melalui serial monitor dan TFT pada Heltec Wireless Tracker. Perubahan posisi dimaksudkan untuk mengevaluasi respon dan akurasi pembacaan lokasi oleh sistem. Hasil pengujian modul GPS menunjukkan bahwa sistem mampu membaca dan memperbarui koordinat secara konsisten pada setiap perpindahan posisi. Sebagai validasi tambahan, koordinat hasil pengujian dibandingkan secara umum dengan koordinat GPS referensi yang diperoleh dari perangkat GPS komersial disajikan padaTabel 11 berikut

Tabel 13 Pegujian GPS

No | Posisi | Lat. Percobaan | Lon. Percobaan | Lat. Referensi | Lon. Referensi | Satelit | Status
1 | Pos 1 | -7.942939 | 112.613513 | -7.942910 | 112.613480 | 12 | Baik
2 | Pos 2 | -7.942937 | 112.613512 | -7.942910 | 112.613480 | 17 | Baik
3 | Pos 3 | -7.942940 | 112.613514 | -7.942910 | 112.613480 | 15 | Baik
4 | Pos 4 | -7.942738 | 112.613485 | -7.942710 | 112.613460 | 22 | Baik
5 | Pos 5 | -7.942737 | 112.613483 | -7.942710 | 112.613460 | 21 | Baik
6 | Pos 6 | -7.942755 | 112.613568 | -7.942725 | 112.613540 | 23 | Baik
7 | Pos 7 | -7.942758 | 112.613727 | -7.942725 | 112.613700 | 18 | Baik
8 | Pos 8 | -7.942760 | 112.613731 | -7.942725 | 112.613700 | 18 | Baik
9 | Pos 9 | -7.942808 | 112.613787 | -7.942775 | 112.613755 | 10 | Cukup
10 | Pos 10 | -7.942817 | 112.613767 | -7.942770 | 112.613720 | 0 | Buruk

#### 5. Pengujian LoRa

Pengujian komunikasi LoRaWAN dilakukan untuk mengevaluasi kemampuan ESP32 pada Heltec Wireless Tracker dalam mengirimkan data status permainan melalui jaringan LoRa hingga tersimpan di server cloud. Perangkat melakukan join network ke The Things Network menggunakan metode OTAA, kemudian mengirimkan data sebagai payload biner melalui pesan uplink. Data tersebut didekodekan oleh TTN dan diteruskan melalui webhook ke endpoint Vercel (/api/ttn) menggunakan metode HTTP POST dalam format JSON. Heltec Wireless Tracker V1.1 menggunakan chip LoRa SX1262 dengan TX Power maksimum 21 ± 1 dBm, sensitivitas penerimaan -134 dBm (SF12), dan jangkauan teoritis hingga 15 km pada kondisi outdoor ideal berdasarkan datasheet resmi Heltec (Rev 1.1, 2023). Pada percobaan nyata di area Graha Polinema dengan frekuensi AS923 (923 MHz), komunikasi berhasil dilakukan hingga jarak ±800 meter dengan RSSI -118 dBm dan SNR -2,0 dB, sedangkan pada jarak ±900 meter ke atas paket tidak berhasil diterima (Not Received). Hasil pengujian selengkapnya dapat dilihat pada tabel 12 berikut.

Tabel 14 Pengujian LoRa

Perc. | Jarak | Kondisi | Data Send | Status | Data Receiver | RSSI / SNR | Waktu Respon | Keterangan
1 | ±5 m | Outdoor terbuka | Lat:-7.942899,Long:112.613647,Alt:1m,Sat:0,RSSI:-70dBm,SNR:10.0dB | Received | Lat:-7.942899,Long:112.613647,Alt:1m,Sat:0,RSSI:-70dBm,SNR:10.0dB | -70 dBm / 10.0 dB | 3 detik | sinyal sangat kuat
2 | ±5 m | Outdoor terbuka | Lat:-7.942917,Long:112.613663,Alt:1m,Sat:0,RSSI:-70dBm,SNR:9.0dB | Received | Lat:-7.942917,Long:112.613663,Alt:1m,Sat:0,RSSI:-70dBm,SNR:9.0dB | -70 dBm / 9.0 dB | 3 detik | sinyal sangat kuat
3 | ±7 m | Outdoor terbuka | Lat:-7.942923,Long:112.613670,Alt:1m,Sat:0,RSSI:-70dBm,SNR:9.0dB | Received | Lat:-7.942923,Long:112.613670,Alt:1m,Sat:0,RSSI:-70dBm,SNR:9.0dB | -70 dBm / 9.0 dB | 5 detik | sinyal sangat kuat
4 | ±10 m | Outdoor terbuka | Lat:-7.942907,Long:112.613678,Alt:1m,Sat:0,RSSI:- 570dBm,SNR:9.60dB | Received | Lat:-7.942907,Long:112.613678,Alt:1m,Sat:0,RSSI:-70dBm,SNR:9.0dB | -70 dBm / 9.0 dB | 3 detik | sinyal sangat kuat
5 | ±20 m | Outdoor terbuka | 7Lat:-7.9429835,Long:112.613686,Alt:1m,Sat:0,RSSI:-70dBm,SNR:9.0dB | Received | Lat:-7.942935,Long:112.613686,Alt:1m,Sat:0,RSSI:-70dBm,SNR:9.0dB | -70 dBm / 9.0 dB | 5 detik | sinyal sangat kuat
6 | ±100 m | Outdoor terbuka | Lat:-7.942850,Long:112.614100,RSSI:-75dBm,SNR:8.5dB | Received | Lat:-7.942850,Long:112.614100,RSSI:-75dBm,SNR:8.5dB | -75 dBm / 8.5 dB | 3 detik | Sinyal kuat, packet loss 0%
7 | ±200 m | Outdoor terbuka | Lat:-7.942780,Long:112.614550,RSSI:-82dBm,SNR:7.0dB | Received | Lat:-7.942780,Long:112.614550,RSSI:-82dBm,SNR:7.0dB | -82 dBm / 7.0 dB | 3 detik | Sinyal baik, latensi stabil
8 | ±300 m | Outdoor terbuka | Lat:-7.942700,Long:112.615000,RSSI:-89dBm,SNR:5.5dB | Received | Lat:-7.942700,Long:112.615000,RSSI:-89dBm,SNR:5.5dB | -89 dBm / 5.5 dB | 4 detik | Sinyal cukup, mulai melemah
9 | ±400 m | Outdoor terbuka | Lat:-7.942620,Long:112.615450,RSSI:-95dBm,SNR:4.0dB | Received | Lat:-7.942620,Long:112.615450,RSSI:-95dBm,SNR:4.0dB | -95 dBm / 4.0 dB | 4 detik | Sinyal cukup, masih handal
10 | ±500 m | Outdoor terbuka | Lat:-7.942540,Long:112.615900,RSSI:-101dBm,SNR:2.5dB | Received | Lat:-7.942540,Long:112.615900,RSSI:-101dBm,SNR:2.5dB | -101 dBm / 2.5 dB | 4 detik | Sinyal mulai menurun
11 | ±600 m | Outdoor terbuka | Lat:-7.942460,Long:112.616350,RSSI:-107dBm,SNR:1.0dB | Received | Lat:-7.942460,Long:112.616350,RSSI:-107dBm,SNR:1.0dB | -107 dBm / 1.0 dB | 5 detik | Sinyal lemah, sesekali delay
12 | ±700 m | Outdoor terbuka | Lat:-7.942380,Long:112.616800,RSSI:-112dBm,SNR:-0.5dB | Received | Lat:-7.942380,Long:112.616800,RSSI:-112dBm,SNR:-0.5dB | -112 dBm / -0.5 dB | 5 detik | Sinyal lemah, SNR mendekati batas
13 | ±800 m | Outdoor terbuka | Lat:-7.942300,Long:112.617250,RSSI:-118dBm,SNR:-2.0dB | Received | Lat:-7.942300,Long:112.617250,RSSI:-118dBm,SNR:-2.0dB | -118 dBm / -2.0 dB | 5 detik | Batas efektif – masih diterima
14 | ±900 m | Outdoor terbuka | Lat:-7.942220,Long:112.617700,RSSI:-124dBm,SNR:-4.0dB | Not Received | - | -124 dBm / -4.0 dB | Timeout | Packet loss tinggi, timeout
15 | ±1000 m | Outdoor terbuka | Lat:-7.942140,Long:112.618150,RSSI:-128dBm,SNR:-6.5dB | Not Received | - | -128 dBm / -6.5 dB | Timeout | Tidak diterima, di luar jangkauan

### 4.1.4 Pengujian Keseluruhan

Pengujian ini bertujuan untuk memastikan seluruh komponen laser tag mulai dari senjata, helm, hingga rompi dapat bekerja secara terpadu dan stabil dalam skenario nyata. Fokus utamanya adalah menguji keandalan komunikasi antarperangkat dan kecepatan pengolahan data secara real-time. Dalam praktiknya, simulasi dilakukan setelah semua modul terhubung ke server, di mana Unit ID "1" melakukan lima kali tembakan ke arah helm atau rompi Unit ID "2" dari jarak 20 meter. Hasil dari respons sistem dan akurasi pengiriman data pada pengujian ini telah dirangkum dalam Tabel 13 berikut

Tabel 15 Pengujian Unit 2

ID | Status | Penembak | Head / Vest | Waktu | Lokasi Unit
2 | Hit | Unit 1 | Head | 14:02:15 | -7.942939, 112.613513
2 | Hit | Unit 1 | Vest | 14:02:47 | -7.942940, 112.613514
2 | Hit | Unit 1 | Vest | 14:03:22 | -7.942941, 112.613515
2 | Miss | Unit 1 | - | 14:03:59 | 7.942939, 112.613513
2 | Hit | Unit 1 | Head | 14:04:34 | -7.942938, 112.613512

Pengujian kedua unit dengan ID “2” melakukan lima kali tembakan kearah Helm dan Rompi dari unit dengan ID “1” pada jarak 20 m. Data yang diterima oleh server dari hasil pengujian ini disajikan pada tabel 19. berikut ini

Tabel 16 Pengujian Unit 1

ID | Status | Penembak | Head / Vest | Waktu | Lokasi Unit
1 | Hit | Unit 2 | Vest | 14:06:10 | -7.943481, 112.613567
1 | Hit | Unit 2 | Head | 14:06:45 | -7.943483, 112.613569
1 | Miss | Unit 2 | - | 14:07:19 | -7.943482, 112.613568
1 | Hit | Unit 2 | Vest | 14:07:54 | -7.943480, 112.613566
1 | Hit | Unit 2 | Head | 14:08:29 | -7.943484, 112.613570

# BAB V

## 5.1 Kesimpulan

Berdasarkan hasil perancangan, implementasi, dan pengujian sistem Laser Tag berbasis ESP-NOW dan LoRa yang telah dilakukan, dapat ditarik kesimpulan sebagai berikut:

Pengujian regulator LM7805 menghasilkan tegangan keluaran sebesar 5,08 V dari tegangan masukan 7,98–8,14 V dengan error sebesar 0,16%, menunjukkan kestabilan catu daya yang sangat baik untuk seluruh subsistem. Rangkaian pemancar inframerah yang dilengkapi sensor suara, sensor getar, dan sensor api mampu mendeteksi kondisi aktivasi tembakan dengan akurat: sensor suara aktif pada intensitas di atas 59 dB, sensor getar merespons getaran ketukan dan jatuh dengan tegangan turun ke 120 mV–1,91 V (di bawah threshold 2,5 V), serta sensor api mendeteksi nyala api mulai jarak 246 cm. IC 74HC4078 sebagai gerbang NOR pengkondisi sinyal menghasilkan keluaran yang sepenuhnya sesuai dengan tabel kebenaran NOR tiga input, sehingga logika penggabungan sinyal sensor terverifikasi benar. Rangkaian penerima inframerah pada helm dan rompi mampu menerima sinyal IR pada jarak efektif hingga 200 meter pada malam hari, dengan cakupan sudut mencapai 45° tanpa lensa dan 180° saat menggunakan lensa Fresnel. Sistem Anti-Cheating berbasis empat sensor dengan gerbang NOR 4-input (IC 74HC4078) terbukti berfungsi: output bernilai HIGH (tidak curang) hanya ketika seluruh sensor dalam kondisi tidak terhalang, dan bernilai LOW (cheat terdeteksi) apabila salah satu atau lebih sensor tertutup, sesuai dengan 16 kombinasi tabel kebenaran yang diuji.

Pada pengujian protokol ESP-NOW antara ESP32-S3 Supermini (Helm) dan Heltec Tracker V1.2 (Rompi) pada jarak 4 meter dengan penghalang dinding dan kardus menunjukkan tingkat keberhasilan pengiriman data sebesar 100%, dengan seluruh 10 paket pesan diterima tanpa error. Nilai RSSI tercatat pada rentang –91 dBm hingga –95 dBm, menandakan sinyal dalam kondisi lemah namun masih andal untuk komunikasi jarak dekat antar unit pemain. Pengujian LoRaWAN menggunakan metode OTAA pada jaringan The Things Network (TTN) menunjukkan keberhasilan transmisi data uplink sebesar 100% dengan latensi rata-rata 3–5 detik per event, membuktikan kemampuan LoRa sebagai jalur komunikasi jarak jauh yang efisien dan bertenaga rendah. Arsitektur komunikasi dua lapis—ESP-NOW untuk interaksi cepat antar pemain dalam jarak dekat dan LoRa untuk pengiriman data ke server pusat—terbukti saling melengkapi dan berjalan secara paralel tanpa konflik

Modul GPS pada Heltec Wireless Tracker V1.2 berhasil mengunci posisi dengan akurasi tinggi, mencatat koordinat dengan variasi ±0,000002° dan jumlah satelit antara 10 hingga 22 satelit. Data GPS, status IR, dan parameter LoRa dikirimkan melalui jalur GPRS (SIM900A, APN: indosatgprs) ke ThingSpeak channel 3268510 dengan latensi 13–24 detik, kemudian diteruskan secara otomatis ke endpoint Vercel (/api/track) melalui mekanisme ThingHTTP. Pada pengujian sistem secara keseluruhan dengan skenario dua pemain saling menembak pada jarak 60 meter, diperoleh hit rate sebesar 80% (8 dari 10 tembakan berhasil mengenai target) dengan seluruh event tercatat akurat di server beserta data koordinat, waktu, status IR, status anti-cheat, RSSI, dan SNR. Tidak ditemukan event cheat selama pengujian berlangsung. Hasil ini membuktikan bahwa hipotesis proyek akhir terpenuhi: kombinasi ESP-NOW dan LoRa mampu menghasilkan sistem Laser Tag yang akurat, responsif, dan dapat dipantau secara real-time melalui antarmuka web dalam skenario arena permainan nyata.

## 5.2 Saran

1. Pembaruan model regulator yang sesuai dengan kebutuhan SAT, Helm dan Rompi
2. Pengembangan jarak deteksi sensor inframerah

Untuk medan latihan yang lebih luas, diperlukan penggunaan sensor atau lensa yang lebih sensitif agar jarak deteksi bisa diperpanjang lebih dari 200 meter

3. Uji Coba Lapangan dan Kondisi Ekstrem:

Disarankan pengujian sistem secara berkelanjutan di berbagai kondisi lingkungan, seperti saat hujan, panas, maupun kabut, guna memastikan keandalan pancaran dan penerimaan sinyal IR pada simulasi permainan sesungguhnya.

4. Optimalisasi Konsumsi Daya dan Efisiensi Driver:

Agar waktu operasional alat semakin optimal, riset tambahan terkait efisiensi rangkaian Driver LED dan manajemen energi pada baterai perlu dilakukan, misalnya melalui seleksi komponen dengan konsumsi daya rendah atau penggunaan algoritma sleep mode pada mikrokontroler.

5. Pengembangan Antarmuka Sistem:

Pengembangan fitur antarmuka (misal melalui aplikasi mobile atau dashboard berbasis web) sebaiknya terus dikembangkan agar lebih intuitif dan responsif

# DAFTAR PUSTAKA

Adelantado, F., Vilajosana, X., Tuset-Peiro, P., Martinez, B., Melia-Segui, J., & Watteyne, T. (2017). Understanding the Limits of LoRaWAN. IEEE Communications Magazine, 55(9), 34–40. https://doi.org/10.1109/MCOM.2017.1600613

Adolfo, V., & Setia Budi, A. (2023). Perancangan Sistem Deteksi Node Baru Otomatis dalam Basis ESP-NOW dengan Tree Topology WSN. Jurnal Pengembangan Teknologi Informasi Dan Ilmu Komputer, 7(5), 2475–2480. http://j-ptiik.ub.ac.id

Alliance, L. (2023). About LoRaWAN® - LoRa Alliance®. Https://LoRa-Alliance.Org/about-LoRawan/. https://LoRa-alliance.org/about-LoRawan/

Ariffin, A. A. Bin, Aziz, N. H. A., & Othman, K. A. (2011). Implementation of GPS for Location Tracking. In IEEE Control and System Graduate Research Colloquium. IEEE.

Augustin, A., Yi, J., Clausen, T., & Townsley, W. M. (2016). A study of LoRa: Long range & low power networks for the internet of things. Sensors (Switzerland), 16(9). https://doi.org/10.3390/s16091466

Automation, H. (2021). Heltec Products Operation Documention. Https://Docs.Heltec.Org/?Spm=a2ty_o01.29997173.0.0.16715171k9VBi2. https://docs.heltec.org/?spm=a2ty_o01.29997173.0.0.16715171k9VBi2

Board.dev, E. (2025). ESP32-S3 Super Mini. Https://Www.Espboards.Dev/Esp32/Esp32-S3-Super-Mini/. https://www.espboards.dev/esp32/esp32-s3-super-mini/

Deepika, K., & Renuka Prasad, B. (2023). IoT-Based Dashboards for Monitoring Connected Farms Using Free Software and Open Protocols (pp. 529–543). https://doi.org/10.1007/978-981-19-6004-8_43

Fajar Arofah, M., Mandayatma, E., & Nurcahyo, S. (2023). Penerapan Protokol Komunikasi ESP-NOW pada Portable Traffic Light. Jurnal Elektronika Dan Otomasi Industri, 10(1), 52–59. https://doi.org/10.33795/elkolind.v10i1.2749

Gromes, J. (2025). Universal wireless communication library for embedded devices. Https://Github.Com/Jgromes/RadioLib. https://github.com/jgromes/RadioLib

Gromes, J., Daniel, V., Svoboda, P., Tremouillhe, O., Kubik, M., Jon, J., & Stejskal, M. (2025). Scalable small satellite platform for earth observation and scientific missions. Journal of Physics: Conference Series, 3078(1). https://doi.org/10.1088/1742-6596/3078/1/012067

Guerbaoui, M., El Faiz, S., Ed-Dahhak, A., Lachhab, A., Benhala, B., Bakziz, Z., Ichou, I., & Selmani, A. (2025). From Data to Decisions: A Smart IoT and Cloud Approach to Environmental Monitoring. E3S Web of Conferences, 601. https://doi.org/10.1051/e3sconf/202560100008

Hailan, M. A., Ghazaly, N. M., & Albaker, B. M. (2024). ESPNOW Protocol-Based IIoT System for Remotely Monitoring and Controlling Industrial Systems. Journal of Robotics and Control (JRC), 5(6), 1924–1942. https://doi.org/10.18196/jrc.v5i6.21925

Instrument, L. (2021). Push-Pull Output In Encoder: The Defination And Characteristics É É Menu Menu. Https://Lorentzzi.Com/about-Us/. https://lorentzzi.com/push-pull-output-in-encoder-the-defination-and-characteristics/

Itera. (2021). BAB II LANDASAN TEORI II.1 Global Navigation Satellite System (GNSS).

Kahn, J. M., & Barry, J. R. (1997). Wireless Infrared Communications. IEEE, 85, 265–298.

Konate, S., Li, C., Pranolo, A., & Traore, M. (2025). Modeling LoRa Backscatter Communication Range. Global Journal of Computer Science and Technology: G Interdisciplinary, 25(1).

Lesmana, B., Heryana, G., & Jatira. (2023). Perancangan Sistem Kendali Mesin CNC (Computer Numerical Control) laser Cutting CO2 2 Axis Berbasis Arduino Uno. Journal of Applied Mechanical Technology, 2(2), 28–33. https://doi.org/10.31884/jamet.v2i2.43

Munandar, A., David Maria Veronika, N., Abdulllah, D., & Sahputra, E. (2023). Miniature Design of Liquid Filling Machine Automatically Using ESP32 Based IOT (Internet of Things) Perancangan Miniatur Mesin Pengisi Cairan Otomatis Menggunakan ESP32 Berbasis IOT (Internet of Things). JURNAL KOMITEK, 3(1), 69–78. https://doi.org/10.53697/jkomitek.v3i1

Nicola, C. I., Nicola, M., Sacerdoțianu, D., & Pătru, I. (2024). Real-time Monitoring of Cable Sag and Overhead Line Parameters Based on a Distributed Sensor Network and Implementation in a Web server and IoT. https://doi.org/10.20944/preprints202405.1414.v1

Nihayatus Sa’adah, Aries Pratiarso, Faridatun Nadziroh, Nailul Muna, Karimatun Nisa’, I Gede Puja Astawa, Tri Budi Santoso, & Sultan Syahputra Yulianto. (2024). Analisa Performansi Komunikasi LoRa (Long Range) pada Sistem Monitoring Buoy di Laut. The Indonesian Journal of Computer Science, 13(6). https://doi.org/10.33022/ijcs.v13i6.4462

Nugraha, A. I., & Rosita, Y. D. (2024). Web-Based Integration of IoT and Artificial Intelligence for Monitoring Aquariums. MATICS: Jurnal Ilmu Komputer Dan Teknologi Informasi (Journal of Computer Science and Information Technology), 16(1), 7–12. https://doi.org/10.18860/mat.v16i1.23471

Parveen, Z., & Aldhlan, K. A. (2016). Missing Pilgrims Tracking System Using GPS, GSM and Arduino Microcontroller. In International Conference on Recent Advances in Computer Systems.

Pratama, E. W., & Kiswantono, A. (2023). Electrical Analysis Using ESP-32 Module In Realtime. JEECS (Journal of Electrical Engineering and Computer Sciences), 7(2), 1273–1284. https://doi.org/10.54732/jeecs.v7i2.21

Prettz, J. B., Da Costa, J. P. C. L., Alvim, J. R., Miranda, R. K., & Zanatta, M. R. (2017). Efficient and low cost MIMO communication architecture for smartbands applied to postoperative patient care. RPC 2017 - Proceedings of the 2nd Russian-Pacific Conference on Computer Technology and Applications, 2017-December, 1–5. https://doi.org/10.1109/RPC.2017.8168055

Project Zephyr. (2025, November 17). Wireless Tracker (V1.1) — Zephyr Project Documentation. Https://Docs.Zephyrproject.Org/Latest/Boards/Heltec/Heltec_wireless_tracker/Doc/Index.Html.

Satheesh, M. B., Senthilkumar, B., Veeramanikandasamy, T., & Saravanakumar, O. M. (2016). Microcontroller and SD Card Based Standalone Data Logging System using SPI and I2C Protocols for Industrial Application. International Journal of Advanced Research in Electrical, Electronics and Instrumentation Engineering (An ISO, 5(4), 2208–2214. https://doi.org/10.15662/IJAREEIE.2016.0504002

Siradjuddin, I., Nurwicaksana, W. A., Riskitasari, S., Al Azhar, G., Rahman Hidayat, A., & Wicaksono, R. P. (2024). An Infrared Emitter Driver Circuit of SAT for MILES Application. In Journal of Evrimata: Engineering and Physics (Vol. 02, Number 02).

Sunil Fulzele, V., & Athawale, S. V. (2024). IJIRID International Journal of Ingenious Research, Invention and Development GPS Technology: A Review, Architecture, and Working. International Journal of Ingenious Research, Invention and Development, 3, 543–549. https://doi.org/10.5281/zenodo.14230440

Texas, I. (1976). µA7800 SERIES POSITIVE-VOLTAGE REGULATORS. www.ti.com/sc/package.

Toyib, R., Bustami, I., Abdullah, D., & Onsardi, O. (2019). Penggunaan Sensor Passive Infrared Receiver (PIR) Untuk Mendeteksi Gerak Berbasis Short Message Service Gateway. Pseudocode, 6(2). https://doi.org/10.33369/pseudocode.6.2.114-124

Urazayev, D., Eduard, A., Ahsan, M., & Zorbas, D. (2023). Indoor Performance Evaluation of ESP-NOW. https://github.com/espressif/ESP-NOW

Vishay Semiconductors. (2025). IR Receiver Modules for Remote Control Systems. In www.vishay.com. www.vishay.com

Winternitz, L. M. B., Bamford, W. A., & Heckler, G. W. (2009). A GPS receiver for high-altitude satellite navigation. IEEE Journal on Selected Topics in Signal Processing, 3(4), 541–556. https://doi.org/10.1109/JSTSP.2009.2023352

Yahya, M. S., Soeung, S., Chinda, F. E., Musa, U., & Yunusa, Z. (2024). Dual-band GPS/LoRa antenna for internet of thing applications. Bulletin of Electrical Engineering and Informatics, 13(2), 986–995. https://doi.org/10.11591/eei.v13i2.6428

Yanziah, A., Sopian, S., & Rose, M. M. (2020). ANALISIS JARAK JANGKAUAN LORA DENGAN PARAMETER RSSI DAN PACKET LOSS PADA AREA URBAN. JURNAL TEKNOLOGI TECHNOSCIENTIA, 13, 59–67.

Yunardi, R. T. (2017). Analisa Kinerja Sensor Inframerah dan Ultrasonik untuk Sistem Pengukuran Jarak pada Mobile Robot Inspection. Setrum : Sistem Kendali-Tenaga-Elektronika-Telekomunikasi-Komputer, 6(1), 33. https://doi.org/10.36055/setrum.v6i1.1583

Zade, Prof. M. N., Nikose, Prof. M. D., & Aerkewar, Prof. P. N. (2012). Wireless Infrared Communications :A Survey. International Journal of Engineering Research & Technology (IJERT), 1(3), 1–8. www.ijert.org

# LAMPIRAN

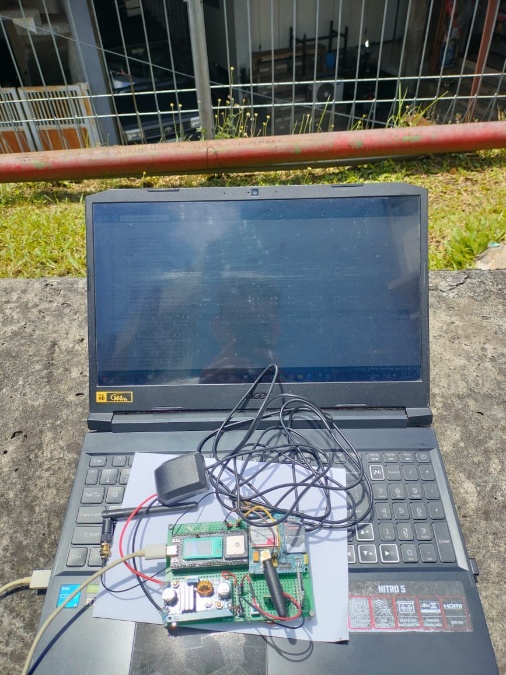
[picture p32: figure]
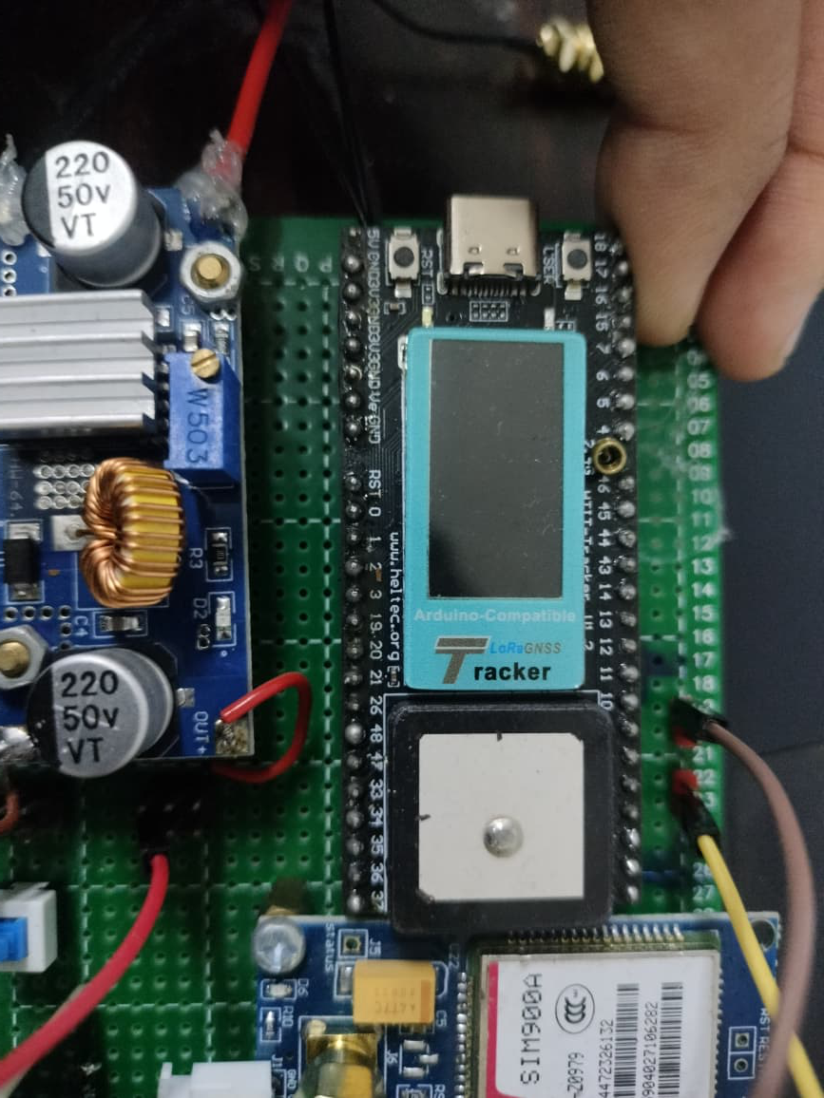
[picture p33: figure]

Gambar Lampiran 1 Proses dan pengambilan data GPS, GPRS dan SDCard | Gambar Lampiran 2 proses peracangan Electrical Rompi

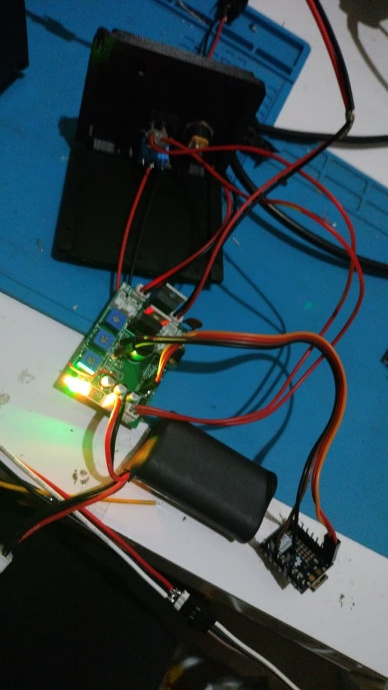
[picture p34: figure]
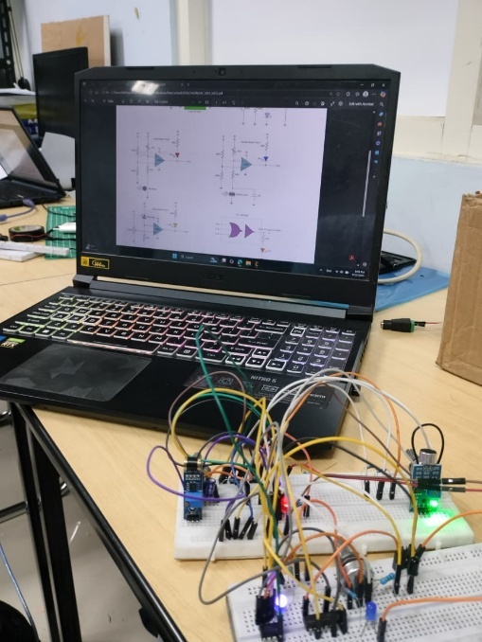
[picture p35: figure]

Gambar Lampiran 3 proses pengambilan data sensor dan pengukuran tegangan | Gambar Lampiran 4 Proses peracangan electrical SAT

1. Program SAT (Senjata)

// ============================================================

// WEAPON — Single-file sketch (merged from Weapon.ino,

// Config.h, and ConfigHelper.h)

//

// Ganti komentar di bawah sesuai pemain:

// #define PLAYER_1 ← aktifkan untuk Pemain 1

// #define PLAYER_2 ← aktifkan untuk Pemain 2

// ============================================================

#include <Arduino.h>

#include <IRremote.hpp>

#include <stdint.h>

// ------------------------------------------------------------

// Pilih pemain (aktifkan salah satu, sisanya di-comment)

// ------------------------------------------------------------

#define PLAYER_1

// #define PLAYER_2

// ------------------------------------------------------------

// ConfigHelper — alamat perangkat & MAC address per pemain

// ------------------------------------------------------------

#if defined(PLAYER_1)

#define DEVICE_ADDRESS 0x0001

static const uint8_t HELPER_HELMET_MAC[] = { 0x50, 0x78, 0x7D, 0x1A, 0x36, 0x24 };

static const uint8_t HELPER_VEST_MAC[] = { 0x10, 0x20, 0xBA, 0x65, 0x47, 0x34 };

#elif defined(PLAYER_2)

#define DEVICE_ADDRESS 0x0002

static const uint8_t HELPER_HELMET_MAC[] = { 0x24, 0x58, 0x7C, 0xDB, 0x2D, 0xA8 };

static const uint8_t HELPER_VEST_MAC[] = { 0x10, 0x51, 0xDB, 0x58, 0x77, 0xA0 };

#else

#error "Define PLAYER_1 atau PLAYER_2 di atas sebelum compile."

#endif

// ------------------------------------------------------------

// Config — pin, baud rate, dan parameter senjata

// ------------------------------------------------------------

#define WEAPON_DEVICE_ID DEVICE_ADDRESS

#define WEAPON_SERIAL_BAUD 115200

#define WEAPON_IR_SEND_PIN 2

#define WEAPON_TRIGGER_BUTTON_PIN 5

#define WEAPON_STATUS_LED_PIN LED_BUILTIN

#define WEAPON_DEBOUNCE_MS 250

#define PLAYER_DEVICE_ID_MIN 0x0001

#define PLAYER_DEVICE_ID_MAX 0x00FF

#define WEAPON_IR_COMMAND 0x01

#define WEAPON_IR_REPEAT_COUNT 1

// ------------------------------------------------------------

// Weapon does not use ESP-NOW.

// ------------------------------------------------------------

// ------------------------------------------------------------

// State global

// ------------------------------------------------------------

bool g_triggerWasPressed = false;

unsigned long g_lastShotAtMs = 0;

// ------------------------------------------------------------

// Setup

// ------------------------------------------------------------

void setup() {

Serial.begin(WEAPON_SERIAL_BAUD);

unsigned long startedAt = millis();

while (!Serial && millis() - startedAt < 5000) delay(10);

pinMode(WEAPON_TRIGGER_BUTTON_PIN, INPUT_PULLUP);

pinMode(WEAPON_STATUS_LED_PIN, OUTPUT);

pinMode(WEAPON_IR_SEND_PIN, OUTPUT);

digitalWrite(WEAPON_STATUS_LED_PIN, LOW);

digitalWrite(WEAPON_IR_SEND_PIN, LOW);

IrSender.begin(WEAPON_IR_SEND_PIN);

Serial.println("Weapon ready");

Serial.printf("weaponDeviceId=0x%04X cmd=0x%02X\n", WEAPON_DEVICE_ID, WEAPON_IR_COMMAND);

}

// ------------------------------------------------------------

// Loop

// ------------------------------------------------------------

void loop() {

bool triggerPressedNow = digitalRead(WEAPON_TRIGGER_BUTTON_PIN) == LOW;

unsigned long nowMs = millis();

if (triggerPressedNow && !g_triggerWasPressed &&

nowMs - g_lastShotAtMs >= WEAPON_DEBOUNCE_MS) {

g_lastShotAtMs = nowMs;

digitalWrite(WEAPON_STATUS_LED_PIN, HIGH);

IrSender.sendNEC(WEAPON_DEVICE_ID, WEAPON_IR_COMMAND, WEAPON_IR_REPEAT_COUNT);

delay(120);

digitalWrite(WEAPON_STATUS_LED_PIN, LOW);

digitalWrite(WEAPON_IR_SEND_PIN, LOW);

Serial.printf("FIRE addr=0x%04X cmd=0x%02X\n", WEAPON_DEVICE_ID, WEAPON_IR_COMMAND);

}

g_triggerWasPressed = triggerPressedNow;

delay(20);

}

2. Program Helmet

// ============================================================

// HELMET — Single-file sketch (merged dari Helmet.ino,

// Now.ino, Config.h, dan ConfigHelper.h)

//

// Ganti komentar di bawah sesuai pemain:

// #define PLAYER_1 ← aktifkan untuk Pemain 1

// #define PLAYER_2 ← aktifkan untuk Pemain 2

//

// Untuk mengaktifkan fitur Anti-Cheat, hapus tanda komentar:

// #define ENABLE_ANTI_CHEAT

// ============================================================

#include <Arduino.h>

#include <IRremote.hpp>

#include <Wi-Fi.h>

#include <esp_now.h>

#include <esp_Wi-Fi.h>

#include <stdint.h>

// ------------------------------------------------------------

// Pilih pemain (aktifkan salah satu, sisanya di-comment)

// ------------------------------------------------------------

#define PLAYER_1

// #define PLAYER_2

// ------------------------------------------------------------

// ConfigHelper — alamat perangkat & MAC address per pemain

// ------------------------------------------------------------

#if defined(PLAYER_1)

#define DEVICE_ADDRESS 0x0001

static const uint8_t HELPER_HELMET_MAC[] = { 0x50, 0x78, 0x7D, 0x1A, 0x36, 0x24 };

static const uint8_t HELPER_VEST_MAC[] = { 0x10, 0x20, 0xBA, 0x65, 0x47, 0x34 };

#elif defined(PLAYER_2)

#define DEVICE_ADDRESS 0x0002

static const uint8_t HELPER_HELMET_MAC[] = { 0x24, 0x58, 0x7C, 0xDB, 0x2D, 0xA8 };

static const uint8_t HELPER_VEST_MAC[] = { 0x10, 0x51, 0xDB, 0x58, 0x77, 0xA0 };

#else

#error "Define PLAYER_1 atau PLAYER_2 di atas sebelum compile."

#endif

// ------------------------------------------------------------

// Config — pin, baud rate, dan parameter helmet

// ------------------------------------------------------------

#define HELMET_DEVICE_ID DEVICE_ADDRESS

#define HELMET_SERIAL_BAUD 115200

#define IR_EASY_MODE

#define HELMET_IR_RECEIVE_PIN 4

#define HELMET_ANTI_CHEAT_SENSOR_PIN 5

#define HELMET_STATUS_LED_PIN LED_BUILTIN

// #define ENABLE_ANTI_CHEAT

#define HELMET_ESPNOW_CHANNEL 1

#define HELMET_CHEAT_DETECTION_MS 5000

#define HELMET_CHEAT_CHECK_MS 100

#define HELMET_CHEAT_COOLDOWN_MS 10000UL

#define PLAYER_DEVICE_ID_MIN 0x0001

#define PLAYER_DEVICE_ID_MAX 0x00FF

#define WEAPON_IR_COMMAND 0x01

#define HIT_PACKET_TYPE_HIT 0x01

#define PACKET_TYPE_STATUS 0x03

#define HIT_PART_VEST 0

#define HIT_PART_HEAD 1

#define VEST_NODE_MAC_ADDRESS HELPER_VEST_MAC

// ------------------------------------------------------------

// Struct paket

// ------------------------------------------------------------

struct __attribute__((packed)) HitPacket {

uint8_t packetType;

uint16_t senderDeviceId;

uint16_t shooterDeviceId;

uint8_t hitPart;

uint32_t deviceTime;

};

struct __attribute__((packed)) StatusPacket {

uint8_t packetType;

uint16_t senderDeviceId;

uint8_t cheatDetected;

};

// ------------------------------------------------------------

// State global

// ------------------------------------------------------------

volatile bool g_ESPNOWSendDone = false;

volatile bool g_ESPNOWSendOk = false;

volatile bool g_cheatDetected = false;

unsigned long g_lastStatusSendAtMs = 0;

unsigned long g_cheatClearAtMs = 0;

TaskHandle_t g_antiCheatTaskHandle = nullptr;

// ------------------------------------------------------------

// Forward declarations

// ------------------------------------------------------------

void setupESPNOW();

void onDataSent(const esp_now_send_info_t *info, esp_now_send_status_t status);

bool sendHit(const HitPacket &hitPacket);

bool sendStatus(const StatusPacket &statusPacket);

void taskAntiCheat(void *pvParameters);

// ============================================================

// Setup

// ============================================================

void setup() {

Serial.begin(HELMET_SERIAL_BAUD);

unsigned long startedAt = millis();

while (!Serial && millis() - startedAt < 5000) delay(10);

pinMode(HELMET_ANTI_CHEAT_SENSOR_PIN, INPUT);

pinMode(HELMET_STATUS_LED_PIN, OUTPUT);

digitalWrite(HELMET_STATUS_LED_PIN, LOW);

IrReceiver.begin(HELMET_IR_RECEIVE_PIN, false);

setupESPNOW();

Serial.printf("Helmet ready id=0x%04X\n", HELMET_DEVICE_ID);

#ifdef ENABLE_ANTI_CHEAT

xTaskCreate(taskAntiCheat, "HelmetCheat", 2048, NULL, 1, &g_antiCheatTaskHandle);

#endif

}

// ============================================================

// Loop

// ============================================================

void loop() {

const unsigned long nowMs = millis();

#ifdef ENABLE_ANTI_CHEAT

if (nowMs - g_lastStatusSendAtMs >= 1000UL) {

StatusPacket statusPacket = {};

statusPacket.packetType = PACKET_TYPE_STATUS;

statusPacket.senderDeviceId = HELMET_DEVICE_ID;

statusPacket.cheatDetected = g_cheatDetected ? 1 : 0;

sendStatus(statusPacket);

g_lastStatusSendAtMs = nowMs;

}

#endif

if (IrReceiver.decode()) {

if (IrReceiver.decodedIRData.protocol == NEC) {

#ifndef IR_EASY_MODE

#ifdef ENABLE_ANTI_CHEAT

if (g_cheatDetected) {

Serial.println("IGNORE hit: anti-cheat active");

IrReceiver.resume();

delay(10);

return;

}

#endif

if (IrReceiver.decodedIRData.address == HELMET_DEVICE_ID) {

Serial.printf("IGNORE self-hit shooter=0x%04X\n", HELMET_DEVICE_ID);

IrReceiver.resume();

delay(10);

return;

}

if (IrReceiver.decodedIRData.command != WEAPON_IR_COMMAND) {

Serial.printf("IGNORE non-weapon command=0x%02X\n", IrReceiver.decodedIRData.command);

IrReceiver.resume();

delay(10);

return;

}

if (IrReceiver.decodedIRData.address < PLAYER_DEVICE_ID_MIN ||

IrReceiver.decodedIRData.address > PLAYER_DEVICE_ID_MAX) {

Serial.printf("IGNORE out-of-range shooter=0x%04X\n", IrReceiver.decodedIRData.address);

IrReceiver.resume();

delay(10);

return;

}

#endif // IR_EASY_MODE

HitPacket hitPacket = {};

hitPacket.packetType = HIT_PACKET_TYPE_HIT;

hitPacket.senderDeviceId = HELMET_DEVICE_ID;

hitPacket.shooterDeviceId = IrReceiver.decodedIRData.address;

hitPacket.hitPart = HIT_PART_HEAD;

hitPacket.deviceTime = millis();

digitalWrite(HELMET_STATUS_LED_PIN, HIGH);

bool sendOk = sendHit(hitPacket);

digitalWrite(HELMET_STATUS_LED_PIN, LOW);

Serial.printf(

"HEAD HIT shooter=0x%04X send=%s\n",

hitPacket.shooterDeviceId,

sendOk ? "OK" : "FAIL");

}

IrReceiver.resume();

}

delay(10);

}

// ============================================================

// Anti-cheat task (FreeRTOS)

// ============================================================

void taskAntiCheat(void *pvParameters) {

unsigned long coverStartedAtMs = 0;

bool sensorCovered = false;

(void)pvParameters;

for (;;) {

const unsigned long nowMs = millis();

bool sensorCoveredNow = digitalRead(HELMET_ANTI_CHEAT_SENSOR_PIN) == LOW;

if (sensorCoveredNow) {

if (!sensorCovered) {

sensorCovered = true;

coverStartedAtMs = nowMs;

}

if (!g_cheatDetected && nowMs - coverStartedAtMs >= HELMET_CHEAT_DETECTION_MS) {

g_cheatDetected = true;

g_cheatClearAtMs = nowMs + HELMET_CHEAT_COOLDOWN_MS;

}

if (g_cheatDetected) {

g_cheatClearAtMs = nowMs + HELMET_CHEAT_COOLDOWN_MS;

}

} else {

sensorCovered = false;

if (g_cheatDetected && g_cheatClearAtMs != 0 && nowMs >= g_cheatClearAtMs) {

g_cheatDetected = false;

g_cheatClearAtMs = 0;

}

}

vTaskDelay(pdMS_TO_TICKS(HELMET_CHEAT_CHECK_MS));

}

}

// ============================================================

// ESP-NOW — setup & callbacks

// ============================================================

void setupESPNOW() {

Wi-Fi.mode(WI-FI_STA);

Wi-Fi.disconnect();

Wi-Fi.setSleep(false);

esp_Wi-Fi_set_channel(HELMET_ESPNOW_CHANNEL, WI-FI_SECOND_CHAN_NONE);

if (esp_now_init() != ESP_OK) {

Serial.println("ESP-NOW init failed");

while (true) delay(10);

}

esp_now_register_send_cb(onDataSent);

esp_now_peer_info_t peerInfo = {};

memcpy(peerInfo.peer_addr, VEST_NODE_MAC_ADDRESS, 6);

peerInfo.channel = HELMET_ESPNOW_CHANNEL;

peerInfo.encrypt = false;

if (esp_now_add_peer(&peerInfo) != ESP_OK) {

Serial.println("ESP-NOW peer add failed");

while (true) delay(10);

}

}

void onDataSent(const esp_now_send_info_t *info, esp_now_send_status_t status) {

(void)info;

g_ESPNOWSendDone = true;

g_ESPNOWSendOk = (status == ESP_NOW_SEND_SUCCESS);

}

// ============================================================

// ESP-NOW — kirim paket

// ============================================================

bool sendHit(const HitPacket &hitPacket) {

g_ESPNOWSendDone = false;

g_ESPNOWSendOk = false;

esp_err_t sendResult = esp_now_send(

VEST_NODE_MAC_ADDRESS,

reinterpret_cast<const uint8_t *>(&hitPacket),

sizeof(hitPacket));

if (sendResult != ESP_OK) return false;

unsigned long waitStartedAtMs = millis();

while (!g_ESPNOWSendDone && millis() - waitStartedAtMs < 500) delay(10);

return g_ESPNOWSendDone && g_ESPNOWSendOk;

}

bool sendStatus(const StatusPacket &statusPacket) {

g_ESPNOWSendDone = false;

g_ESPNOWSendOk = false;

esp_err_t sendResult = esp_now_send(

VEST_NODE_MAC_ADDRESS,

reinterpret_cast<const uint8_t *>(&statusPacket),

sizeof(statusPacket));

if (sendResult != ESP_OK) return false;

unsigned long waitStartedAtMs = millis();

while (!g_ESPNOWSendDone && millis() - waitStartedAtMs < 500) delay(10);

return g_ESPNOWSendDone && g_ESPNOWSendOk;

}

3. Program Rompi (Vest)

// ============================================================

// VEST NODE — Single-file sketch

// Merged dari: VestNode.ino, Now.ino, Display.ino, GPS.ino,

// SdCard.ino, Simulation.ino, Config.h, ConfigHelper.h

//

// Ganti komentar di bawah sesuai pemain:

// #define PLAYER_1 ← aktifkan untuk Pemain 1

// #define PLAYER_2 ← aktifkan untuk Pemain 2

//

// Opsi tambahan (hapus '//' untuk mengaktifkan):

// #define VEST_NODE_SIMULATION_MODE ← mode simulasi via Serial

// #define ENABLE_ANTI_CHEAT ← aktifkan sensor anti-cheat

// ============================================================

#include <Arduino.h>

#include <SPI.h>

#include <SD.h>

#include <Adafruit_GFX.h>

#include <Adafruit_ST7735.h>

#include <IRremote.hpp>

#include <RadioLib.h>

#include <TinyGPS++.h>

#include <Wi-Fi.h>

#include <esp_now.h>

#include <esp_Wi-Fi.h>

#include <stdint.h>

// ============================================================

// Pilih pemain (aktifkan salah satu)

// ============================================================

#define PLAYER_1

// #define PLAYER_2

// ============================================================

// ConfigHelper — alamat & MAC address per pemain

// ============================================================

#if defined(PLAYER_1)

#define DEVICE_ADDRESS 0x0001

static const uint8_t HELPER_HELMET_MAC[] = { 0x50, 0x78, 0x7D, 0x1A, 0x36, 0x24 };

static const uint8_t HELPER_VEST_MAC[] = { 0x10, 0x20, 0xBA, 0x65, 0x47, 0x34 };

#elif defined(PLAYER_2)

#define DEVICE_ADDRESS 0x0002

static const uint8_t HELPER_HELMET_MAC[] = { 0x24, 0x58, 0x7C, 0xDB, 0x2D, 0xA8 };

static const uint8_t HELPER_VEST_MAC[] = { 0x10, 0x51, 0xDB, 0x58, 0x77, 0xA0 };

#else

#error "Define PLAYER_1 atau PLAYER_2 di atas sebelum compile."

#endif

// ============================================================

// Config — semua define dan struct

// ============================================================

#define VEST_NODE_DEVICE_ID DEVICE_ADDRESS

#define VEST_NODE_SERIAL_BAUD 115200

#define IR_EASY_MODE

#define POLINEMA_CENTER_LAT_E7 -79462000L

#define POLINEMA_CENTER_LNG_E7 1126156000L

// #define VEST_NODE_SIMULATION_MODE

// #define ENABLE_ANTI_CHEAT

#define VEST_NODE_IR_RECEIVE_PIN 5

#define VEST_NODE_ANTI_CHEAT_SENSOR_PIN 2

#define VEST_NODE_POWER_ENABLE_PIN 3

#define VEST_NODE_BACKLIGHT_PIN 21

#define VEST_NODE_STATUS_LED_PIN 18

#define VEST_NODE_DISPLAY_CS_PIN 38

#define VEST_NODE_DISPLAY_DC_PIN 40

#define VEST_NODE_DISPLAY_RST_PIN 39

#define VEST_NODE_DISPLAY_SCLK_PIN 41

#define VEST_NODE_DISPLAY_MOSI_PIN 42

#define VEST_NODE_LORA_SCLK_PIN 9

#define VEST_NODE_LORA_MISO_PIN 11

#define VEST_NODE_LORA_MOSI_PIN 10

#define VEST_NODE_LORA_CS_PIN 8

#define VEST_NODE_LORA_RST_PIN 12

#define VEST_NODE_LORA_DIO1_PIN 14

#define VEST_NODE_LORA_BUSY_PIN 13

#define VEST_NODE_SD_CS_PIN 4

#define VEST_NODE_LORA_FREQUENCY 915.0f

#define VEST_NODE_LORA_BANDWIDTH 125.0f

#define VEST_NODE_LORA_SPREADING_FACTOR 7

#define VEST_NODE_LORA_CODING_RATE 5

#define VEST_NODE_LORA_SYNC_WORD 0x12

#define VEST_NODE_LORA_OUTPUT_POWER 22

#define VEST_NODE_LORA_PREAMBLE_LENGTH 8

#define VEST_NODE_ESPNOW_CHANNEL 1

#define VEST_NODE_CHEAT_DETECTION_MS 5000

#define VEST_NODE_CHEAT_CHECK_MS 100

#define VEST_NODE_CHEAT_COOLDOWN_MS 10000UL

#define VEST_NODE_DISPLAY_REFRESH_MS 200

#define VEST_NODE_GPS_RX_PIN 33

#define VEST_NODE_GPS_TX_PIN 34

#define VEST_NODE_GPS_BAUD 115200

#define VEST_NODE_GPS_SEND_INTERVAL_MS 10000UL

#define VEST_NODE_SIM_RADIUS_MIN_METERS 500L

#define VEST_NODE_SIM_RADIUS_MAX_METERS 1000L

#define VEST_NODE_SD_SHOW_DEFAULT_BYTES 200U

#define VEST_NODE_INITIAL_HP 100

#define VEST_NODE_HIT_DAMAGE_VEST 50

#define VEST_NODE_HIT_DAMAGE_HEAD 100

#define PLAYER_DEVICE_ID_MIN 0x0001

#define PLAYER_DEVICE_ID_MAX 0x00FF

#define WEAPON_IR_COMMAND 0x01

#define VEST_NODE_SD_HIT_FILE "/simpera_hits.csv"

#define VEST_NODE_SD_GPS_FILE "/simpera_gps.csv"

#define DISPLAY_WIDTH 160

#define DISPLAY_HEIGHT 80

#define HIT_PACKET_TYPE_HIT 0x01

#define PACKET_TYPE_STATUS 0x03

#define LORA_PACKET_TYPE_HIT 0x01

#define LORA_PACKET_TYPE_GPS 0x02

#define HIT_PART_VEST 0

#define HIT_PART_HEAD 1

#define HELMET_NODE_MAC_ADDRESS HELPER_HELMET_MAC

// ---- Struct paket ----

struct __attribute__((packed)) HitPacket {

uint8_t packetType;

uint16_t senderDeviceId;

uint16_t shooterDeviceId;

uint8_t hitPart;

uint32_t deviceTime;

};

struct __attribute__((packed)) StatusPacket {

uint8_t packetType;

uint16_t senderDeviceId;

uint8_t cheatDetected;

};

struct GpsData {

int32_t latitudeE7;

int32_t longitudeE7;

bool valid;

};

struct __attribute__((packed)) LoRaHitPacket {

uint8_t packetType;

uint16_t senderDeviceId;

uint16_t shooterDeviceId;

uint8_t hitPart;

int16_t hp;

uint16_t hitCount;

int32_t latitudeE7;

int32_t longitudeE7;

};

struct __attribute__((packed)) LoRaGpsPacket {

uint8_t packetType;

uint16_t senderDeviceId;

int16_t hp;

uint16_t hitCount;

uint8_t cheatDetected;

int32_t latitudeE7;

int32_t longitudeE7;

};

struct HitDisplayState {

uint16_t senderDeviceId;

uint16_t shooterDeviceId;

uint8_t hitPart;

uint32_t deviceTime;

uint32_t totalHits;

bool hasHit;

int32_t latitudeE7;

int32_t longitudeE7;

bool hasGps;

};

// ============================================================

// Objek global hardware

// ============================================================

Adafruit_ST7735 g_tftDisplay = Adafruit_ST7735(

VEST_NODE_DISPLAY_CS_PIN,

VEST_NODE_DISPLAY_DC_PIN,

VEST_NODE_DISPLAY_MOSI_PIN,

VEST_NODE_DISPLAY_SCLK_PIN,

VEST_NODE_DISPLAY_RST_PIN);

SX1262 g_LoRaRadio = new Module(

VEST_NODE_LORA_CS_PIN,

VEST_NODE_LORA_DIO1_PIN,

VEST_NODE_LORA_RST_PIN,

VEST_NODE_LORA_BUSY_PIN);

// ============================================================

// State global

// ============================================================

volatile bool g_cheatDetected = false;

volatile bool g_helmetCheatDetected = false;

volatile bool g_helmetLinkReceived = false;

volatile bool g_hasPendingESPNOWHit = false;

volatile HitDisplayState g_latestHit = {};

volatile HitPacket g_pendingESPNOWHit = {};

volatile GpsData g_gpsData = {};

volatile int16_t g_hp = VEST_NODE_INITIAL_HP;

volatile uint16_t g_hitCount = 0;

String g_simulationInputLine = "";

TinyGPSPlus g_tinyGps;

unsigned long g_lastGpsSendAt = 0;

bool g_simulationGpsRandomEnabled = false;

bool g_sdReady = false;

unsigned long g_cheatClearAtMs = 0;

TaskHandle_t g_antiCheatTaskHandle = nullptr;

TaskHandle_t g_displayTaskHandle = nullptr;

// ============================================================

// Forward declarations

// ============================================================

void setupESPNOW();

void onDataReceived(const esp_now_recv_info_t *info, const uint8_t *data, int len);

void initDisplay();

void drawStatus();

void drawFullMacRow(int y, const char *prefix, const uint8_t *mac);

void taskDisplay(void *pvParameters);

void initGps();

void updateGps();

void sendPeriodicGps();

void captureGpsSnapshot(GpsData &gpsData);

bool sendGpsViaLoRa();

bool sendHitViaLoRa(const HitPacket &hitPacket);

void initLoRa();

void initSdCard();

void writeHitToSd(const HitPacket &hitPacket, int16_t hp, uint16_t hitCount, int32_t latitudeE7, int32_t longitudeE7, bool hasGps);

void writeGpsToSd(uint16_t senderDeviceId, int16_t hp, uint16_t hitCount, int32_t latitudeE7, int32_t longitudeE7, bool hasGps);

void deleteAllSdFiles();

void printLastBytes(const char *path, size_t byteCount);

bool ensureSdCsvHeader(const char *path, const char *header);

void processHit(const HitPacket &hitPacket);

void taskAntiCheat(void *pvParameters);

void processSerialCommands();

void handleSimulationCommand(const String &commandLine);

void printSimulationHelp();

void simulateHit(uint8_t hitPart, uint16_t shooterDeviceId);

void setSimulationGps(int32_t latitudeE7, int32_t longitudeE7);

void setSimulationGpsRandom();

bool parseShooterDeviceId(const String &value, uint16_t &shooterDeviceId);

bool parseGpsCoordinateE7(const String &value, int32_t &coordinateE7);

bool parsePositiveSize(const String &value, size_t &byteCount);

// ============================================================

// Setup & Loop

// ============================================================

void setup() {

pinMode(VEST_NODE_POWER_ENABLE_PIN, OUTPUT);

pinMode(VEST_NODE_BACKLIGHT_PIN, OUTPUT);

pinMode(VEST_NODE_STATUS_LED_PIN, OUTPUT);

pinMode(VEST_NODE_ANTI_CHEAT_SENSOR_PIN, INPUT);

digitalWrite(VEST_NODE_POWER_ENABLE_PIN, HIGH);

digitalWrite(VEST_NODE_BACKLIGHT_PIN, HIGH);

digitalWrite(VEST_NODE_STATUS_LED_PIN, LOW);

Serial.begin(VEST_NODE_SERIAL_BAUD);

unsigned long startedAt = millis();

while (!Serial && millis() - startedAt < 5000) delay(10);

IrReceiver.begin(VEST_NODE_IR_RECEIVE_PIN, false);

initDisplay();

initLoRa();

initSdCard();

initGps();

setupESPNOW();

Serial.printf("Vest ready id=0x%04X\n", VEST_NODE_DEVICE_ID);

#if defined(ENABLE_ANTI_CHEAT) && !defined(VEST_NODE_SIMULATION_MODE)

xTaskCreate(taskAntiCheat, "VestCheat", 2048, NULL, 1, &g_antiCheatTaskHandle);

#endif

xTaskCreate(taskDisplay, "VestDisplay", 4096, NULL, 1, &g_displayTaskHandle);

}

void loop() {

updateGps();

sendPeriodicGps();

#ifdef VEST_NODE_SIMULATION_MODE

processSerialCommands();

#else

if (g_hasPendingESPNOWHit) {

HitPacket hitPacket = {};

hitPacket.packetType = g_pendingESPNOWHit.packetType;

hitPacket.senderDeviceId = g_pendingESPNOWHit.senderDeviceId;

hitPacket.shooterDeviceId = g_pendingESPNOWHit.shooterDeviceId;

hitPacket.hitPart = g_pendingESPNOWHit.hitPart;

hitPacket.deviceTime = g_pendingESPNOWHit.deviceTime;

g_hasPendingESPNOWHit = false;

processHit(hitPacket);

}

if (IrReceiver.decode()) {

if (IrReceiver.decodedIRData.protocol == NEC) {

#ifndef IR_EASY_MODE

#ifdef ENABLE_ANTI_CHEAT

if (g_cheatDetected) {

Serial.println("IGNORE hit: anti-cheat active");

IrReceiver.resume();

delay(10);

return;

}

#endif

if (IrReceiver.decodedIRData.address == VEST_NODE_DEVICE_ID) {

Serial.printf("IGNORE self-hit shooter=0x%04X\n", VEST_NODE_DEVICE_ID);

IrReceiver.resume();

delay(10);

return;

}

if (IrReceiver.decodedIRData.command != WEAPON_IR_COMMAND) {

Serial.printf("IGNORE non-weapon command=0x%02X\n", IrReceiver.decodedIRData.command);

IrReceiver.resume();

delay(10);

return;

}

if (IrReceiver.decodedIRData.address < PLAYER_DEVICE_ID_MIN ||

IrReceiver.decodedIRData.address > PLAYER_DEVICE_ID_MAX) {

Serial.printf("IGNORE out-of-range shooter=0x%04X\n", IrReceiver.decodedIRData.address);

IrReceiver.resume();

delay(10);

return;

}

#endif // IR_EASY_MODE

HitPacket hitPacket = {};

hitPacket.packetType = HIT_PACKET_TYPE_HIT;

hitPacket.senderDeviceId = VEST_NODE_DEVICE_ID;

hitPacket.shooterDeviceId = IrReceiver.decodedIRData.address;

hitPacket.hitPart = HIT_PART_VEST;

hitPacket.deviceTime = millis();

processHit(hitPacket);

}

IrReceiver.resume();

}

#endif // VEST_NODE_SIMULATION_MODE

delay(10);

}

// ============================================================

// Anti-cheat task

// ============================================================

void taskAntiCheat(void *pvParameters) {

unsigned long coverStartedAtMs = 0;

bool sensorCovered = false;

(void)pvParameters;

for (;;) {

const unsigned long nowMs = millis();

bool sensorCoveredNow = digitalRead(VEST_NODE_ANTI_CHEAT_SENSOR_PIN) == LOW;

if (sensorCoveredNow) {

if (!sensorCovered) {

sensorCovered = true;

coverStartedAtMs = nowMs;

}

if (!g_cheatDetected && nowMs - coverStartedAtMs >= VEST_NODE_CHEAT_DETECTION_MS) {

g_cheatDetected = true;

g_cheatClearAtMs = nowMs + VEST_NODE_CHEAT_COOLDOWN_MS;

}

if (g_cheatDetected) {

g_cheatClearAtMs = nowMs + VEST_NODE_CHEAT_COOLDOWN_MS;

}

} else {

sensorCovered = false;

if (g_cheatDetected && g_cheatClearAtMs != 0 && nowMs >= g_cheatClearAtMs) {

g_cheatDetected = false;

g_cheatClearAtMs = 0;

}

}

vTaskDelay(pdMS_TO_TICKS(VEST_NODE_CHEAT_CHECK_MS));

}

}

// ============================================================

// Process hit

// ============================================================

void processHit(const HitPacket &hitPacket) {

#ifdef ENABLE_ANTI_CHEAT

if (g_cheatDetected || g_helmetCheatDetected) {

Serial.println("HIT ignored: anti-cheat active");

return;

}

#endif

if (g_hp <= 0) {

Serial.println("HIT ignored: player is dead");

return;

}

const int32_t damage =

hitPacket.hitPart == HIT_PART_HEAD ? VEST_NODE_HIT_DAMAGE_HEAD : VEST_NODE_HIT_DAMAGE_VEST;

g_hp = static_cast<int16_t>(max(0L, static_cast<long>(g_hp) - damage));

g_hitCount += 1;

digitalWrite(VEST_NODE_STATUS_LED_PIN, HIGH);

g_latestHit.senderDeviceId = hitPacket.senderDeviceId;

g_latestHit.shooterDeviceId = hitPacket.shooterDeviceId;

g_latestHit.hitPart = hitPacket.hitPart;

g_latestHit.deviceTime = hitPacket.deviceTime;

g_latestHit.totalHits += 1;

g_latestHit.hasHit = true;

GpsData gpsSnapshot = {};

captureGpsSnapshot(gpsSnapshot);

g_latestHit.latitudeE7 = gpsSnapshot.latitudeE7;

g_latestHit.longitudeE7 = gpsSnapshot.longitudeE7;

g_latestHit.hasGps = gpsSnapshot.valid;

Serial.printf(

"HIT sender=0x%04X shooter=0x%04X part=%s hp=%d hits=%u time=%lu lat=%.6f lng=%.6f\n",

hitPacket.senderDeviceId,

hitPacket.shooterDeviceId,

hitPacket.hitPart == HIT_PART_HEAD ? "HEAD" : "VEST",

static_cast<int>(g_hp),

static_cast<unsigned>(g_hitCount),

static_cast<unsigned long>(hitPacket.deviceTime),

gpsSnapshot.valid ? gpsSnapshot.latitudeE7 / 10000000.0 : 0.0,

gpsSnapshot.valid ? gpsSnapshot.longitudeE7 / 10000000.0 : 0.0);

writeHitToSd(hitPacket, g_hp, g_hitCount, gpsSnapshot.latitudeE7, gpsSnapshot.longitudeE7, gpsSnapshot.valid);

sendHitViaLoRa(hitPacket);

delay(100);

digitalWrite(VEST_NODE_STATUS_LED_PIN, LOW);

}

// ============================================================

// ESP-NOW (Now.ino)

// ============================================================

void setupESPNOW() {

Wi-Fi.mode(WI-FI_STA);

Wi-Fi.disconnect();

Wi-Fi.setSleep(false);

esp_Wi-Fi_set_channel(VEST_NODE_ESPNOW_CHANNEL, WI-FI_SECOND_CHAN_NONE);

if (esp_now_init() != ESP_OK) {

Serial.println("ESP-NOW init failed");

while (true) delay(10);

}

esp_now_register_recv_cb(onDataReceived);

esp_now_peer_info_t peerInfo = {};

memcpy(peerInfo.peer_addr, HELMET_NODE_MAC_ADDRESS, 6);

peerInfo.channel = VEST_NODE_ESPNOW_CHANNEL;

peerInfo.encrypt = false;

if (esp_now_add_peer(&peerInfo) != ESP_OK) {

Serial.println("ESP-NOW peer add failed");

while (true) delay(10);

}

}

void onDataReceived(const esp_now_recv_info_t *info, const uint8_t *data, int len) {

if (memcmp(info->src_addr, HELMET_NODE_MAC_ADDRESS, 6) != 0) return;

if (len == static_cast<int>(sizeof(StatusPacket))) {

StatusPacket statusPacket = {};

memcpy(&statusPacket, data, sizeof(statusPacket));

if (statusPacket.packetType != PACKET_TYPE_STATUS ||

statusPacket.senderDeviceId != VEST_NODE_DEVICE_ID) return;

g_helmetCheatDetected = statusPacket.cheatDetected != 0;

g_helmetLinkReceived = true;

return;

}

if (len != static_cast<int>(sizeof(HitPacket))) return;

HitPacket hitPacket = {};

memcpy(&hitPacket, data, sizeof(hitPacket));

if (hitPacket.packetType != HIT_PACKET_TYPE_HIT || hitPacket.hitPart != HIT_PART_HEAD) return;

if (hitPacket.shooterDeviceId == VEST_NODE_DEVICE_ID) return;

g_pendingESPNOWHit.packetType = hitPacket.packetType;

g_pendingESPNOWHit.senderDeviceId = hitPacket.senderDeviceId;

g_pendingESPNOWHit.shooterDeviceId = hitPacket.shooterDeviceId;

g_pendingESPNOWHit.hitPart = hitPacket.hitPart;

g_pendingESPNOWHit.deviceTime = hitPacket.deviceTime;

g_hasPendingESPNOWHit = true;

g_helmetLinkReceived = true;

}

// ============================================================

// Display (Display.ino)

// ============================================================

void drawFullMacRow(int y, const char *prefix, const uint8_t *mac) {

g_tftDisplay.fillRect(0, y, DISPLAY_WIDTH, 10, ST7735_BLACK);

g_tftDisplay.setCursor(0, y);

g_tftDisplay.printf(

"%s%02X:%02X:%02X:%02X:%02X:%02X",

prefix, mac[0], mac[1], mac[2], mac[3], mac[4], mac[5]);

}

void initDisplay() {

g_tftDisplay.initR(INITR_MINI160x80);

g_tftDisplay.setRotation(1);

g_tftDisplay.fillScreen(ST7735_BLACK);

g_tftDisplay.setTextWrap(false);

}

void drawStatus() {

HitDisplayState hitSnapshot = {};

hitSnapshot.senderDeviceId = g_latestHit.senderDeviceId;

hitSnapshot.shooterDeviceId = g_latestHit.shooterDeviceId;

hitSnapshot.hitPart = g_latestHit.hitPart;

hitSnapshot.deviceTime = g_latestHit.deviceTime;

hitSnapshot.totalHits = g_latestHit.totalHits;

hitSnapshot.hasHit = g_latestHit.hasHit;

bool helmetLinkReceivedSnapshot = g_helmetLinkReceived;

g_tftDisplay.setTextColor(ST7735_WHITE);

g_tftDisplay.setTextSize(1);

g_tftDisplay.fillRect(0, 0, DISPLAY_WIDTH, 10, ST7735_BLACK);

g_tftDisplay.setCursor(0, 0);

g_tftDisplay.printf("Vest:%04X HP:%d", VEST_NODE_DEVICE_ID, static_cast<int>(g_hp));

g_tftDisplay.fillRect(0, 10, DISPLAY_WIDTH, 10, ST7735_BLACK);

g_tftDisplay.setCursor(0, 10);

g_tftDisplay.printf("Link:%s Hit:%u",

helmetLinkReceivedSnapshot ? "OK" : "WAIT",

static_cast<unsigned>(g_hitCount));

g_tftDisplay.fillRect(0, 20, DISPLAY_WIDTH, 10, ST7735_BLACK);

g_tftDisplay.setCursor(0, 20);

if (hitSnapshot.hasHit) {

g_tftDisplay.printf("Shot:%04X %s",

hitSnapshot.shooterDeviceId,

hitSnapshot.hitPart == HIT_PART_HEAD ? "HEAD" : "VEST");

} else {

g_tftDisplay.print("Shot:-");

}

g_tftDisplay.fillRect(0, 30, DISPLAY_WIDTH, 10, ST7735_BLACK);

g_tftDisplay.setCursor(0, 30);

g_tftDisplay.printf("Addr:0x%04X", VEST_NODE_DEVICE_ID);

drawFullMacRow(40, "H:", HELMET_NODE_MAC_ADDRESS);

drawFullMacRow(50, "V:", HELPER_VEST_MAC);

g_tftDisplay.fillRect(0, 60, DISPLAY_WIDTH, 20, ST7735_BLACK);

}

void taskDisplay(void *pvParameters) {

(void)pvParameters;

int16_t lastHp = -1;

uint16_t lastHitCount = 0xFFFF;

bool lastHelmetLinkReceived = false;

bool lastHasHit = false;

uint16_t lastShooterDeviceId = 0;

uint8_t lastHitPart = 0xFF;

for (;;) {

bool helmetLinkReceivedSnapshot = g_helmetLinkReceived;

bool hasHitSnapshot = g_latestHit.hasHit;

uint16_t shooterDeviceIdSnapshot = g_latestHit.shooterDeviceId;

uint8_t hitPartSnapshot = g_latestHit.hitPart;

int16_t hpSnapshot = g_hp;

uint16_t hitCountSnapshot = g_hitCount;

bool changed =

hpSnapshot != lastHp ||

hitCountSnapshot != lastHitCount ||

helmetLinkReceivedSnapshot != lastHelmetLinkReceived ||

hasHitSnapshot != lastHasHit ||

shooterDeviceIdSnapshot != lastShooterDeviceId ||

hitPartSnapshot != lastHitPart;

if (changed) {

drawStatus();

lastHp = hpSnapshot;

lastHitCount = hitCountSnapshot;

lastHelmetLinkReceived = helmetLinkReceivedSnapshot;

lastHasHit = hasHitSnapshot;

lastShooterDeviceId = shooterDeviceIdSnapshot;

lastHitPart = hitPartSnapshot;

}

vTaskDelay(pdMS_TO_TICKS(VEST_NODE_DISPLAY_REFRESH_MS));

}

}

// ============================================================

// GPS (GPS.ino)

// ============================================================

void initGps() {

#ifndef VEST_NODE_SIMULATION_MODE

Serial1.begin(VEST_NODE_GPS_BAUD, SERIAL_8N1, VEST_NODE_GPS_RX_PIN, VEST_NODE_GPS_TX_PIN);

Serial.println("GPS ready");

#else

randomSeed(static_cast<unsigned long>(micros()) ^ static_cast<unsigned long>(VEST_NODE_DEVICE_ID));

setSimulationGpsRandom();

Serial.println("GPS simulation ready");

#endif

}

void updateGps() {

#ifndef VEST_NODE_SIMULATION_MODE

while (Serial1.available() > 0) {

g_tinyGps.encode(static_cast<char>(Serial1.read()));

}

if (!g_tinyGps.location.isUpdated()) return;

if (!g_tinyGps.location.isValid()) {

g_gpsData.valid = false;

return;

}

g_gpsData.latitudeE7 = static_cast<int32_t>(g_tinyGps.location.lat() * 10000000.0);

g_gpsData.longitudeE7 = static_cast<int32_t>(g_tinyGps.location.lng() * 10000000.0);

g_gpsData.valid = true;

#endif

}

void sendPeriodicGps() {

unsigned long now = millis();

if (now - g_lastGpsSendAt < VEST_NODE_GPS_SEND_INTERVAL_MS) return;

g_lastGpsSendAt = now;

#ifdef VEST_NODE_SIMULATION_MODE

if (g_simulationGpsRandomEnabled) setSimulationGpsRandom();

#endif

if (sendGpsViaLoRa()) {

writeGpsToSd(VEST_NODE_DEVICE_ID, g_hp, g_hitCount,

g_gpsData.latitudeE7, g_gpsData.longitudeE7, g_gpsData.valid);

}

}

void captureGpsSnapshot(GpsData &gpsData) {

gpsData.latitudeE7 = g_gpsData.latitudeE7;

gpsData.longitudeE7 = g_gpsData.longitudeE7;

gpsData.valid = g_gpsData.valid;

}

// ============================================================

// LoRa — init & kirim (stub; sesuaikan jika ada LoRa.ino)

// ============================================================

void initLoRa() {

SPI.begin(VEST_NODE_LORA_SCLK_PIN, VEST_NODE_LORA_MISO_PIN, VEST_NODE_LORA_MOSI_PIN, VEST_NODE_LORA_CS_PIN);

int state = g_LoRaRadio.begin(

VEST_NODE_LORA_FREQUENCY,

VEST_NODE_LORA_BANDWIDTH,

VEST_NODE_LORA_SPREADING_FACTOR,

VEST_NODE_LORA_CODING_RATE,

VEST_NODE_LORA_SYNC_WORD,

VEST_NODE_LORA_OUTPUT_POWER,

VEST_NODE_LORA_PREAMBLE_LENGTH);

if (state != RADIOLIB_ERR_NONE) {

Serial.printf("LoRa init failed code=%d\n", state);

} else {

Serial.println("LoRa ready");

}

}

bool sendHitViaLoRa(const HitPacket &hitPacket) {

LoRaHitPacket LoRaPacket = {};

LoRaPacket.packetType = LORA_PACKET_TYPE_HIT;

LoRaPacket.senderDeviceId = hitPacket.senderDeviceId;

LoRaPacket.shooterDeviceId = hitPacket.shooterDeviceId;

LoRaPacket.hitPart = hitPacket.hitPart;

LoRaPacket.hp = g_hp;

LoRaPacket.hitCount = g_hitCount;

LoRaPacket.latitudeE7 = g_gpsData.latitudeE7;

LoRaPacket.longitudeE7 = g_gpsData.longitudeE7;

int state = g_LoRaRadio.transmit(

reinterpret_cast<uint8_t *>(&LoRaPacket),

sizeof(LoRaPacket));

return state == RADIOLIB_ERR_NONE;

}

bool sendGpsViaLoRa() {

LoRaGpsPacket LoRaPacket = {};

LoRaPacket.packetType = LORA_PACKET_TYPE_GPS;

LoRaPacket.senderDeviceId = VEST_NODE_DEVICE_ID;

LoRaPacket.hp = g_hp;

LoRaPacket.hitCount = g_hitCount;

LoRaPacket.cheatDetected = g_cheatDetected ? 1 : 0;

LoRaPacket.latitudeE7 = g_gpsData.latitudeE7;

LoRaPacket.longitudeE7 = g_gpsData.longitudeE7;

int state = g_LoRaRadio.transmit(

reinterpret_cast<uint8_t *>(&LoRaPacket),

sizeof(LoRaPacket));

return state == RADIOLIB_ERR_NONE;

}

// ============================================================

// SD Card (SdCard.ino)

// ============================================================

const char *VEST_NODE_HIT_CSV_HEADER = "TYPE,MS,SENDER,SHOOTER,PART,HP,HITS,LAT_E7,LNG_E7";

const char *VEST_NODE_GPS_CSV_HEADER = "TYPE,MS,SENDER,HP,HITS,LAT_E7,LNG_E7";

String formatCsvHex(uint16_t deviceId) {

char buffer[7] = {};

snprintf(buffer, sizeof(buffer), "0x%04X", deviceId);

return String(buffer);

}

bool ensureSdCsvHeader(const char *path, const char *header) {

if (!g_sdReady) return false;

if (SD.exists(path)) {

File existingFile = SD.open(path, FILE_READ);

if (existingFile) {

const bool hasData = existingFile.size() > 0;

existingFile.close();

if (hasData) return true;

}

}

File file = SD.open(path, FILE_WRITE);

if (!file) {

Serial.printf("SD header open failed path=%s\n", path);

return false;

}

file.println(header);

file.close();

return true;

}

void initSdCard() {

g_sdReady = SD.begin(VEST_NODE_SD_CS_PIN, SPI, 8000000);

if (!g_sdReady) {

Serial.println("SD init failed");

return;

}

ensureSdCsvHeader(VEST_NODE_SD_HIT_FILE, VEST_NODE_HIT_CSV_HEADER);

ensureSdCsvHeader(VEST_NODE_SD_GPS_FILE, VEST_NODE_GPS_CSV_HEADER);

Serial.println("SD ready");

}

void writeHitToSd(

const HitPacket &hitPacket,

int16_t hp,

uint16_t hitCount,

int32_t latitudeE7,

int32_t longitudeE7,

bool hasGps) {

if (!g_sdReady && !SD.begin(VEST_NODE_SD_CS_PIN, SPI, 8000000)) {

Serial.println("SD hit log skipped: SD unavailable");

return;

}

g_sdReady = true;

if (!ensureSdCsvHeader(VEST_NODE_SD_HIT_FILE, VEST_NODE_HIT_CSV_HEADER)) return;

File file = SD.open(VEST_NODE_SD_HIT_FILE, FILE_APPEND);

if (!file) {

Serial.println("SD hit log append failed");

return;

}

String row =

String("hit,") + String(millis()) + "," +

formatCsvHex(hitPacket.senderDeviceId) + "," +

formatCsvHex(hitPacket.shooterDeviceId) + "," +

String(hitPacket.hitPart == HIT_PART_HEAD ? "head" : "vest") + "," +

String(hp) + "," + String(hitCount) + "," +

String(hasGps ? latitudeE7 : 0) + "," +

String(hasGps ? longitudeE7 : 0);

file.println(row);

file.close();

}

void writeGpsToSd(

uint16_t senderDeviceId,

int16_t hp,

uint16_t hitCount,

int32_t latitudeE7,

int32_t longitudeE7,

bool hasGps) {

if (!hasGps) return;

if (!g_sdReady && !SD.begin(VEST_NODE_SD_CS_PIN, SPI, 8000000)) {

Serial.println("SD gps log skipped: SD unavailable");

return;

}

g_sdReady = true;

if (!ensureSdCsvHeader(VEST_NODE_SD_GPS_FILE, VEST_NODE_GPS_CSV_HEADER)) return;

File file = SD.open(VEST_NODE_SD_GPS_FILE, FILE_APPEND);

if (!file) {

Serial.println("SD gps log append failed");

return;

}

String row =

String("gps,") + String(millis()) + "," +

formatCsvHex(senderDeviceId) + "," +

String(hp) + "," + String(hitCount) + "," +

String(latitudeE7) + "," + String(longitudeE7);

file.println(row);

file.close();

}

void deleteAllSdFiles() {

if (!g_sdReady && !SD.begin(VEST_NODE_SD_CS_PIN, SPI, 8000000)) {

Serial.println("SD reset failed: SD unavailable");

return;

}

g_sdReady = true;

File root = SD.open("/");

if (!root) {

Serial.println("SD reset failed: unable to open root directory");

return;

}

uint32_t deletedCount = 0;

while (true) {

File entry = root.openNextFile();

if (!entry) break;

String path = entry.name();

const bool isDirectory = entry.isDirectory();

entry.close();

if (isDirectory) continue;

if (!path.startsWith("/")) path = "/" + path;

if (SD.remove(path)) {

deletedCount += 1;

Serial.printf("SD deleted %s\n", path.c_str());

} else {

Serial.printf("SD delete failed %s\n", path.c_str());

}

}

root.close();

ensureSdCsvHeader(VEST_NODE_SD_HIT_FILE, VEST_NODE_HIT_CSV_HEADER);

ensureSdCsvHeader(VEST_NODE_SD_GPS_FILE, VEST_NODE_GPS_CSV_HEADER);

Serial.printf("SD reset complete deleted=%lu\n", static_cast<unsigned long>(deletedCount));

}

void printLastBytes(const char *path, size_t byteCount) {

if (!g_sdReady && !SD.begin(VEST_NODE_SD_CS_PIN, SPI, 8000000)) {

Serial.println("SD show failed: SD unavailable");

return;

}

g_sdReady = true;

File file = SD.open(path, FILE_READ);

if (!file) {

Serial.printf("SD show failed: cannot open %s\n", path);

return;

}

const size_t fileSize = static_cast<size_t>(file.size());

const size_t readBytes = byteCount > fileSize ? fileSize : byteCount;

const size_t startOffset = fileSize > readBytes ? fileSize - readBytes : 0;

file.seek(startOffset);

Serial.printf("SD show path=%s size=%u start=%u\n",

path, static_cast<unsigned>(fileSize), static_cast<unsigned>(startOffset));

while (file.available() > 0) Serial.write(file.read());

Serial.println();

file.close();

}

// ============================================================

// Simulation (Simulation.ino)

// ============================================================

void printSimulationHelp() {

Serial.println("Simulation commands:");

Serial.println(" vest <shooterHex>");

Serial.println(" helmet <shooterHex>");

#ifdef ENABLE_ANTI_CHEAT

Serial.println(" cheat");

#endif

Serial.println(" gps <lat> <lng>");

Serial.println(" gps random");

Serial.println(" gps off");

Serial.println(" revive");

Serial.println(" sd reset");

Serial.println(" sd show");

Serial.println(" sd show hit [N]");

Serial.println(" sd show gps [N]");

Serial.println(" help");

}

bool parsePositiveSize(const String &value, size_t &byteCount) {

char *endPointer = nullptr;

unsigned long parsedValue = strtoul(value.c_str(), &endPointer, 10);

if (endPointer == value.c_str() || *endPointer != '\0' || parsedValue == 0) return false;

byteCount = static_cast<size_t>(parsedValue);

return true;

}

bool parseGpsCoordinateE7(const String &value, int32_t &coordinateE7) {

char *endPointer = nullptr;

double parsedValue = strtod(value.c_str(), &endPointer);

if (endPointer == value.c_str() || *endPointer != '\0') return false;

coordinateE7 = static_cast<int32_t>(parsedValue * 10000000.0);

return true;

}

void setSimulationGps(int32_t latitudeE7, int32_t longitudeE7) {

g_gpsData.latitudeE7 = latitudeE7;

g_gpsData.longitudeE7 = longitudeE7;

g_gpsData.valid = true;

g_simulationGpsRandomEnabled = false;

Serial.printf("Simulation GPS fixed lat=%.6f lng=%.6f\n",

latitudeE7 / 10000000.0, longitudeE7 / 10000000.0);

}

void setSimulationGpsRandom() {

long radiusMeters = random(VEST_NODE_SIM_RADIUS_MIN_METERS, VEST_NODE_SIM_RADIUS_MAX_METERS + 1);

long angleMillidegrees = random(0L, 360000L);

double centerLatDeg = POLINEMA_CENTER_LAT_E7 / 10000000.0;

double angleRad = angleMillidegrees / 1000.0 * DEG_TO_RAD;

double northMeters = radiusMeters * cos(angleRad);

double eastMeters = radiusMeters * sin(angleRad);

double latDeg = centerLatDeg + (northMeters / 111320.0);

double lngDeg = POLINEMA_CENTER_LNG_E7 / 10000000.0 +

(eastMeters / (111320.0 * cos(centerLatDeg * DEG_TO_RAD)));

g_gpsData.latitudeE7 = static_cast<int32_t>(latDeg * 10000000.0);

g_gpsData.longitudeE7 = static_cast<int32_t>(lngDeg * 10000000.0);

g_gpsData.valid = true;

g_simulationGpsRandomEnabled = true;

Serial.printf("Simulation GPS random lat=%.6f lng=%.6f radius=%ldm\n",

g_gpsData.latitudeE7 / 10000000.0,

g_gpsData.longitudeE7 / 10000000.0,

radiusMeters);

}

bool parseShooterDeviceId(const String &value, uint16_t &shooterDeviceId) {

char *endPointer = nullptr;

unsigned long parsedValue = strtoul(value.c_str(), &endPointer, 0);

if (endPointer == value.c_str() || *endPointer != '\0' || parsedValue > 0xFFFF) return false;

shooterDeviceId = static_cast<uint16_t>(parsedValue);

return true;

}

void simulateHit(uint8_t hitPart, uint16_t shooterDeviceId) {

if (shooterDeviceId == VEST_NODE_DEVICE_ID) {

Serial.printf("IGNORE self-hit shooter=0x%04X\n", VEST_NODE_DEVICE_ID);

return;

}

HitPacket hitPacket = {};

hitPacket.packetType = HIT_PACKET_TYPE_HIT;

hitPacket.senderDeviceId = VEST_NODE_DEVICE_ID;

hitPacket.shooterDeviceId = shooterDeviceId;

hitPacket.hitPart = hitPart;

hitPacket.deviceTime = millis();

processHit(hitPacket);

}

void handleSimulationCommand(const String &commandLine) {

String trimmedLine = commandLine;

trimmedLine.trim();

if (trimmedLine.length() == 0) return;

int separatorIndex = trimmedLine.indexOf(' ');

String command = separatorIndex >= 0 ? trimmedLine.substring(0, separatorIndex) : trimmedLine;

String argument = separatorIndex >= 0 ? trimmedLine.substring(separatorIndex + 1) : "";

argument.trim();

command.toLowerCase();

if (command == "help") { printSimulationHelp(); return; }

#ifdef ENABLE_ANTI_CHEAT

if (command == "cheat") {

g_cheatDetected = !g_cheatDetected;

g_cheatClearAtMs = g_cheatDetected ? millis() + VEST_NODE_CHEAT_COOLDOWN_MS : 0;

Serial.printf("Cheat simulation: %s\n", g_cheatDetected ? "ON" : "OFF");

return;

}

#endif

if (command == "gps") {

if (argument == "off") {

g_gpsData.valid = false;

g_simulationGpsRandomEnabled = false;

Serial.println("Simulation GPS disabled");

return;

}

if (argument == "random") { setSimulationGpsRandom(); return; }

int separator = argument.indexOf(' ');

if (separator < 0) { Serial.println("Invalid GPS command"); printSimulationHelp(); return; }

String latText = argument.substring(0, separator);

String lngText = argument.substring(separator + 1);

latText.trim(); lngText.trim();

int32_t latE7 = 0, lngE7 = 0;

if (!parseGpsCoordinateE7(latText, latE7) || !parseGpsCoordinateE7(lngText, lngE7)) {

Serial.println("Invalid GPS coordinates"); printSimulationHelp(); return;

}

setSimulationGps(latE7, lngE7);

return;

}

if (command == "revive") {

g_hp = VEST_NODE_INITIAL_HP;

g_hitCount = 0;

Serial.printf("Player revived hp=%d hits=%u\n", static_cast<int>(g_hp), static_cast<unsigned>(g_hitCount));

return;

}

if (command == "sd") {

if (argument == "reset") { deleteAllSdFiles(); return; }

if (argument == "show") {

printLastBytes(VEST_NODE_SD_HIT_FILE, VEST_NODE_SD_SHOW_DEFAULT_BYTES);

printLastBytes(VEST_NODE_SD_GPS_FILE, VEST_NODE_SD_SHOW_DEFAULT_BYTES);

return;

}

if (argument.startsWith("show ")) {

String showArg = argument.substring(5);

showArg.trim();

int sep = showArg.indexOf(' ');

String fileKind = sep >= 0 ? showArg.substring(0, sep) : showArg;

String sizeText = sep >= 0 ? showArg.substring(sep + 1) : "";

fileKind.toLowerCase(); sizeText.trim();

const char *filePath = nullptr;

if (fileKind == "hit") filePath = VEST_NODE_SD_HIT_FILE;

else if (fileKind == "gps") filePath = VEST_NODE_SD_GPS_FILE;

else { Serial.println("Invalid sd show target"); printSimulationHelp(); return; }

size_t byteCount = VEST_NODE_SD_SHOW_DEFAULT_BYTES;

if (sizeText.length() > 0 && !parsePositiveSize(sizeText, byteCount)) {

Serial.println("Invalid sd show byte count"); printSimulationHelp(); return;

}

printLastBytes(filePath, byteCount);

return;

}

Serial.println("Invalid sd command"); printSimulationHelp(); return;

}

if (command == "vest" || command == "helmet") {

uint16_t shooterDeviceId = 0;

if (!parseShooterDeviceId(argument, shooterDeviceId)) {

Serial.println("Invalid shooter device ID"); printSimulationHelp(); return;

}

simulateHit(command == "helmet" ? HIT_PART_HEAD : HIT_PART_VEST, shooterDeviceId);

return;

}

Serial.println("Unknown command");

printSimulationHelp();

}

void processSerialCommands() {

while (Serial.available() > 0) {

char inputCharacter = static_cast<char>(Serial.read());

if (inputCharacter == '\r') continue;

if (inputCharacter == '\n') {

handleSimulationCommand(g_simulationInputLine);

g_simulationInputLine = "";

continue;

}

g_simulationInputLine += inputCharacter;

}

}
