latifannurdiansyah/Laser-tag-project/docs/FinalReportNew1.pdf

IMPLEMENTASI RANGKAIAN ELEKTRONIK DAN SISTEM KOMUNIKASI MULTI-PEMAIN UNTUK PERMAINAN LASER TAG MENGGUNAKAN ESP-NOW DAN LORA

PROYEK AKHIR

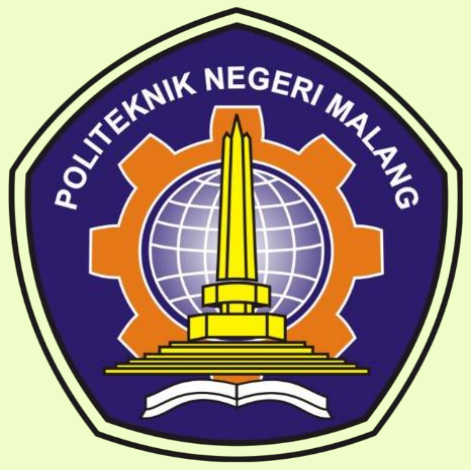
[picture p60: figure]

OLEH:
LATIFAN NURDIANSYAH
NIM: 244101077012

PROGRAM STUDI SARJANA TERAPAN TEKNIK ELEKTRONIKA JURUSAN TEKNIK ELEKTRO
POLITEKNIK NEGERI MALANG
2026

Bidang Instrumentasi dan Data Akuisisi

IMPLEMENTASI RANGKAIAN ELEKTRONIK DAN SISTEM KOMUNIKASI MULTI-PEMAIN UNTUK PERMAINAN LASER TAG MENGGUNAKAN ESP-NOW DAN LORA

PROYEK AKHIR

Diajukan sebagai salah satu syarat memperoleh Ijazah Sarjana Terapan Teknik Program Studi Sarjana Terapan Teknik Elektronika Jurusan Teknik Elektro Politeknik Negeri Malang

OLEH:

LATIFAN NURDIANSYAH

NIM: 244101077012

PROGRAM STUDI SARJANA TERAPANTEKNIK ELEKTRONIKA JURUSAN TEKNIK ELEKTRO
POLITEKNIK NEGERI MALANG
2026

i

HALAMAN PENGESAHAN

IMPLEMENTASI RANGKAIAN ELEKTRONIK DAN SISTEM KOMUNIKASI MULTI-PEMAIN UNTUK PERMAINAN LASER TAG MENGGUNAKAN ESP-NOW DAN LoRa

Oleh:

Latifan Nurdiansyah

244101077012

Proyek Akhir ini telah dipertahankan di depan dewan penguji pada tanggal April 2026 dan disahkan oleh :

Pembimbing I

Nama Pembimbing I | : Indrazno Siradjuddin, S.T., M.T., Ph.D.
NIP. | : 197406242000121001 | |

Pembimbing II

Nama Pembimbing II | : Gillang Al Azhar, S.S.T., M.Tr.T.
NIP. | : 199506222020121003 | |

Penguji I

Nama Penguji I | : Denda Dewatama, S.T., M.T.
NIP. | : 197812272005011001 | |

Penguji II

Nama Penguji II | : Odhitya Desta Triswidrananta, S.Pd., M.Pd.
NIP. | : 198912152023211020 | |
| | Malang, 27 April 2026
Mengetahui, | Menyetujui,
Ketua Jurusan Teknik Elektro | Koordinator Program Studi Sarjana
| | Terapan Teknik Elektronika
Prof. Ir. Mohammad Noor Hidayat, S.T., M.Sc., Ph.D. | Hari Kurnia Safitri, S.T., M.T.
NIP. 197409252001121003 | NIP. 197307132002122002

ii

PERNYATAAN KEASLIAN PROYEK AKHIR

Saya yang bertanda tangan di bawah ini:

Nama | : | Latifan Nurdiansyah
NIM | : | 244101077012
Jurusan/Program Studi | : | Teknik Elektro/D4 Teknik Elektronika
Judul | : | Implementasi rangkaian elektronik dan sistem komuikasi multi-pemain untuk permainan laser tag menggunakan ESP-NOW dan LoRa

Menyatakan dengan sebenarnya bahwa:

1. Karya tulis ini benar – benar merupakan hasil karya saya sendiri, bukan

merupakan alihan penelitian, tulisan atau pikiran orang lain yang saya akui

sebagai hasil proyek akhir, tulisan atau pikiran saya sendiri.

2. Apabila di kemudian hari terbukti atau dapat dibuktikan bahwa karya tulis

ini hasil jiplakan (plagiasi), dan saya tidak dapat memenuhi pernyataan saya

ini maka saya bersedia menerima sanksi atas perbuatan saya tersebut.

Malang. 27 April 2026

Latifan Nurdiansyah

iii

ABSTRAK

Latifan Nurdiansyah, 2026. Implementasi Rangkaian Elektronik dan Sistem

Komunikasi Multi-Pemain untuk Permainan Laser Tag Menggunakan ESP-

NOW dan LoRa.

Proyek Akhir Program Studi Sarjana Terapan Teknik Elektronika, Jurusan

Teknik Elektro, Politeknik Negeri Malang, 2026.

Pembimbing (I) Indrazno Siradjuddin, S.T., M.T., Ph.D. (II) Gillang Al Azhar,

S.S.T., M.Tr.T.

Sistem laser tag komersial berbasis Multiple Integrated Laser Engagement

System (MILES) yang tersedia saat ini umumnya bersifat tertutup, minim informasi

posisi real-time, serta rentan terhadap manipulasi fisik pada sensor inframerah,

sehingga membatasi penerapannya pada skenario rekreasi maupun kompetisi

dengan anggaran terbatas. Penelitian ini bertujuan mengimplementasikan

rangkaian elektronik pada unit senjata, helm, dan rompi dengan mengintegrasikan

protokol ESP-NOW dan LoRa pada mikrokontroler ESP32-S3 guna menciptakan

komunikasi multi-pemain dua arah dan pencatatan skor real-time melalui

antarmuka web. Sistem dibatasi pada dua unit pemain yang berkomunikasi

menggunakan modulasi inframerah 38 kHz berprotokol NEC. Metodologi yang

diterapkan menggunakan arsitektur komunikasi dua lapis: ESP-NOW untuk

interaksi cepat antar perangkat jarak dekat, dan LoRaWAN melalui The Things

Network (TTN) untuk pengiriman data jarak jauh ke server berbasis Vercel;

dilengkapi mekanisme anti-cheating menggunakan photodiode dan gerbang logika

NOR 8-input (IC 74HC4078) yang terintegrasi pada dome sensor TSOP4838. Hasil

pengujian menunjukkan sensor inframerah mampu menerima sinyal pada jarak

hingga 170 meter dengan cakupan sudut 180° menggunakan lensa, transmisi ESP-

NOW berhasil pada jarak 4 meter meskipun terdapat penghalang, serta transmisi

LoRaWAN berjalan dengan latensi 3–5 detik, membuktikan efektivitas sistem

sebagai solusi laser tag yang transparan dan terukur.

Kata Kunci: Laser Tag, MILES, ESP-NOW, LoRaWAN, Anti-Cheating, ESP32-S3, NEC Protocol, TSOP4838, IoT.

iv

ABSTRACT

Latifan Nurdiansyah, 2026. Implementation of Electronic Circuits and Multi-

Player Communication Systems for Laser Tag Games Using ESP-NOW and

LoRa.

Proyek Akhir Program Studi Sarjana Terapan Teknik Elektronika, Jurusan

Teknik Elektro, Politeknik Negeri Malang, 2026.

Supervisor(I) Indrazno Siradjuddin, S.T., M.T., Ph.D. (II) Gillang Al Azhar,

S.S.T., M.Tr.T.

Currently available commercial laser tag systems based on the Multiple

Integrated Laser Engagement System (MILES) are generally closed-loop systems,

provide minimal real-time position data, and are susceptible to physical tampering

of infrared sensors, thereby limiting their application to recreational and

competitive scenarios with limited budgets. This research aims to implement

electronic circuits on weapon units, helmets, and vests by integrating the ESP-NOW

and LoRa protocols on an ESP32-S3 microcontroller to enable two-way multiplayer

communication and real-time scoring via a web interface. The system is limited to

two player units communicating via 38 kHz infrared modulation using the NEC

protocol. The methodology employs a two-layer communication architecture: ESP-

NOW for fast, short-range device-to-device interaction, and LoRaWAN via The

Things Network (TTN) for long-range data transmission to a Vercel-based server;

supplemented by an anti-cheating mechanism using a photodiode and an 8-input

NOR logic gate (IC 74HC4078) integrated into the TSOP4838 dome sensor. Test

results show that the infrared sensor can receive signals at distances of up to 170

meters with a 180° coverage angle using a lens, ESP-NOW transmission was

successful at a distance of 4 meters even with obstacles, and LoRaWAN

transmission operated with a latency of 3–5 seconds, proving the system’s

effectiveness as a transparent and measurable laser tag solution.

Keywords: Laser Tag, MILES, ESP-NOW, LoRaWAN, Anti-Cheating, ESP32-S3,

NEC Protocol, TSOP4838, IoT.

v

KATA PENGANTAR

Puji syukur kehadirat Allah SWT yang telah melimpahkan rahmat serta

hidayah-Nya, serta memberikan petunjuk serta kesehatan sehingga penulis dapat

menyelesaikan Laporan Akhir yang berjudul “Implementasi Rangkaian

Elektronik dan Sistem Komunikasi Multi-Pemain untuk Permainan Laser Tag

Menggunakan ESP-NOW dan LoRa”. Pada kesempatan ini penulis mengucapkan

terimakasih kepada pihak-pihak yang telah membantu dan membimbing dalam

penyusunan Laporan Akhir, yaitu kepada :

1. Bapak Ir. Supriatna Adhisuwignjo, S.T., M.T. selaku Direktur Politeknik

Negeri Malang beserta jajarannya.

2. Bapak Prof. Ir. Mohammad Noor Hidayat, S.T., M.Sc., Ph.D. selaku Ketua

Jurusan Teknik Elektro beserta jajarannya.

3. Ibu Hari Kurnia Safitri, ST., MT. selaku Ketua Program Studi Sarjana Terapan

Teknik Elektronika beserta jajarannya.

4. Bapak Indrazno Siradjuddin, S.T., M.T., Ph.D. selaku Dosen Pembimbing 1,

yang telah membimbing dan mendampingi sepenuh hati dari awal hingga akhir

penelitian proyek akhir ini.

5. Bapak Gillang Al Azhar, S.S.T., M.Tr.T. selaku Dosen Pembimbing 2, yang

telah membimbing dari awal hingga akhir penelitian proyek akhir ini.

6. Seluruh Dosen dan Staff Politeknik Negeri Malang, khususnya pada Program

Studi Sarjana Terapan Teknik Elektronika.

7. Orang tua dan Keluarga Besar Ma’ Pah yang telah memberi dukungan do’a dan

materi dan juga memberikan apapun yang dibutuhkan.

8. Teman Teman Lab Robotics Polinema yang dengan senang hati bertukar ilmu

dan pikiran

9. Ahmad Firdan Al Hadi, Akbar Dimas Herdiansyah, Jati Wahyu Kusuma,

Maharani Inggrid J. dan Syahrul Zanuar, mereka saya anggap seperti keluarga

seperjuangan yang selalu memberikan motivasi untuk terus melangkah sampai

dengan menyelesaikan laporan proyek akhir saya.

10. Mahasiswa dengan NIM 2142520038 Jurusan Akutansi yang selalu

memeberikan dukungan penulis dalam mengerjakan laporan ini dalam suka

maupun duka, memberikan segenap rasa sakit, senang, semangat, motivasi,

vi

cinta dan kasih dalam membimbing dan membantu laporan proyek akhir saya

sampai dengan selesai.

11. Teman-teman mahasiswa dan pihak yang telah membantu dalam penyusunan

Laporan Akhir ini.

Penulis menyadari masih banyak kekurangan dan pembuatan proyek akhir ini.

Oleh karena itu, penulis mengharapkan saran dan kritik yang bersifat membangun

dan semoga proyek akhir ini dapat bermanfaat.

Malang, 27 April 2026

Latifan Nurdiansyah

NIM 244101077012

vii

DAFTAR ISI

viii

3.4.3 Perancangan rangkaian helm dengan Sensor Penerima Inframerah

ix

x

DAFTAR GAMBAR

xi

DAFTAR TABEL

BAB I
PENDAHULUAN

### 1.1 Latar Belakang

Perkembangan teknologi digital telah membawa perubahan signifikan dalam

dunia hiburan interaktif dan simulasi pelatihan militer modern. Salah satu

manifestasinya adalah sistem simulasi tempur yang menggantikan peluru nyata

dengan media lain yang lebih aman, efisien, dan dapat dimonitor secara digital.

Kebutuhan akan sistem simulasi semacam ini terus meningkat, baik untuk

keperluan pelatihan militer, kompetisi olahraga taktis, maupun hiburan rekreasi

komunitas yang memerlukan pengalaman bermain yang terukur dan transparan.

Secara khusus, salah satu implementasi teknologi simulasi tempur yang telah

berkembang adalah Multiple Integrated Laser Engagement System (MILES), yaitu

sistem yang menggunakan pancaran cahaya inframerah sebagai pengganti peluru

nyata. Pada sistem MILES, setiap senjata dilengkapi Small Arm Transmitter (SAT)

yang memancarkan sinyal inframerah berprotokol NEC berfrekuensi 38 kHz saat

pelatuk ditarik, kemudian dideteksi oleh sensor penerima TSOP4838 yang

terpasang pada rompi maupun helm lawan (Siradjuddin et al., 2024).Sistem ini

memungkinkan simulasi pertempuran berlangsung secara realistis tanpa risiko fisik

yang berbahaya.

Beberapa penelitian terdahulu telah mengembangkan sistem berbasis

inframerah untuk simulasi pertempuran serupa.(Siradjuddin et al., 2024)

mengembangkan sistem identifikasi pemain melalui kode digital inframerah yang

mampu memberikan umpan balik saat terkena tembakan. (Hailan et al., 2024)

membuktikan kemampuan protokol ESP-NOW pada mikrokontroler ESP32 untuk

komunikasi peer-to-peer berkecepatan tinggi dengan latensi sangat rendah tanpa

memerlukan jaringan Wi-Fi, ideal untuk interaksi antar pemain dalam jarak dekat.

Sementara itu, (Konate et al., 2025) dan (Yahya et al., 2024) menunjukkan

kemampuan teknologi LoRa dalam transmisi data hingga beberapa kilometer

dengan konsumsi daya sangat rendah, membuka peluang integrasi data permainan

ke server pusat jarak jauh secara real-time.

Meskipun demikian, sistem-sistem yang telah dikembangkan tersebut masih

memiliki sejumlah kelemahan. Sistem MILES konvensional umumnya bersifat

tertutup, membutuhkan perangkat keras yang mahal, infrastruktur kompleks, dan

konsumsi daya tinggi sehingga sulit diterapkan pada komunitas dengan anggaran

terbatas. Selain itu, sistem yang ada minim informasi posisi pemain secara real-

time dan rentan terhadap manipulasi fisik pada sensor inframerah yang

memungkinkan terjadinya kecurangan tanpa mekanisme deteksi yang memadai.

Keterbatasan jangkauan pada protokol komunikasi jarak dekat juga menjadi

kendala tersendiri ketika sistem perlu diintegrasikan dengan platform pemantauan

berskala luas. Fokus pada penelitian ini adalah pengembangan sistem permainan

Laser Tag yang terjangkau, modular, dan terkoneksi secara digital dengan

memanfaatkan kombinasi ESP-NOW dan LoRaWAN. Penelitian ini secara spesifik

membahas implementasi rangkaian elektronik pada unit senjata, helm, dan rompi

berbasis mikrokontroler ESP32-S3.

Dari beberapa penjelasan permasalahan dan urgensi di atas, dapat

disimpulkan bahwa dibutuhkan sebuah sistem simulasi pertempuran yang

terjangkau, modular, dan terkoneksi secara digital. Pada proyek akhir ini

dikembangkan Sistem Permainan Laser Tag berbasis ESP-NOW dan LoRaWAN,

di mana proses tembak-menembak tidak menggunakan peluru nyata, melainkan

memanfaatkan pancaran sinyal inframerah berprotokol NEC 38 kHz yang

membawa ID address unik penembak. Sinyal tersebut dapat diterima oleh sensor

TSOP4838 yang terpasang pada helm maupun rompi lawan. Apabila sinyal

diterima oleh helm, data tembakan akan diteruskan ke rompi melalui komunikasi

ESP-NOW. Selanjutnya, ketika rompi mendeteksi bahwa pemain tertembak, sistem

secara otomatis membaca koordinat posisi kejadian melalui modul GPS yang

tertanam pada perangkat Heltec Wireless Tracker, kemudian mengirimkan data

tersebut ke server pusat melalui jaringan LoRa. Selain itu, baik helm maupun rompi

dilengkapi dengan fitur anti-cheating untuk meminimalkan terjadinya kecurangan

selama permainan berlangsung. Seluruh data permainan, mulai dari ID penembak,

ID pemain yang tertembak, hingga koordinat lokasi kejadian, dapat dipantau secara

real-time melalui antarmuka web server.

### 1.2 Rumusan Masalah

Berdasarkan latar belakang di atas, dapat dirumuskan beberapa masalah

sebagai berikut:

a. Bagaimana merancang mekanisme tembakan berbasis protokol NEC yang

memancarkan ID address penembak melalui sinyal Inframerah 38 kHz dan

dapat diterima oleh sensor TSOP4838 yang terpasang pada helm maupun

rompi lawan?

b. Bagaimana merancang sistem komunikasi antara helm dan rompi

menggunakan ESP-NOW serta pengiriman data posisi tertembak beserta ID

penembak ke server pusat melalui jaringan LoRa?

c. Bagaimana menerapkan mekanisme filtering ID pada penerima Inframerah

agar perangkat pemain tidak dapat mendeteksi sinyal tembakan yang berasal

dari perangkatnya sendiri sehingga kecurangan dapat diminimalkan?

### 1.3 Batasan Masalah

Untuk memfokuskan proyek akhir, diberikan pembatasan masalah sebagai berikut:

a. Sistem hanya diimplementasikan pada dua unit pemain yang masing-masing

terdiri dari satu senjata, satu helm, dan satu rompi berbasis mikrokontroler

ESP32-S3 Supermini pada modul Heltec Wireless Tracker V1.1.

b. Mekanisme tembakan hanya menggunakan protokol NEC dengan modulasi

inframerah 38 kHz dan sensor penerima TSOP4838; pengujian jarak efektif

penerimaan sinyal inframerah dilakukan di area terbuka hingga 170 meter

menggunakan lensa Fresnel, dengan sudut penerimaan maksimal 180°.

c. Komunikasi antar perangkat menggunakan ESP-NOW untuk interaksi helm ke

rompi pada jarak dekat, dan LoRaWAN melalui gateway The Things Network

(TTN) untuk pengiriman data ke server; sistem hanya mengirimkan data status

tembakan dan koordinat GPS, tanpa audio streaming, video, maupun enkripsi

tingkat lanjut.

d. Pelacakan posisi pemain menggunakan modul GPS bawaan Heltec Wireless

Tracker V1.2 dan hanya direkam saat pemain tertembak; sistem tidak

mendukung pelacakan posisi di dalam ruangan (indoor) karena bergantung pada

sinyal satelit.

e. Mekanisme anti-cheating menggunakan photodiode dan gerbang logika NOR

8-input (IC 74HC4078) yang hanya mendeteksi penutupan fisik pada sensor

TSOP4838; fitur ini tidak aktif pada kondisi merayap atau terhalang pohon dan

bangunan, serta deteksi baru terpicu setelah sinyal terganggu secara kontinu

selama 5 detik.

f. Seluruh perangkat menggunakan baterai LiPo sebagai sumber daya tanpa sistem

manajemen daya otomatis; tidak membahas pengisian daya, estimasi kapasitas

baterai, maupun alternatif sumber daya lainnya.

g. Antarmuka pemantauan hanya berupa web interface berbasis Vercel; tidak

tersedia aplikasi mobile, fitur respawn otomatis, pengaturan nyawa, maupun

timer permainan yang dapat dikonfigurasi.

### 1.4 Tujuan

Berdasarkan rumusan masalah yang telah ditetapkan terdapat beberapa tujuan

dari proyek akhir ini. Berikut merupakan tujuan dari proyek akhir ini:

a. Merancang dan mengimplementasikan mekanisme tembakan berbasis protokol

NEC yang memancarkan ID address unik penembak melalui sinyal inframerah

38 kHz menggunakan Small Arm Transmitter (SAT), serta memastikan sinyal

tersebut dapat diterima secara akurat oleh sensor TSOP4838 yang terpasang

pada helm maupun rompi lawan.

b. Merancang sistem komunikasi dua lapis antara helm dan rompi menggunakan

ESP-NOW untuk interaksi jarak dekat, serta mengimplementasikan

pengiriman data posisi tertembak dan ID penembak ke server pusat melalui

jaringan LoRaWAN dengan gateway TTN dan antarmuka web berbasis Vercel.

c. Menerapkan mekanisme filtering ID pada penerima inframerah dan sistem

deteksi fisik berbasis photodiode serta gerbang logika NOR (IC 74HC4078)

sebagai fitur anti-cheating agar perangkat pemain tidak dapat mendeteksi

sinyal tembakan dari perangkatnya sendiri dan manipulasi fisik pada sensor

dapat diminimalkan.

### 1.5 Sistematika Penulisan

Pembahasan dalam proyek akhir ini disusun secara terstruktur dalam lima bab

utama, yang masing-masing memiliki fokus tersendiri sesuai dengan alur proyek akhir dan pengembangan sistem. Sistematika penulisan pada laporan proyek akhir

ini :

Bab I Pendahuluan

Bab ini berisi latar belakang pemilihan topik proyek akhir, rumusan masalah

beserta batasan masalah yang diteliti. Selain itu, juga dijelaskan tujuan proyek akhir

serta manfaat yang ingin dicapai. Bab ini juga memberikan gambaran umum

mengenai struktur penulisan laporan proyek akhir.

Bab II Tinjauan Pustaka

Bab ini membahas materi teoretis yang relevan dengan proyek akhir,

termasuk konsep-konsep dasar, teknik, peralatan, atau teknologi yang digunakan

dalam proses proyek akhir. Selain itu, juga disertakan referensi pustaka dan hasil

proyek akhir sebelumnya yang menjadi dasar pengembangan sistem.

Bab III Metodologi

Bab ini menjelaskan secara rinci pendekatan atau metode yang digunakan

dalam melaksanakan proyek akhir. Meliputi desain sistem, tahapan pengembangan,

alur kerja, serta langkah-langkah yang dilakukan untuk mencapai tujuan proyek

akhir.

Bab IV Hasil Dan Pembahasan

Pada bab ini disajikan hasil implementasi sistem, data pengujian perblok

dan keseluruhan, serta analisis yang dilakukan berdasarkan metode proyek akhir

yang telah ditetapkan. Pembahasan bertujuan untuk mengevaluasi kinerja sistem

dan membandingkannya dengan tujuan serta hipotesis awal.

Bab V Penutup

Bab terakhir ini memuat kesimpulan utama dari seluruh rangkaian proyek

akhir, berdasarkan hasil dan pembahasan yang telah diuraikan. Selain itu, juga

disertakan saran-saran untuk pengembangan sistem pada proyek akhir lanjutan.

### 1.6 Luaran Laporan Proyek Akhir

Proyek akhir ini memiliki 4 luaran yaitu

a. Naskah Laporan proyek akhir
b. Alat Sistem berupa senjata, helm dan rompi
c. Manual Book
d. Artikel yang disubmit di jurnal yang ber-ISSN.

BAB II

TINJAUAN PUSTAKA

### 2.1 Kajian Pustaka

Berikut adalah beberapa hasil penelitian terdahulu yang relevan dengan topik

proyek akhir ini dan dapat digunakan sebagai landasan dan tinjauan pustaka untuk

mendukung acuan proyek akhir ini sebagai berikut.

Dalam dunia pelatihan militer modern, simulasi tempur yang realistis dan

aman menjadi kebutuhan utama untuk meningkatkan kesiapan tempur tanpa harus

mengorbankan nyawa atau menggunakan amunisi aktif. Salah satu teknologi yang

telah lama dikembangkan dan digunakan secara luas untuk tujuan ini adalah

Multiple Integrated Laser Engagement System (MILES). Sistem ini memungkinkan

simulasi pertukaran tembakan antar personel atau kendaraan tempur dengan

menggunakan pancaran cahaya Inframerah (IR) sebagai pengganti peluru. Pada

sistem MILES, setiap senjata dilengkapi dengan perangkat yang disebut Small Arm

Transmitter (SAT), yang memancarkan sinyal Inframerah saat pelatih

menembakkan senjata. Sinyal ini kemudian dideteksi oleh sensor IR pada lawan,

yang mencatat "kena tembak" berdasarkan data identitas pemain (Player ID/PID)

yang turut dikodekan dalam sinyal tersebut. Oleh karena itu, performa SAT sangat

menentukan keberhasilan simulasi, termasuk jangkauan deteksi, akurasi respon

waktu, dan reliabilitas transmisi data.(Siradjuddin et al., 2024).

Salah satu komponen krusial dalam SAT adalah Inframerah (IR) emitter

Driver circuit, yang mengendalikan arus listrik ke LED Inframerah berdaya tinggi,

memastikan pancaran cahaya IR dengan intensitas optimal dan waktu respons yang

cepat. Desain rangkaian ini menjadi fokus utama dalam proyek akhir (Siradjuddin

et al., 2024), yang memperkenalkan rancangan baru sirkuit penggerak emitter

Inframerah khusus untuk aplikasi SAT dalam sistem MILES. Tujuan dari desain ini

adalah untuk memaksimalkan daya optik dan memastikan frekuensi pensaklaran 38

kHz yang sesuai dengan standar protokol komunikasi IR NEC, yang menjadi kunci

dalam efektivitas komunikasi Inframerah.(Siradjuddin et al., 2024)

Menurut jurnal Wireless Inframerah Communications: A Survey,

komunikasi Inframerah memanfaatkan propagasi cahaya pada pita near-Inframerah dengan pemancar berupa LED atau laser diode dan penerima berupa silicon p-i-n

photodiode karena efisiensinya yang baik dan biaya rendah. Sistem ini

menggunakan teknik Intensity Modulation with Direct Detection (IM/DD), di mana

arus fotodetektor sebanding dengan intensitas optik yang diterima. Namun,

penerimaan sinyal dapat terganggu oleh sumber cahaya sekitar seperti sinar

matahari atau lampu, sehingga diperlukan filter optik dan pemilihan modulasi yang

tepat untuk menjaga kualitas sinyal. Sementara itu, menurut jurnal Wireless

Inframerah Communications, komunikasi Inframerah menawarkan keunggulan

dibanding radio, seperti bandwidth yang sangat besar, biaya rendah, serta keamanan

tinggi karena sinyal tidak menembus dinding. Selain itu, penggunaan IM/DD

dengan detektor berukuran besar mencegah terjadinya multipath fading, sehingga

desain sistem lebih sederhana. Meski begitu, keterbatasan komunikasi Inframerah

adalah jangkauannya yang terbatas, kebutuhan daya pancar relatif tinggi, serta

sensitivitas terhadap noise cahaya sekitar.(Kahn & Barry, 1997; Zade et al., 2012)

Menurut jurnal Penerapan Protokol Komunikasi ESP-NOW pada Portable

Traffic Light, implementasi komunikasi berbasis ESP-NOW dengan skema master–

slave mampu bekerja stabil dengan tingkat error rata-rata hanya 3% dan jangkauan

optimal hingga 25 meter meskipun terdapat halangan berupa casing modul.

Sementara itu, pada jurnal ESPNOW Protocol-Based IIoT System for Remotely

Monitoring and Controlling Industrial Systems, ESP-NOW dimanfaatkan untuk

menghubungkan beberapa node sensor dalam sistem Industrial Internet Of Things

(IIoT), yang terbukti mendukung pemantauan industri secara real-time dengan

latensi rendah, konsumsi daya hemat, serta keamanan data yang terjamin melalui

enkripsi. Di sisi lain, proyek akhir berjudul Indoor Performance Evaluation of ESP-

NOW mengevaluasi performa ESP-NOW dalam kondisi indoor dan menemukan

bahwa meskipun faktor lingkungan seperti pantulan dan penghalang dapat

memengaruhi kinerja, protokol ini tetap menunjukkan efisiensi daya lebih dari 30%

dibanding Wi-Fi serta jangkauan yang lebih baik hingga 15%. Berdasarkan temuan-

temuan tersebut, ESP-NOW sangat relevan untuk digunakan pada sistem permainan

Laser Tag, di mana komunikasi antar perangkat harus berlangsung cepat, stabil, dan

hemat daya dalam area permainan.(Fajar Arofah et al., 2023; Hailan et al., 2024;

Urazayev et al., 2023)

Menurut proyek akhir Design and Implementation of a Backscatter

Communication System Based on LoRa Technology, LoRa backscatter mampu

meningkatkan efisiensi energi dan memperluas jangkauan komunikasi dengan

memanfaatkan sinyal pantulan dari perangkat pasif, sehingga sangat potensial

untuk aplikasi IoT berskala besar. Sementara itu, dalam jurnal Analisa Performansi

Komunikasi LoRa (Long Range) pada Sistem Monitoring Buoy di Laut, komunikasi

LoRa 915 MHz terbukti dapat menjaga kualitas dengan nilai RSSI rata-rata lebih

baik dari -120 dB dan SNR lebih besar dari -20 dB meskipun terdapat interferensi,

sehingga layak digunakan untuk sistem monitoring di lingkungan laut. Selanjutnya,

hasil proyek akhir Analisis Jarak Jangkauan LoRa (Long Range) di Lingkungan

Urban, menunjukkan bahwa jangkauan LoRa di area perkotaan dapat mencapai

hingga 2 km dengan nilai RSSI relatif stabil, meskipun packet loss meningkat pada

jarak yang lebih jauh. Dari ketiga kajian tersebut dapat disimpulkan bahwa LoRa

tidak hanya handal untuk komunikasi jarak jauh dengan konsumsi energi rendah,

tetapi juga fleksibel untuk diterapkan dalam berbagai skenario, baik di laut,

lingkungan urban, maupun melalui dukungan teknologi backscatter.(Konate et al.,

2025; Nihayatus Sa’adah et al., 2024; Yanziah et al., 2020)

Global Positioning System (GPS) merupakan sistem navigasi berbasis

satelit yang terdiri dari 24 satelit operasional yang mengorbit Bumi dan

menyediakan informasi posisi secara kontinu melalui tiga segmen utama, yaitu

segmen pengguna, ruang angkasa, dan kontrol, dimana menurut jurnal

"Implementation of GPS for Location Tracking", data yang diterima berupa format

NMEA-0183 yang berisi koordinat latitude dan longitude yang perlu diekstrak

untuk memperoleh data posisi. Menurut jurnal "Missing Pilgrims Tracking System

Using GPS, GSM and Arduino Microcontroller", GPS merupakan sistem navigasi

universal yang dapat bekerja dalam segala kondisi cuaca dan dapat dikombinasikan

dengan teknologi GSM untuk menghasilkan sistem pelacakan berbasis peta digital,

sementara jurnal "A GPS Receiver for High-Altitude Satellite Navigation"

mengatakan bahwa GPS telah digunakan untuk navigasi satelit presisi di orbit

rendah Bumi (LEO), meskipun penerapannya di orbit geosinkron (GEO) masih

terbatas akibat lemahnya sinyal. Lebih lanjut, GPS merupakan bagian dari GNSS

(Global Navigation Satellite System) bersama dengan GLONASS, BeiDou, dan

Galileo, dengan akurasi 3–10 meter di lingkungan outdoor, namun menurun

menjadi 30–100 meter di indoor sehingga mendorong pengembangan Indoor

Positioning System (IPS) berbasis RTK dengan akurasi hingga 2 cm atau teknologi

UWB dengan akurasi 20 cm, serta aspek waktu yang penting dimana distribusi UTC

melalui sinyal GPS memiliki akurasi ≤30 nanodetik.(Ariffin et al., 2011; Itera,

2021; Parveen & Aldhlan, 2016; Winternitz et al., 2009)

Menurut proyek akhir Web Server Based Smart Agriculture System for Real-

Time Monitoring and Control, pemanfaatan web server dalam integrasi IoT

memungkinkan penyajian data sensor secara real-time melalui dashboard interaktif

yang mendukung sistem pertanian cerdas. Hal ini sejalan dengan studi A Web

Server-Based IoT System for Monitoring and Control of Agricultural Environment,

yang menekankan pentingnya akses global dan pengelolaan data terdistribusi secara

aman melalui jaringan berbasis web. Lebih lanjut, proyek akhir Real-Time

Monitoring of Cable Sag and Overhead Line Parameters Based on a Distributed

Sensor Network and Implementation in a Web Server and IoT, menunjukkan

bagaimana web server dipadukan dengan database MySQL dan IoT server untuk

memantau kondisi kabel transmisi listrik secara aman, baik melalui intranet maupun

internet. Sementara itu, jurnal Web-Based Integration of IoT and Artificial

Intelligence for Monitoring Aquariums, menegaskan bahwa dashboard web mampu

membangun visualisasi interaktif yang membantu pengawasan kondisi lingkungan,

seperti suhu, pH, dan kecerahan air pada sistem akuarium pintar. Dari keempat

kajian tersebut, dapat disimpulkan bahwa web server berperan penting dalam

integrasi IoT, tidak hanya untuk pemantauan data sensor secara real-time, tetapi

juga dalam mendukung keamanan akses, keterhubungan global, serta

pengembangan dashboard interaktif yang relevan untuk berbagai bidang, mulai dari

pertanian, energi, hingga sistem hiburan seperti permainan Laser Tag.(Deepika &

Renuka Prasad, 2023; Guerbaoui et al., 2025; Nicola et al., 2024; Nugraha & Rosita,

2024).

### 2.2 Teori Penunjang
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
