latifannurdiansyah/Laser-tag-project/docs/FinalReportNew2.pdf

IMPLEMENTASI RANGKAIAN ELEKTRONIK DAN SISTEM KOMUNIKASI MULTI-PEMAIN UNTUK PERMAINAN LASER TAG MENGGUNAKAN ESP-NOW DAN LORA

PROYEK AKHIR


OLEH:
LATIFAN NURDIANSYAH
NIM: 244101077012

PROGRAM STUDI SARJANA TERAPAN TEKNIK ELEKTRONIKA JURUSAN TEKNIK ELEKTRO
POLITEKNIK NEGERI MALANG
2026

Bidang Instrumentasi dan Data Akuisisi

IMPLEMENTASI RANGKAIAN ELEKTRONIK DAN SISTEM KOMUNIKASI MULTI-PEMAIN UNTUK PERMAINAN LASER TAG MENGGUNAKAN ESP-NOW DAN LORA

PROYEK AKHIR

Diajukan sebagai salah satu syarat memperoleh Ijazah Sarjana Terapan Teknik Program Studi Sarjana Terapan Teknik Elektronika Jurusan Teknik Elektro Politeknik Negeri Malang

OLEH:

LATIFAN NURDIANSYAH

NIM: 244101077012

PROGRAM STUDI SARJANA TERAPANTEKNIK ELEKTRONIKA JURUSAN TEKNIK ELEKTRO
POLITEKNIK NEGERI MALANG
2026

i

HALAMAN PENGESAHAN

IMPLEMENTASI RANGKAIAN ELEKTRONIK DAN SISTEM KOMUNIKASI MULTI-PEMAIN UNTUK PERMAINAN LASER TAG MENGGUNAKAN ESP-NOW DAN LoRa

Oleh:

Latifan Nurdiansyah

244101077012

Proyek Akhir ini telah dipertahankan di depan dewan penguji pada tanggal April 2026 dan disahkan oleh :

Pembimbing I

Nama Pembimbing I | : Indrazno Siradjuddin, S.T., M.T., Ph.D.
NIP. | : 197406242000121001 | |

Pembimbing II

Nama Pembimbing II | : Gillang Al Azhar, S.S.T., M.Tr.T.
NIP. | : 199506222020121003 | |

Penguji I

Nama Penguji I | : Denda Dewatama, S.T., M.T.
NIP. | : 197812272005011001 | |

Penguji II

Nama Penguji II | : Odhitya Desta Triswidrananta, S.Pd., M.Pd.
NIP. | : 198912152023211020 | |
| | Malang, 27 April 2026
Mengetahui, | Menyetujui,
Ketua Jurusan Teknik Elektro | Koordinator Program Studi Sarjana
| | Terapan Teknik Elektronika
Prof. Ir. Mohammad Noor Hidayat, S.T., M.Sc., Ph.D. | Hari Kurnia Safitri, S.T., M.T.
NIP. 197409252001121003 | NIP. 197307132002122002

ii

PERNYATAAN KEASLIAN PROYEK AKHIR

Saya yang bertanda tangan di bawah ini:

Nama | : | Latifan Nurdiansyah
NIM | : | 244101077012
Jurusan/Program Studi | : | Teknik Elektro/D4 Teknik Elektronika
Judul | : | Implementasi rangkaian elektronik dan sistem komuikasi multi-pemain untuk permainan laser tag menggunakan ESP-NOW dan LoRa

Menyatakan dengan sebenarnya bahwa:

1. Karya tulis ini benar – benar merupakan hasil karya saya sendiri, bukan

merupakan alihan penelitian, tulisan atau pikiran orang lain yang saya akui

sebagai hasil proyek akhir, tulisan atau pikiran saya sendiri.
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
