latifannurdiansyah/Laser-tag-project/firmware/LaserTagProjectFirmwareV1/LaserTagProjectFirmwareV1.ino

#include <Arduino.h>
#include <SPI.h>
#include <Adafruit_ST7735.h>
#include <Adafruit_GFX.h>
#include <TinyGPS++.h>
#include <WiFi.h>
#include <HTTPClient.h>

#include <Firebase_ESP_Client.h>
#include "addons/TokenHelper.h"
#include "addons/RTDBHelper.h"

#define Vext_Ctrl 3
#define LED_K 21
#define TFT_CS 38
#define TFT_DC 40
#define TFT_RST 39
#define TFT_SCLK 41
#define TFT_MOSI 42
#define GPS_RX 33
#define GPS_TX 34

#ifdef __has_include
  #if __has_include("config.h")
    #include "config.h"
  #else
    #error "config.h tidak ditemukan! Salin config.h.template ke config.h"
  #endif
#else
  #error "Compiler tidak mendukung __has_include"
#endif

#define WIFI_TIMEOUT 15000
#define WIFI_RETRY_INTERVAL 5000

TinyGPSPlus gps;
Adafruit_ST7735 tft = Adafruit_ST7735(TFT_CS, TFT_DC, TFT_MOSI, TFT_SCLK, TFT_RST);
GFXcanvas16 framebuffer = GFXcanvas16(160, 80);

FirebaseData fbdo;
FirebaseAuth auth;
FirebaseConfig config;

unsigned long lastWiFiReconnectAttempt = 0;
bool wifiConnected = false;
unsigned long lastAPISend = 0;
#define API_SEND_INTERVAL 1000

void connectWiFi() {
  Serial.print("Connecting to WiFi");
  unsigned long startAttemptTime = millis();

  while (WiFi.status() != WL_CONNECTED && millis() - startAttemptTime < WIFI_TIMEOUT) {
    Serial.print(".");
    delay(500);
  }

  if (WiFi.status() == WL_CONNECTED) {
    Serial.println("\nWiFi Connected! IP: " + WiFi.localIP().toString());
    wifiConnected = true;
  } else {
    Serial.println("\nWiFi connection failed - continuing anyway");
    wifiConnected = false;
  }
}

void checkWiFiConnection() {
  if (WiFi.status() != WL_CONNECTED) {
    wifiConnected = false;
    if (millis() - lastWiFiReconnectAttempt >= WIFI_RETRY_INTERVAL) {
      lastWiFiReconnectAttempt = millis();
      Serial.println("WiFi disconnected, reconnecting...");
      WiFi.reconnect();
    }
  } else if (!wifiConnected) {
    wifiConnected = true;
    Serial.println("WiFi reconnected! IP: " + WiFi.localIP().toString());
  }
}

void sendToAPIDualMode(float lat, float lng, int alt, int sats) {
  if (WiFi.status() != WL_CONNECTED) {
    Serial.println("[API] WiFi not connected, skipping...");
    return;
  }

  HTTPClient http;
  http.begin(API_URL_MARIADB);
  http.addHeader("Content-Type", "application/json");

  String payload = String("{") +
    "\"deviceId\":\"" DEVICE_ID "\"," +
    "\"lat\":" + String(lat, 6) + "," +
    "\"lng\":" + String(lng, 6) + "," +
    "\"alt\":" + String(alt) + "," +
    "\"sats\":" + String(sats) +
    "}";

  int httpResponseCode = http.POST(payload);
  if (httpResponseCode > 0) {
    String response = http.getString();
    Serial.println("[API-MariaDB] Response: " + String(httpResponseCode));
    Serial.println("[API-MariaDB] Body: " + response);
  } else {
    Serial.println("[API-MariaDB] Error: " + String(httpResponseCode));
  }
  http.end();
}

void setup() {
  // 1. Power on Vext (GPS + TFT)
  pinMode(Vext_Ctrl, OUTPUT);
  digitalWrite(Vext_Ctrl, HIGH);

  // 2. Aktifkan Backlight TFT
  pinMode(LED_K, OUTPUT);
  digitalWrite(LED_K, HIGH);

  // 3. LED built-in
  pinMode(LED_BUILTIN, OUTPUT);
  digitalWrite(LED_BUILTIN, LOW);

  delay(100);

  // 4. Serial Debugging & GPS
  Serial.begin(115200);
  Serial1.begin(115200, SERIAL_8N1, GPS_RX, GPS_TX);

  // 5. Inisialisasi TFT
  tft.initR(INITR_MINI160x80);
  tft.invertDisplay(false);
  tft.setRotation(1);

  // 6. Koneksi WiFi dengan timeout
  WiFi.mode(WIFI_STA);
  connectWiFi();

  // 7. Konfigurasi Firebase
  config.database_url = FIREBASE_HOST;
  config.signer.tokens.legacy_token = FIREBASE_AUTH;
  Firebase.begin(&config, &auth);
  Firebase.reconnectWiFi(true);

  // 8. Clear display awal
  framebuffer.fillScreen(ST7735_BLACK);
  if (framebuffer.getBuffer() != NULL) {
    tft.drawRGBBitmap(0, 0, framebuffer.getBuffer(), 160, 80);
  }

  Serial.println("GPS + TFT + Firebase Ready");
}

void loop() {
  checkWiFiConnection();

  while (Serial1.available() > 0) {
    gps.encode(Serial1.read());
  }

  static unsigned long lastUpdate = 0;
  if (millis() - lastUpdate >= 1000) {
    lastUpdate = millis();

    framebuffer.fillScreen(ST7735_BLACK);
    framebuffer.setTextColor(ST7735_WHITE, ST7735_BLACK);
    framebuffer.setTextSize(1);
    framebuffer.setCursor(5, 5);
    framebuffer.print("GPS STATUS");

    if (gps.location.isValid()) {
      float lat = gps.location.lat();
      float lng = gps.location.lng();
      int sats = gps.satellites.value();
      int alt = (int)gps.altitude.meters();

      framebuffer.setCursor(5, 20);
      framebuffer.print("Lat:");
      framebuffer.print(lat, 5);
      framebuffer.setCursor(5, 35);
      framebuffer.print("Lon:");
      framebuffer.print(lng, 5);
      framebuffer.setCursor(5, 50);
      framebuffer.print("Sats:");
      framebuffer.print(sats);
      framebuffer.print(" Alt:");
      framebuffer.print(alt);
      framebuffer.print("m");

      FirebaseJson json;
      json.set("latitude", lat);
      json.set("longitude", lng);
      json.set("satellites", sats);
      json.set("altitude", alt);

      if (Firebase.ready() && wifiConnected) {
        if (Firebase.RTDB.setJSON(&fbdo, "/gps_tracking", &json)) {
          Serial.println("Firebase: Data Sent");
        } else {
          Serial.println("Firebase Error: " + fbdo.errorReason());
        }
      }

      if (millis() - lastAPISend >= API_SEND_INTERVAL) {
        lastAPISend = millis();
        sendToAPIDualMode(lat, lng, alt, sats);
      }

      Serial.printf("Lat: %.6f, Lon: %.6f, Sats: %d\n", lat, lng, sats);

    } else {
      framebuffer.setCursor(25, 25);
      framebuffer.setTextColor(ST7735_RED, ST7735_BLACK);
      framebuffer.setTextSize(2);
      framebuffer.print("NO FIX");
      framebuffer.setTextSize(1);
      Serial.println("Searching for GPS Fix...");
    }

    if (framebuffer.getBuffer() != NULL) {
      tft.drawRGBBitmap(0, 0, framebuffer.getBuffer(), 160, 80);
    }
  }
}
