latifannurdiansyah/Laser-tag-project/(commit log)

2026-02-06 fix: security and reliability improvements
    - Move WiFi/Firebase credentials to config.h.template (security)
    - Add WiFi timeout and reconnection logic in firmware
    - Fix async/await error handling in DevTools
    - Update AGENTS.md with correct file paths
    - Add config.h to .gitignore
    - Fix null checks in JavaScript data rendering
    [LaserTagProjectFirmwareV1.ino]
2026-02-09 Add GPS-IR-Vercel firmware with config.h support
    - New firmware: gps-ir-vercel/gps-ir-vercel.ino
    - Features: GPS + TFT + SD Card + IR Receiver + Vercel API
    - Uses config.h for centralized configuration
    - WiFi: Polinema Hostpot (no password)
    - API: Vercel dashboard
    - Device ID: Heltec-IR-V1
2026-02-10 feat: extend GPS dashboard with TTN LoRaWAN support and full sensor data
    - Add extended payload struct (32 bytes) with battery, satellites, RSSI, SNR
    - Update Prisma schema with source, altitude, battery, satellites, rssi, snr fields
    - Create TTN webhook API endpoint for LoRaWAN data
    - Update dashboard UI with full sensor display (Device, Lat, Lng, Alt, Battery, Satellites, RSSI, SNR, IR Status)
    - Add visual indicators for battery level and signal strength
    - Update random data generator for testing with all fields
    - Add TTN payload decoder documentation
    - Update README with API documentation
2026-02-10 feat: add offline SD card queue with WiFi fallback
    - Add saveToSDOffline() to save data when HTTP fails
    - Add uploadFromSD() to sync queued data when WiFi is available
    - Modified wifiTask() to auto-upload from SD on WiFi connect/reconnect
    - Data queued in /offline_queue.csv format: millis,lat,lng,alt,satellites,battery,irStatus
    - Periodic SD check every 30 seconds
    - LoRaWAN continues to work regardless of WiFi status
    [heltec-ir-gps-lora-playloadttn-vercel.ino]
2026-02-10 feat: update device ID to Heltec-P1 format
    - payload.address_id = 0x00000000 (Player 1)
    - DEVICE_ID = Heltec-P1
    - Compatible dengan TTN payload decoder
2026-02-10 fix: declare lastUplink variable for OTAA retry logic
    [heltec-ir-gps-lora-playloadttn-vercel.ino]
2026-02-10 simplify: remove button and simplify OTAA output
2026-02-10 feat: remove debug prints from WiFi and SD functions
2026-02-10 feat: remove [API] and [SD-UPLOAD] debug prints
2026-02-18 fix: prevent Guru Meditation crash by replacing String with char buffers
    - Increase stack size to 16KB for all tasks
    - Replace all String objects with char buffers (snprintf)
    - Reduce interval to 1 second for faster response
    - Change JOIN_RETRY_DELAY_MS to 1 second
    [heltec-ir-gps-lora-playloadttn-vercel.ino]
2026-02-18 fix: disable ESP32-S3 ADC to prevent error messages
    - Remove analogReadMilliVolts() calls (ESP32-S3 incompatible)
    - Set battery to 0/N/A instead
    - TFT display shows 'Batt: N/A'
    [heltec-ir-gps-lora-playloadttn-vercel.ino]
2026-02-18 fix: trigger LoRa send immediately on IR received + show - when no IR
    - Add g_sendImmediately flag to trigger LoRa transmission immediately when IR is received
    - Update formatIrStatus to return '-' when address/command is 0x0
    [heltec-ir-gps-lora-playloadttn-vercel.ino]
2026-02-18 fix: use pending IR queue for reliable LoRa transmission + fix dashboard format
    - Add g_irPending, g_pendingAddress, g_pendingCommand for reliable IR data
    - Store IR data before triggering immediate LoRa TX
    - Override payload with pending IR data when available
    - Fix formatIrStatus to handle lowercase 0x0
    [heltec-ir-gps-lora-playloadttn-vercel.ino]
2026-02-19 Update Vercel URL from laser-tag-project to mygps-tracker
2026-02-19 Fix preprocessor compilation errors - use 1/0 instead of true/false
    [heltec-ir-gps-lora-playloadttn-vercel-gprs-wifi.ino]
2026-02-19 Fix compilation errors - reorder includes and type definitions
    [heltec-ir-gps-lora-playloadttn-vercel-gprs-wifi.ino]
2026-02-19 Fix TinyGSM modem definition - must be before include
    [heltec-ir-gps-lora-playloadttn-vercel-gprs-wifi.ino]
2026-02-19 Fix watchdog timer - disable hardware WDT to prevent reboot
    [heltec-ir-gps-lora-playloadttn-vercel-gprs-wifi.ino]
2026-02-19 Fix watchdog init API - use disableLoopWDT only
    [heltec-ir-gps-lora-playloadttn-vercel-gprs-wifi.ino]
2026-02-19 Fix stack overflow - move WiFi to core 0, increase stack, reduce WiFi.status calls
    [heltec-ir-gps-lora-playloadttn-vercel-gprs-wifi.ino]
2026-02-19 Fix watchdog - disable task watchdog completely and increase TFT stack
    [heltec-ir-gps-lora-playloadttn-vercel-gprs-wifi.ino]
2026-02-19 Fix compilation - remove invalid esp_task_wdt_deinit
    [heltec-ir-gps-lora-playloadttn-vercel-gprs-wifi.ino]
2026-02-19 Add GPRS firmware variants and track-http API endpoint
2026-02-19 Fix TFT task watchdog - move drawRGBBitmap inside mutex and add periodic reset
    [heltec-ir-gps-lora-playloadttn-vercel.ino]
2026-02-19 Fix TFT task - remove esp_task_wdt_reset (not available in this ESP32 core)
    [heltec-ir-gps-lora-playloadttn-vercel.ino]
2026-02-20 Update WiFi API URL to laser-tag-project.vercel.app
2026-02-20 Fix watchdog timeout - add yield() calls in LoRa join loop
    [heltec-ir-gps-lora-playloadttn-vercel-gprs-wifi.ino]
2026-02-20 Fix watchdog - add yield() in WiFi and TFT tasks, optimize intervals
    [heltec-ir-gps-lora-playloadttn-vercel-gprs-wifi.ino]
2026-02-20 Fix WiFi watchdog - add yield() in task loop, sendToWiFiAPI, and uploadFromSD
    [heltec-ir-gps-lora-playloadttn-vercel-gprs-wifi.ino]
2026-02-20 Fix TFT watchdog - increase stack size, add yield in render loop, reduce refresh rate to 200ms
    [heltec-ir-gps-lora-playloadttn-vercel-gprs-wifi.ino]
2026-02-20 Fix compilation error - wrap loraTask creation with ENABLE_LORAWAN
    [heltec-ir-gps-lora-playloadttn-vercel-gprs-wifi.ino]
2026-02-20 Fix GPRS task - increase priority 0->1, add Serial.flush() for debug output
    [heltec-ir-gps-lora-playloadttn-vercel-gprs-wifi.ino]
2026-02-20 Fix: Upload GPS data even if not fully valid, add GPRS delay for init
    [heltec-ir-gps-lora-playloadttn-vercel-gprs-wifi.ino]
2026-02-20 Add debug logging to track and logs API endpoints
2026-02-20 Fix: Always upload GPS data for debug, add GPS debug output, preserve GPS data when hasLoc=false
    [heltec-ir-gps-lora-playloadttn-vercel-gprs-wifi.ino]
2026-02-20 Fix TFT: 3 slides (GPS/LoRa/IR), status bar W:OK L:OK G:OK S:OK, always save to SD, upload when WiFi/LoRa/GPRS connected
    [heltec-ir-gps-lora-playloadttn-vercel-gprs-wifi.ino]
2026-02-20 Fix: TFT pages - 3 entries matching TFT_MAX_PAGES (GPS/LoRaWAN/IR)
    [heltec-ir-gps-lora-playloadttn-vercel-gprs-wifi.ino]
2026-02-20 Fix: Remove all setWifiPage calls - WiFi status now in TFT status bar only
    [heltec-ir-gps-lora-playloadttn-vercel-gprs-wifi.ino]
2026-02-24 fix: Update LOCAL_API_URL to correct IP 10.28.122.226
    [gps-ir-vercel.ino, heltec-ir-gps-lora-playloadttn-vercel-gprs-wifi.ino]
2026-02-24 fix: Support firmware field mapping in /api/track endpoint
    - Accept deviceId, sats, hitStatus, irCommand, irAddress from firmware
    - Map to API fields (id, satellites, irStatus, command, address)
    - Fix HTTP 400 Bad Request when WiFi sends data to Vercel
    [heltec-ir-gps-lora-playloadttn-vercel-gprs-wifi.ino]
2026-02-24 fix: Use LASERTAG_POSTGRES_URL env variable for database connection
2026-02-24 fix: Use nullish coalescing (??) to handle 0 values correctly
    - Fix lat/lng/alt/battery parsing with ?? instead of ||
    - Fix IR status to not create 'HIT: 0x0-0x0' when values are 0
    - Default lat/lng to 0 instead of NaN
2026-02-24 fix: Add timestamp to WiFi/LoRa/GPRS logs and remove local API
    - Remove [WiFi] Local: FAIL log (local API disabled)
    - Add millis() timestamp to WiFi, LoRa, and GPRS success logs
    - Format: [WiFi] Vercel: OK (code: 200) at 12345 ms
    - Format: [LoRa] TX_OK at 12345 ms (RSSI:-62 SNR:10.0)
    - Format: [GPRS] Data sent at 12345 ms
    [heltec-ir-gps-lora-playloadttn-vercel-gprs-wifi.ino]
2026-03-02 docs: Update SETUP-GUIDE.md with complete step-by-step setup guide
    Priority- Add 1: LoRaWAN → TTN → Vercel (detailed steps)
    - Add Priority 2: GPRS → ThingSpeak → Vercel (detailed steps)
    - Add Priority 3: WiFi → Vercel direct
    - Add Priority 4: SD Card backup (GPS CSV Logger)
    - Add Vercel & NeonDB setup guide
    - Add troubleshooting section for all connection methods
    - Written in Indonesian language with technical terms
